SwissMaverick/PROJ-2008_SablierElectronique/2008_SablierElectronique/doc/Images/sizesmall/IMG_MJL_☣️-arnova-7-4-final_20200913_102514366.jpg

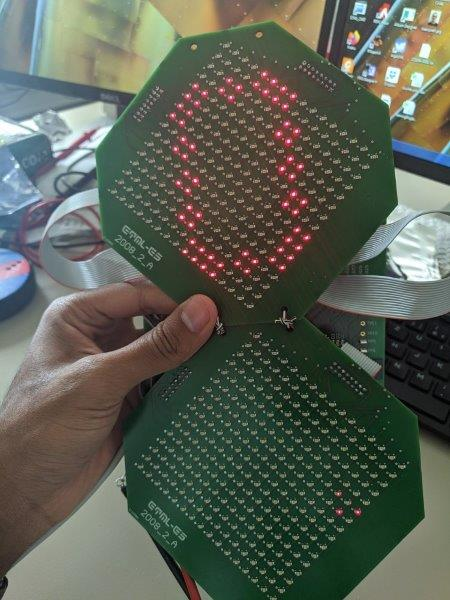
2008_SablierElectronique/doc/Images/sizesmall/IMG_MJL_☣️-arnova-7-4-final_20200913_102514366.jpg
