SwissMaverick/PROJ-2008_SablierElectronique/2008_SablierElectronique/soft/cdc_com_port_single_2008/READ ME.txt

Rodrigo Martins Silveira 

6.06.2022

Emplacement projet : C:\microchip\harmony\v2_06\apps\usb\device\cdc_com_port_single_2008
