SwissMaverick/PROJ-2008_SablierElectronique/2008_SablierElectronique/doc/PV_diplome/Procès verbal du 19.08.2020 - PBY et CRS.docx

Sujet de la séance

Procès-verbal - du 14.08.2020

Présents

Philippe Bovey

Carlos Antonio Reyes Peña

État des lieux

Le PCB est presque finis. Deux revues du schéma ont été faites.

Problèmes rencontrés

- Les capacités de découplage étaient placées sur le bottom. Il ceci c'est avéré un problème puisque ceci créais des inductances parasites.

Solutions proposées

- Le PCB ayant ce problème, je dois changer les connexions et mettre les capacités sur le top.

Décisions prises

- Le PCB sera commandé Lundi après une dernière revue

Suite du projet / objectifs

- Finir le PCB avant le 21 août 2020
- Commencer la programmation sur un kit32
- Monter le PCB
- Programmer sur la carte finale.

Prochaine réunion

28 août 2020

Destinataires de ce PV

Lausanne le 24.08.2020

Carlos Antonio Reyes Peña

Procès verbal du 19.08.2020 - PBY et CRS.docx 28.08.2020 | 2 / 1 |

Ecole supérieure, école des métiers Lausanne V.1-0 Rue de Sébeillon 12 CRS / 17.08.2020 du 28.08.2020 CH-1004 Lausanne www.etml-es.ch C:\PBO\COURS\DIPLOME\2008_SablierElectronique\Procès verbal du 19.08.2020 - PBY et CRS.docx | 1 / 1 |

ETML – Ecole supérieure
