SwissMaverick/PROJ-2008_SablierElectronique/2008_SablierElectronique/doc/Version_E/2008E_SablierElectronique-CDC-v1.docx

# Projet ETML-ES - Cahier des charges

Sablier Electronique

N° projet 2008

A remplir par l'initiateur / porteur de projet

Entreprise/Client : | ETML-ES | Département :
Demandé par (Prénom, Nom): | | Date:

A remplir par le gestionnaire de projet (étudiant)

Auteur (ETML-ES) : | Jérémie Jean-Elie | Filière : | SLO
| | Date : | 20.11.2025

# 1 But du projet

Le but de ce projet est de réaliser un sablier électronique permettant pendant les tests (travaux écrits) que les étudiants puissent visualiser le temps qu'ils leur restent à disposition.

- Le système sera alimenté par un bloc secteur universel 12VDC.
- Le sablier doit pouvoir être utilisé de manière autonome (interface utilisateur propre au boitier à l’aide de boutons et des LED du sablier) ou par une interface déportée (application C# communiquant via USB ou port série),
- En option l’étudiant pourra implémenter visualisation du sablier sur une page web via wifi.

Le programme implémenté dans le microcontrôleur devra permettre d'afficher des informations de réglage pour le sablier, gérer les différents leds (animation) et permettre une communication sérielle ou USB entre un PC et le sablier pour gérer les mêmes informations de réglage et de démarrage de séquence.

Fonctionnalités demandées

Choix de la durée du test : entre 5min et 4h

Fonction de Start/Stop

Gestion de leds quand le compte à rebours est lancé

Génération d'un son lorsque, le compte à rebours est à 0 pendant 15s et clignotement de la partie inférieure. Réglage du volume.

Une mise en boitier est demandée.

# 2 Reprise du projet

Etant donné que je reprends le projet et que celui-ci ne fonctionne que partiellement, je suis obligé de refaire en grande partie le projet.

# 3 Tâches à réaliser

## 3.1 Hardware

- Reprise du schéma existant en apportant des améliorations et corrections

- Rendre les connecteurs des matrices LED plus ergonomiques

- Corriger le câblage autour des MOSFET

- Corriger les branchements des multiplexeurs

- Corriger les câblages de la centrale inertielle

- Correction de la partie USB

- Implémenter un module ESP32 ou module similaire pour communication Wi-Fi

- Implémentation d'une alimentation avec un accu

- Recherche d’un nouveau système pour les LEDs (Utilisation d’une matrice LED déjà existante)

- Un nouveau design de carte électronique sera nécessaire

## 3.2 Software

- Implémentation communication sérielle

- Interface graphique permettant à paramétrer le sablier électronique (sur une carte déportée ou le sablier lui-même)

- Implémentation communication Wi-Fi (module ESP ou équivalent)

## 3.3 Mécanique

- Réalisation d'un boitier adapté à la nouvelle carte

# 4 Livrables

Enlever les livrables inapplicables au projet parmi la liste ci-dessous.

- Les fichiers sources de CAO électronique des PCB réalisés
- Fichiers de CAO pour le boîtier
- Tout le nécessaire à fabriquer un exemplaire hardware de chaque : fichiers de fabrication (GERBER) / liste de pièces avec références pour commande / implantation (prototype) / modifications / dessins mécaniques, etc
- Les fichiers sources de programmation microcontrôleur (.c / .h)
- Tout le nécessaire pour programmer les microcontrôleurs (logiciel ou fichier .hex)
- Le cas échéant, les fichiers sources de programmation PC/Windows/Linux.
- Le cas échéant, tout le nécessaire à l’installation de programmes sur PC/Windows/Linux.
- Un mode d’emploi du système
- Un calcul / estimation des coûts
- Un rapport contenant les calculs - dimensionnement de composants - structogramme, etc.

JJE – Nov 2025Projet-CDC-v1.docxPage 1

ECOLE SUPERIEURE PROJ – SLO
