SwissMaverick/PROJ-2008_SablierElectronique/2008_SablierElectronique/doc/Version_E/Présentation_Pre-Etude.pptx

## Projet Sablier Électronique

Rapport de Pré-Étude
Jérémie Jean-Elie | ETML-ES

## Objectifs du Projet

- • Visualiser le temps restant pour les travaux écrits (étudiants)
- • Utilisation autonome (Boutons/LEDs) ou connectée (USB/C#)
- • Option de visualisation sur page Web via Wi-Fi
- • Durée configurable de 5 min à 4 heures

## Cahier des Charges

- • Alimentation : Bloc secteur 5V ou batterie
- • Fonctionnalités : Start/Stop, Réglage volume buzzer
- • Fin de cycle : Clignotement LED + Signal sonore (15s)
- • Mécanique : Intégration dans un boîtier adapté

## État Actuel & Problématiques

- • Ce qui fonctionne : Écoulement du sable, réglage du temps
- • Défauts majeurs : Erreurs design PCB, résistance manquante
- • Manquants : Connecteurs alim/batterie, USB PC, Wi-Fi
- • Amélioration requise : Connexion matrice LEDs fragile

## Architecture Système

- • Cœur : Microcontrôleur PIC32
- • Affichage : Matrices à LEDs + Multiplexeurs
- • Capteurs : Centrale Inertielle (IAM-20680)
- • Comms : Module Wi-Fi (ESP32) & Interface USB
- • Énergie : Régulateurs Buck 3.3V

## Choix Technologiques (1/2)

- • Alimentation : Batterie LiPo/Li-Ion choisie
- - Nécessite convertisseurs DC-DC faible chute (LDO/Buck)
- • Capteur Mouvement : IAM-20680 (Centrale Inertielle)
- - Communication SPI
- - Remplace le gyroscope seul pour plus de stabilité

## Choix Technologiques (2/2)

- • Microcontrôleur : PIC32MX795F512L
- - Standard ETML (facilité de dév), Nombreuses I/O
- • Connectivité :
- - USB : Protection via chip USBLC6
- - Wi-Fi : Module ESP32 pour serveur web embarqué

## Optimisation : Commande des LEDs

- • Stratégie : Réutilisation des matrices existantes
- • Problème : Trop de MOSFETs sur la carte principale
- • Piste d'amélioration :
- - Remplacer les MOSFETs de colonnes par un Driver LED
- - Objectif : Gain de place significatif sur le PCB

## Budget et Planning

- • Budget Estimé : 123.32 CHF
- - PCB : ~80 CHF
- - Composants (PIC32, IMU, ESP32) : ~43 CHF
- • Planning : Phase de pré-étude terminée dans les délais (05.12.2025)

## Conclusion & Perspectives

- • Prochaines étapes :
- 1. Correction des erreurs de schéma (résistances, multiplexeurs)
- 2. Décision finale sur le Driver LED vs MOSFETs
- 3. Design du PCB optimisé et du boîtier
- • Objectif final : Un produit fini, autonome et connecté
