SwissMaverick/PROJ-2008_SablierElectronique/2008_SablierElectronique/README.txt

Ce dossier doit correspondre à la version B

La release corrrespondante sur Altium 365 se trouve ici (version A.2 à changer en C pour la prochaine version):

https://etml-es.365.altium.com/designs/B09EF2AC-12B8-46C2-9F97-39898C16922C/history
