SwissMaverick/PROJ-2008_SablierElectronique/2008_SablierElectronique/doc/Version_E/Rendus/2008E_SablierElectrique-Planning.pdf

No semaine projet | 1 | 2 | 3 | 4 | 5 | 6 | | | 7 | 8 | 9 | 10 | 11 | | 12 | 13 | 14 | 15 | 16 | 17 | 18 | | | 19 | 20 | 21 | 22 | 23 | 24 | 25 | 26 | 27 | 28
No semaine | 46 | 47 | 48 | 49 | 50 | 51 | 52 | 1 | 2 | 3 | 4 | 5 | 6 | 7 | 8 | 9 | 10 | 11 | 12 | 13 | 14 | 15 | 16 | 17 | 18 | 19 | 20 | 21 | 22 | 23 | 24 | 25 | 26

Date

Tâches | | | | | | | V | V | | | | | | V | | | | | | | | V | V
Pré-étude | Theorique | | | | R | P
| Réel
Design + Schéma | Theorique | | | | | | | | | | | R | P
| Réel
PCB | Theorique | | | | | | | | | | | | | | | | | | | R
| Réel
Commande PCB et composants | Théorique
| Réel
Design boitier | Théorique
| Réel
Montage | Theorique
| Réel
Software/Firmware | Theorique
| Réel
Tests et mise au point | Theorique
| Réel
Rédaction du rapport | Theorique
| Réel
Préparation présentation et démo | Theorique
| Réel
Présentation finale | Theorique | | | | | | | | | | | | | | | | | | | | | | | | | | | | | | | R | P
| Réel
Finalisation/corrections/documentation | Theorique
| Réel

13.02.2026

03.04.2023

10.04.2023

17.04.2023

24.04.2023

01.05.2023

08.05.2023

15.05.2023

22.05.2023

29.05.2023

05.06.2023

14.11.2025

21.11.2025

28.11.2025

05.12.2025

12.12.2025

19.12.2025

26.12.2025

02.01.2026

09.01.2026

16.01.2026

23.01.2026

30.01.2026

06.02.2026

20.02.2023

27.02.2023

06.03.2023

13.03.2023

20.03.2023

27.03.2023

12.06.2023

19.06.2023

26.06.2023
