SwissMaverick/PROJ-2008_SablierElectronique/2008_SablierElectronique/doc/Version_A/2008_SablierElectronique-MOD-POBJ-V1.2.docx

# Projet ETML-ES – Modification POBJ

A remplir par l'initiateur

PROJET: | Sablier Electronique
Entreprise/Client: | ETML-ES | Département: | SLO
Demandé par (Prénom, Nom): | Philippe Bovey | Date:
Objet (No ou réf, pièce, PCB...) | 2008
Version à modifier: | V1.0

A remplir par l'exécutant

Auteur (ETML-ES): | Antonio Do Carmo | Filière: | SLO
Nouvelle version: | V1.1 | Date: | 15.04.2024

# 1 Projet

## 1.1 Description sommaire du projet à modifier

Le sablier électronique est un dispositif permettant pendant les tests (travaux écrits) que les étudiants puissent visualiser le temps qu'il leur reste à disposition. Le système est alimenté par un bloc universel 12VDC et peut être utilisé de manière autonome (interface utilisateur propre au boitier) ou par une interface déportée (application C#).

## 1.2 Référence conception

Disponibles dans le dossier du projet :

K:/ES/PROJETS/SLO/2008_SablierElectronique

# 2 Objectifs principaux des modifications ou ajouts

Implémentation de la partie USB (contrôle de la famille du PIC) ou algorithme d’une communication sérielle => communication avec un PC => possibilité d’utiliser le StarterKit de l’ES pour implémenter la partie USB

Implémentation communication avec module Bluetooth et vérification du fonctionnement du module Bluetooth.

# 3 Résumé de l’état actuel

Selon la documentation du projet, la carte devrait être fonctionnelle malgré le fait que l’USB et le Bluetooth ne soient pas encore implémentés. Cependant, le circuit ne réagit pas lorsqu’il est alimenté. Aucune LED ne s’allume. Le code du projet ne compile également pas. Il est donc pour l’instant impossible de vérifier le bon fonctionnement du système.

# 4 Tâches à réaliser

## 4.1 Livrables

Je dois livrer si possible un code fonctionnel et compilable. Si cela n’est pas faisable dans les délais, je dois tout de même simplifier le code réalisé par mon prédécesseur afin que celui-ci soit compréhensible et lisible.

## 4.2 Table des tâches à réaliser

# | Priorité | Description | Fait | Approuvé

1 | 1 | Prendre connaissance du rapport de conception du projet | OK | -
2 | 1 | Prendre connaissance des datasheet des composants principaux du projet | OK | -
3 | 1 | Vérifier le fonctionnement de la carte | OK | -
4 | 1 | Trouver la panne et dépanner la carte | OK | -
5 | 2 | Rendre le code du projet compilable | OK | -
6 | 2 | Améliorer la lisibilité du code | NOK | -
7 | 3 | Créer le structogramme de la partie USB | NOK | -
8 | 3 | Implémenter la partie USB | NOK | -
9 | 3 | Vérifier le fonctionnement de la partie USB | NOK | -
10 | 3 | Créer le structogramme de la communication avec le module Bluetooth | NOK | -
11 | 3 | Implémenter la communication avec le module Bluetooth | NOK | -
12 | 3 | Vérifier le fonctionnement de la communication avec le module Bluetooth | NOK | -

# 5 Détail des modifications ou ajouts

Les tâches suivantes ont déjà été réalisées par mon prédécesseur

# | Description | Fait | Approuvé par ADO

1 | Conception du schéma électrique du projet | OK | OK
2 | Conception du PCB | OK | OK
3 | Assemblage du PCB | OK | OK
4 | Modifications sur le PCB | OK | OK
5 | Firmware du projet | OK | NOK
6 | Rapport de conception | OK | OK

# 6 Matériel nécessaire

Pour réaliser ce projet, j’aurai besoin des trois PCB assemblés du projet, du StarterKit de l’ES, du programmateur de la carte, du logiciel MPLABX et de toute la documentation disponible du projet. J’aurai également besoin d’un oscilloscope et d’un multimètre afin de dépanner la carte.

## 6.1 Stockage du fichier

Ce fichier sera stocké à la racine du dossier /doc d’un projet.

Ainsi, tous les fichiers de modifications des pièces ou PCBs faisant partie du projet sont centralisés dans le même répertoire. La numérotation devient implicite.

## 6.2 Stockage des logiciels

Les codes sources sont stockés ici :

K:/ES/PROJETS/SLO/2008_SablierElectronique/soft

Lausanne, le 15.04.2024 Antonio Do Carmo

ADO – Mar 20242008_SablierElectronique-MOD-V1.1.docxPage 1

ECOLE SUPERIEURE POBJ – SLO
