SwissMaverick/PROJ-2008_SablierElectronique/2008_SablierElectronique/archive/soft/Version_C/2008_SablierElectronique-MOD-v1.docx

# Projet ETML-ES – Modification

Note: Les textes explicatifs en italique peuvent être supprimés

A remplir par l'initiateur

PROJET:
Entreprise/Client: | | Département:
Demandé par (Prénom, Nom): | | Date:
Objet (No ou réf, pièce, PCB...)
Version à modifier:

A remplir par l'exécutant

Auteur (ETML-ES): | Rodrigo Martins Silveira | Filière: | SLO
Nouvelle version: | C | Date: | 27.06.2022

# 1 Description ou justification

Décrire ici en quelques lignes les raisons des modifications, améliorations, justifications.
Pour entreprises, si confidentiel, svp, mentionner CONFIDENTIEL.

# 2 Référence conception

Indiquer ici le(s) dossier(s) de conception de référence et emplacement. (N/A pour entreprises)

# 3 Détail des modifications

Chaque rangée du tableau ci-dessous contient le détail d'une seule modification.

Exemples:
- 1 / Changer tous les boîtiers de résistances 0805 en 0603 / OK / JMO
- 2 / Remplacement U4 - TL074 par LM124 / NOK / SCA

# | Description | Fait | Approuvé

1 | Ajouter le composant D5 (511-USBEC6-2P6) | NOK
2
3
4
5
6
7
8

# 4 Remarques

Au besoin, indiquer ici des détails nécessaires à la compréhension, ainsi que les raisons d'une modification non effectuée ou reportée.
Exemple: Le point 2 (marqué NOK), est reporté pour une prochaine version pour épuiser notre stock de composants. Cette modif n'est pas critique fonctionnellement.

# 5 Convention de nommage et liens

Le nom de ce fichier doit être unique et doit donc contenir le numéro du projet et un numéro consécutif de modification avec le format suivant :

aaii_MOD_nn.docx

ou

NomProjet_MOD_nn.docx

avec :

- MOD : pour modification
- aaii : numéro de projet, exemple 1708 pour projet de 2017 no 08
- NomProjet : Si le projet n’est pas numéroté ou mandat de client.
- nn : numéro de modification. La première est 01

Exemples :

- 1708_MOD_01.docx 1ere modification pour le projet 1708
- 1708_MOD_02.docx 2e modification pour le projet 1708
- CapteurVolets_MOD_01.docx Cas de projet externe

Le schéma et/ou les documents de production de la pièce ou du PCB se référeront à ce document dans les cartouches.

Si un nouveau projet reprend un design d’un autre projet, créer un document de modification numéro 00. Ainsi, on pourra décrire les modifications initiales dans le fichier.

Exemple :

- 1803_MOD_00.docx Modification initiale pour le nouveau projet 1803 à partir d’un autre projet (par ex. 1708)

## 5.1 Stockage du fichier

Ce fichier sera stocké à la racine du dossier /doc d’un projet.

Ainsi, tous les fichiers de modifications des pièces ou PCBs faisant partie du projet sont centralisés dans le même répertoire. La numérotation devient implicite.

JMO – Nov 2018Projet-MOD-v1.docxPage 1

ECOLE SUPERIEURE ELCO – SLO
