SwissMaverick/PROJ-2008_SablierElectronique/2008_SablierElectronique/doc/Images/Communication SPI.png

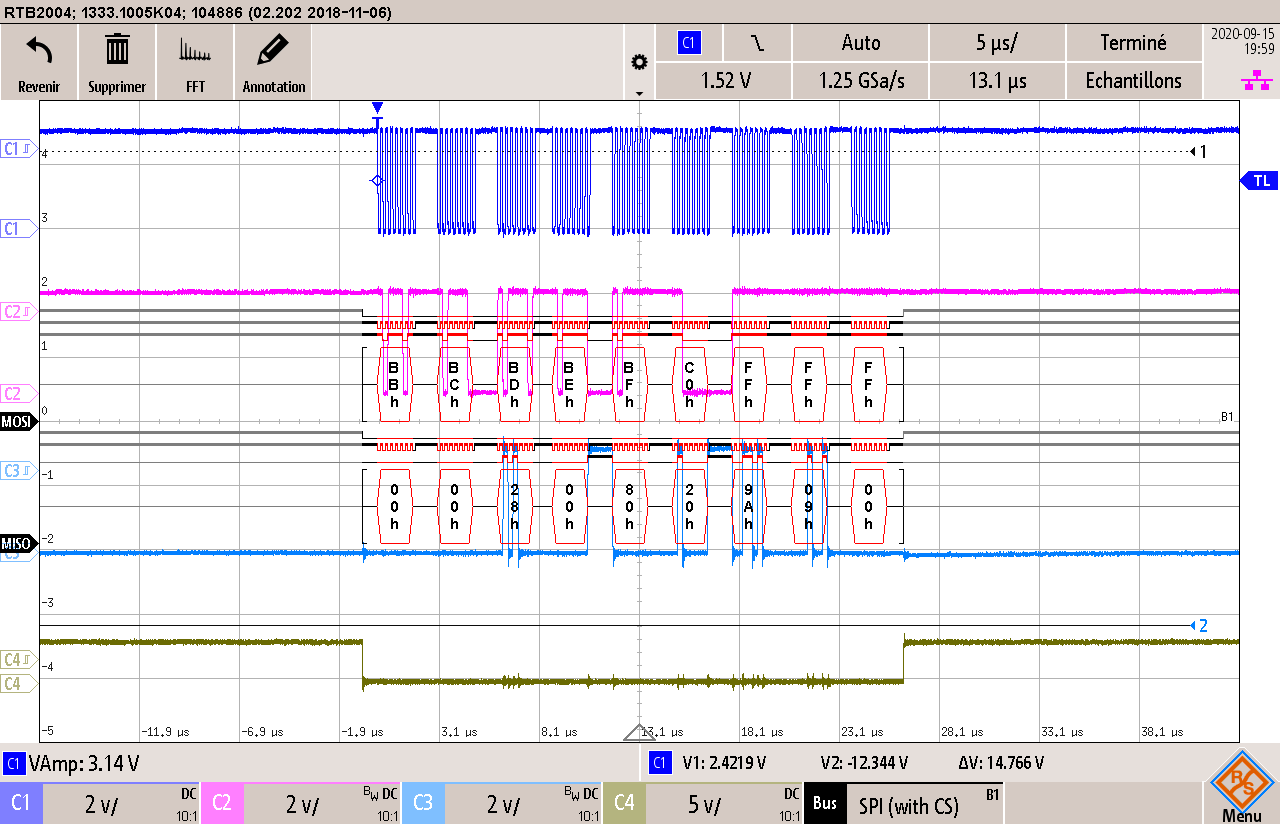
2008_SablierElectronique/doc/Images/Communication SPI.png
