SwissMaverick/PROJ-2008_SablierElectronique/2008_SablierElectronique/doc/Images/medium/IMG_MJL_☣️-arnova-7-4-final_20200913_102445338.jpg

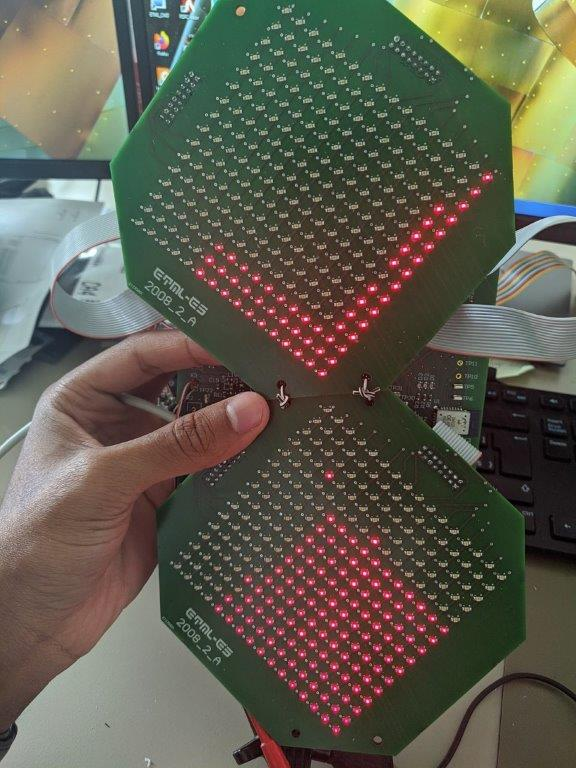
2008_SablierElectronique/doc/Images/medium/IMG_MJL_☣️-arnova-7-4-final_20200913_102445338.jpg
