SwissMaverick/PROJ-2008_SablierElectronique/2008_SablierElectronique/doc/Images/Oscillation.png

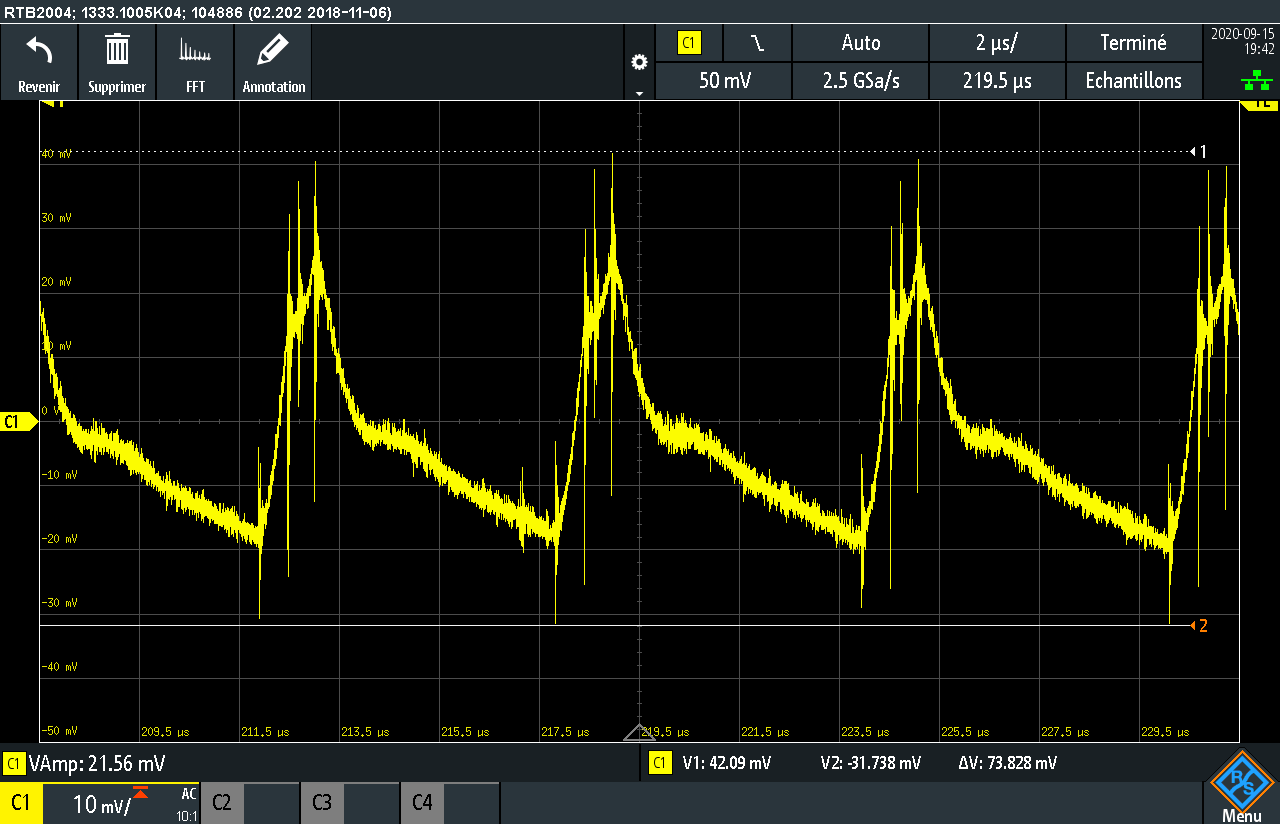
2008_SablierElectronique/doc/Images/Oscillation.png
