SwissMaverick/PROJ-2008_SablierElectronique/2008_SablierElectronique/doc/Images/sablier_dessin.png

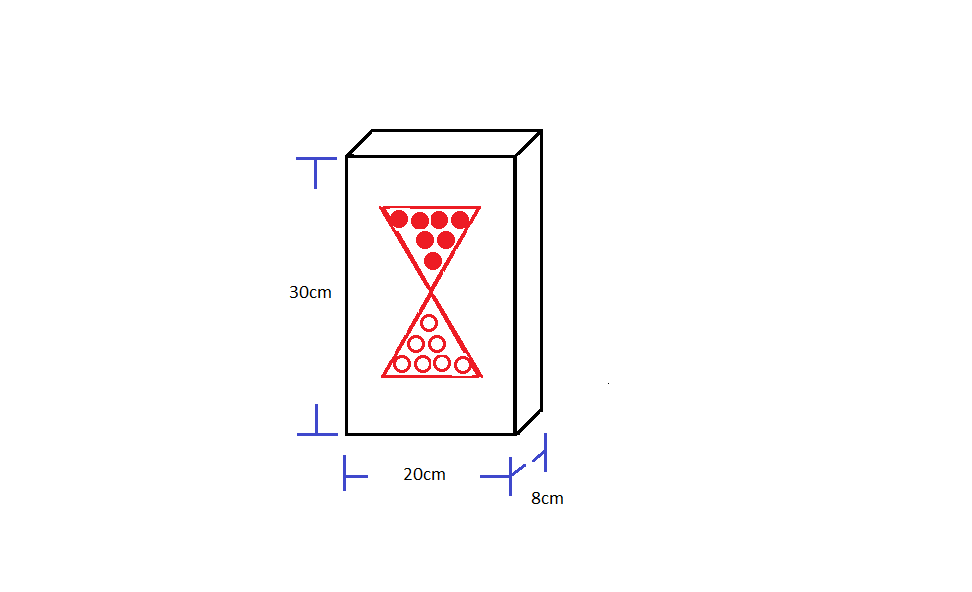
2008_SablierElectronique/doc/Images/sablier_dessin.png
