SwissMaverick/PROJ-2008_SablierElectronique/2008_SablierElectronique/doc/Version_E/Screenshots/ConfigClock2.png

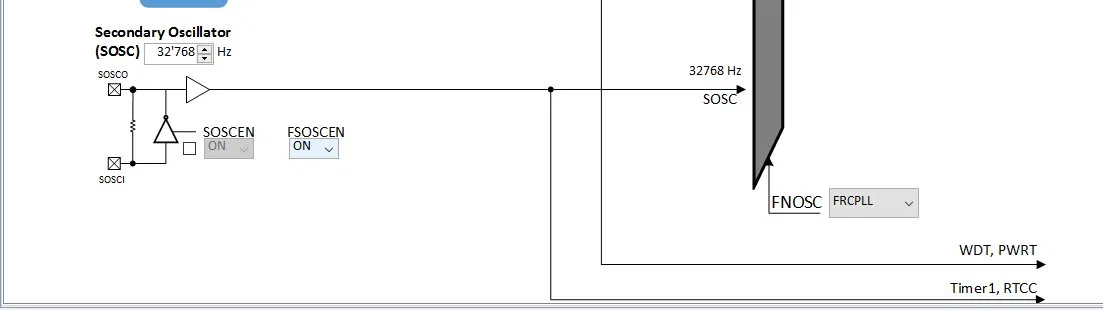
2008_SablierElectronique/doc/Version_E/Screenshots/ConfigClock2.png
