SwissMaverick/PROJ-2008_SablierElectronique/2008_SablierElectronique/soft/getXY.png

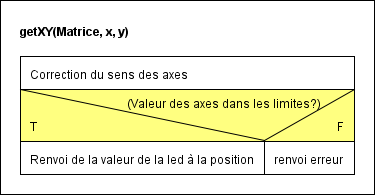
2008_SablierElectronique/soft/getXY.png
