SwissMaverick/PROJ-2008_SablierElectronique/2008_SablierElectronique/soft/setXY.png

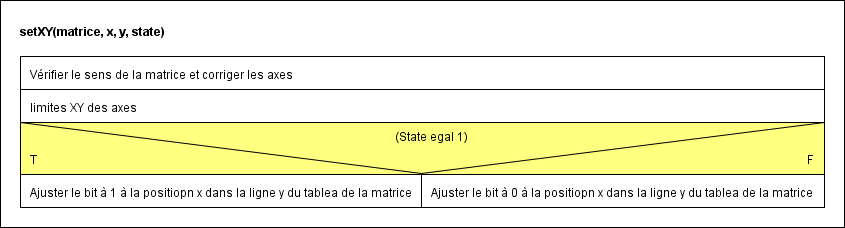
2008_SablierElectronique/soft/setXY.png
