SwissMaverick/PROJ-2008_SablierElectronique/2008_SablierElectronique/hard/2008_SablierElectronique_PCB/Project Outputs for 2008_SablierElectronique/DesignDocs/Bill of Materials.PDF

Comment | Description | Designator | Footprint | LibRef | Quantity
10uF | | C1, C12, C15 | RESC0805(2012)_LCAP1206 | | 3
4.7uF | | C2 | RESC0805(2012)_LCAP1206 | | 1
10nF | | C3 | RESC0805(2012)_LCAP1206 | | 1
100nF | | C4, C5, C6, C7, C8, CRES C0805(2012)_L CAP 1206 | | | 12
22uF | | C16 | RESC0805(2012)_LCAP1206 | | 1
KPT-2012SRC-PRV | | D1, D2, D3 | 0805_LED | KPT-2012SRC-PRV | 3
SD0805S040S0R1 | Diode Schottky 40VD 4 | | DIO SC130X 200X100- SD0805S040S0R1 | | 1
USBLC6-2P6 | | D5 | FP-SOT-666-MFG | USBLC6-2P6 | 1
Jumper | | J1 | Jumper | Jumper_2p | 1
LQM21PN1R0MCHDLQM21PN1R0MCHDL1 | | | RESC0805(2012)_L744311100 | | 1
CMI-1295IC-0385T12 mm, 3 Vdc, 85 | | dLS 1 | CUI_CMI -1295I C-0385T CMI -1295I C-0385T | | 1
Mosfet-N | | Q1, Q2, Q3, Q4, QF AIR- SOT 23-3_V | | NEMO S-G SD-3_D | 33
Mosfet P | | Q34, Q35, Q36, Q37, FAIR- SOT23- 3_V | | Mos fet P | 32
680 | | R1, R2, R3, R14, R15, RESC 0805(2012)_L RE S | | | 35
51k | | R4 | RESC0805(2012)_LRES | | 1
100k | | R5, R13 | RESC0805(2012)_LRES | | 2
10k | | R6, R7, R8, R9 | RESC0805(2012)_LRES | | 4
1k | | R10 | RESC0805(2012)_LRES | | 1
1M | | R11 | RESC0805(2012)_LRES | | 1
453k | | R12 | RESC0805(2012)_LRES | | 1
Bouton HAUT | Switch Surface MouS1 | | Header 2 pin | Switch SMD | 1
Bouton BAS | Switch Surface MouS2 | | Header 2 pin | Switch SMD | 1
Bouton H/M/S | Switch Surface MouS3 | | Header 2 pin | Switch SMD | 1
FSM4JH | Switch Push ButtonS4 | | SW_FSM4J H | FS M4JH | 1
5019 | Test point smd | TP1, TP2, TP3, TP4, T TEST POIN T_SMD | | TE STPO INT | 23
5019 | Test point smd | TP10, TP11, TP12, TTES TPOIN T_SMD _VTES TPOINT_via | | | 8
MCHP-RN4020-MODULE-24 | | U1 | MCHP-MODULE-24_VMCHP-RN4020-MO | | 1
MC-32B-MX795-SQ100 | | U2 | TQFP-PT100_N | MC-32B-MX795-SQ | 1
STM-L3GD20H-LGA-16_A | | U3 | STM-LGA-16 | STM-L3GD20H-LGA | 1
TLV62585PDRLR | 2.5V-5.5V input, 3-U4 | | SOT563 | T LV 62585P D RL R | 1
CD74HCT4067 | | U5, U6 | SOIC24 | CD74HCT4067 | 2
ICD | | X1 | CON6 | Header 6 pins | 1
USB | | X2 | CON4 | Header 4 pin | 1
Alimentation | Connector Header | X3 | Header 2 pin | Header 2 pin | 1
Lignes haut | | X4 | CON8x8(edited) | Mâle DIN 8 x 8 | 1
Lignes bas | | X5 | CON8x8(edited) | Mâle DIN 8 x 8 | 1
Colonnes haut | | X6 | CON8x8(edited) | Mâle DIN 8 x 8 | 1
Colonnes bas | | X7 | CON8x8(edited) | Mâle DIN 8 x 8 | 1
