SwissMaverick/PROJ-2008_SablierElectronique/ComposantsStandardsES.xlsx

Sheet: Comp Standard - PROJ-DIPL
MCUs
Fabricant | Composant | Boîtier | Description | Emplacement | Stock | Distributeur 1 | Distrbuteur 1 ref | Distributeur 2 | Distrbuteur 2 ref | Remarque
Microchip | PIC32MX130F064B | 28-pin SSOP | PIC32 40MHz 16kRAM, 256kFlash | D2 | 10+ | Digi-Key | PIC32MX130F064B-I/SS-ND | Mouser | 579-MX130F064BISS
 | PIC32MX130F256B | 28-pin SSOP | PIC32 40 MHz 16kRAM, 256kFlash | D2 | 0 | Digi-Key | PIC32MX130F256B-I/SS-ND | Mouser | 579-MX130F256BISS
 | PIC32MX130F064B | 28-pin SOIC | PIC32 40MHz 16kRAM, 256kFlash | D2 | 6 | Digi-Key | PIC32MX130F064B-I/SO-ND
 | PIC32MX230F256D-I/PT | 44-pin TQFP | PIC32 40MHz 16kRAM, 256kFlash | D2 | 40 | Digi-Key | PIC32MX230F256D-I/PT-ND | Mouser | 579-MX230F256DIPT
 | PIC32MX340F512H | 64-pin TQFP | PIC32 80 MHz 23kRAM, 512kFlash | D3 | 1 | Digi-Key
 | PIC32MX795F512H | 64-pin TQFP | PIC32 80 MHz 128kRAM, 512kFlash | D2 | 8 | Digi-Key
 | PIC32MX795F512L | 100-pin TQFP | PIC32 80MHz 128kRAM, 512kFlash | D2 | 3 | Digi-Key | PIC32MX795F512LT-80I/PTCT-ND |  |  | MCU kit MINF
 | PIC32MK0512MFC064 | 64-pin TQFP | PIC32 128kRAM, 512kFlash, Motor Control | D2 | 9 | Digi-Key | PIC32MK0512MCF064-I/PT-ND
 | PIC32MM0064GPL020-I/SS | 20-pin SSOP | PIC32 8KB RAM, 64kFlash, low power | D2 | 9 |  |  | Mouser | 579-MM0064GPL020ISS
STMicroelectronics | STM32F051R8T6 | 64-pin TQFP | MCU ARM STM32 Cortex-M0, 32 bits, 48 MHz, 64 KB | D2 | 20 | Farnell | 3129877 |  |  | MCU kit ELNU02
Composants électromécaniques - Connecteurs - Points test - Switches
Fabricant | Composant | Boîtier | Description | Emplacement | Stock | Distributeur 1 | Distrbuteur 1 ref | Distributeur 2 | Distrbuteur 2 ref | Remarque
Amphenol | 76384-406LF | 6pin mâle | Dubox pour Port de programmation PIC32 (voir onglet) | D1 | 10+ | Digi-Key | 76384-406LF
Keystone Electronics | 5017 |  | PC TEST POINT MINIATURE | D1 |  | Digi-Key | 36-5017CT-ND
Keystone Electronics | 5019 |  | PC TEST POINT MINIATURE | Bobine étagère |  | Digi-Key | 36-5019CT-ND
Schurter | 1241.1082 |  | SWITCH TACT SPST-NO 0.125A 48V (MTG Series) | D1 | 10+ | Digi-Key | chercher 1241.1082
Wurth Electronics Inc. | 430182043816 |  | SWITCH TACTILE SPST-NO 0.05A 12V | D1 | 50 | Digi-Key | 732-7004-1-ND
Wurth Electronics Inc. | 629105136821 |  | CONN RCPT USB2.0 MICRO B SMD R/A | D1 | 10 | Digi-Key | 732-3155-1-ND
Wurth Electronics Inc. | 629105150521 | signaux SMT, chassis trou traversant | CONN RCPT USB2.0 MICRO B SMD R/A | D1 | 0 | Digi-Key | 732-5960-1-ND
Composants de base - RESISTANCES - COND- SELFS - BJT - MOS - DIODES - LED
Fabricant | Composant | Boîtier | Description | Emplacement | Stock | Distributeur 1 | Distrbuteur 1 ref | Distributeur 2 | Distrbuteur 2 ref | Remarque
 | RES 0Ω | 0805 | Résistance pont | Bobine étagère
 | RES 10Ω - 10MΩ | 0805 | Gamme de Résistances série E24 | Bobines étagère
 | CAP 10/22/100 pF | 0805 | Gamme Capacités en pF /50V | Bobines étagère
 | CAP 1/2.2/10/100 nF | 0805 | Gamme Capacités en nF /50V | Bobines étagère
 | CAP 1/10 uF | 0805 | Gamme Capacités en uF /10V | Bobines étagère
Panasonic | CAP 10 uF / 16V | SMD D4 x L5.4 | CAP polarisé électrolytique EEEFC1C100R | Bobine étagère
Panasonic | CAP 100 uF / 16V | SMD D8 x L5.8 | CAP polarisé électrolytique EEEFC1C101P | Bobine étagère
Panasonic | CAP 100 uF / 35V | SMD D10 x L10.2 | CAP polarisé électrolytique EEEFC1V101P | Bobine étagère
Panasonic | CAP 220 uF / 35V | SMD D4 x L5.7 | CAP polarisé électrolytique EEEFC1V221P | Bobine étagère
Bourns | Self 150uH -SDR0604-151KL |  | FIXED IND 150UH 400MA 1.1OHM SMD | Bobine étagère |  |  | SDR0604-151KLCT-ND
OSRAM | LH R974 | CHIPLED 0805 | LED hyper red | Bobine étagère
OSRAM | LY R971 | CHIPLED 0805 | LED yellow | Bobine étagère
OSRAM | LG R971 | CHIPLED 0805 | LED green | Bobine étagère
LittleFuse | TVS SMAJ5.0A |  | TVS DIODE 5V 9.2V DO214AC | Bobine étagère |  |  | SMAJ5.0ALFCT-ND
STMicroelectronics | BC847B |  | TRANS NPN 45V 0.1A SOT-23 | Bobine étagère |  |  | 497-2524-1-ND
STMicroelectronics | BC857B |  | TRANS PNP 45V 0.1A SOT23 | Bobine étagère |  |  | 497-2526-1-ND
International Rectifier | IRLML2402PbF | SOT23-3 | MOSFET N-CH 20V 1,2A SOT-23 logic level | Bobine étagère
ON semiconductor | BSS138 | SOT23-3 | MOSFET N-CH 50V 220MA SOT-23 | D1 | 20+ | Digi-Key | BSS138CT-ND
ON semiconductor | BAS40 | SOT23-3 | DIODE SCHOTTKY 40V 120MA BAS40LT1G | Bobine étagère |  | Digi-Key | BAS40LT1GOSCT-ND
ON semiconductor | SS14 |  | DIODE SCHOTTKY 40V 1A | Bobine étagère |  | Digi-Key | SS14CT-ND
ON semiconductor | BAS16 |  | DIODE GEN PURP 85V 200MA SOT23-3 | Bobine étagère |  |  | BAS16FSCT-ND
 | 1N5819 |  | DIODE SCHOTTKY 40V 1A
Micro Commercial | 1N4448W-TP | SOD-123 | DIODE GEN PURP 75V 250MA | D1 |  | Digi-key | 1N4448WTPMSCT-ND
Diodes Incorporated | D5V0P4UR6SO-7 | SOT-23-6 | TVS DIODE 3.3VWM 6VC SOT26 (4 channels) | D1 |  | Digi-Key | D5V0P4UR6SO-7DICT-ND | Mouser | 621-D5V0P4UR6SO-7
Wurth Electronics Inc. | 8240136 | SOT-143-4 | TVS DIODE 3.3V 6V SOT143-4 (2 channels) | D1 |  | Digi-Key | 732-4472-1-ND | Mouser | 710-8240136
STMicroelectronics | USBLC6-2SC6 | SOT-23-6 | TVS DIODE 5.25V 17V SOT23-6 (2 data-line) | D1 |  | Digi-Key | 497-5235-1-ND
Nexperia+divers | BAT54S | SOT-23 | Schottky diode dual | A stocker |  | Mouser | 771-BAT54S-T/R
IC analogiques - OP AMP - COMP.
Fabricant | Composant | Boîtier | Description | Emplacement | Stock | Distributeur 1 | Distrbuteur 1 ref | Distributeur 2 | Distrbuteur 2 ref | Remarque
STMicroelectronics | LF347 | 14-SOIC | IC AOP LF347M - WIDE BW- 4x J-FET OP AMP | D1 | 25+ | Digi-Key | 497-2963-2-ND
Texas Instruments | LM339MX/NOPB | 14-SOIC | IC COMPARATOR QUAD LO PWR 14SOIC | D1 | 50+ | Digi-Key | LM339MX/NOPBCT-ND
Texas Instruments | LM385M/NOPB | 14-SOIC | IC VREF SHUNT 5.3V 2% 8SOIC | D1 | 50+ | Digi-Key | LM385M/NOPB-ND
ICs spécialisés
Fabricant | Composant | Boîtier | Description | Emplacement | Stock | Distributeur 1 | Distrbuteur 1 ref | Distributeur 2 | Distrbuteur 2 ref | Remarque
Microchip | MCP79411T-I/SN | 8-SOIC | IC RTC CLK/CALENDAR I2C |  |  | Digi-Key | MCP79411T-I/SNCT-ND
EPSON | FC-135 32.7680KA-K3 |  | CRYSTAL 32.7680 KHZ 10.0PF SMD |  |  | Digi-Key | SER4088CT-ND
EPSON | FC-135 32.7680KA-A5 |  | CRYSTAL 32.7680 KHZ 12.5PF SMD |  |  | Digi-Key | SER4103CT-ND
ON semiconductor | LV8760-TLM-E | 20TSSOP | IC MOTOR DRIVER 3V-5.5V/9-35V - w/ Current Limiter |  |  | Digi-Key | 869-1256-1-ND
Maxim | MAX7219CWG+-ND | 24-SOIC | IC DRVR 7 SEGMNT 8 DIGIT |  |  | Digi-key | MAX7219CWG+-ND
Microchip | MCP3422 | 8-SOIC | ADC 18-BIT SIGMA-DELTA |  | 10+ | Digi-Key | MCP3422A0-E/SN-ND
FTDI | FT230XS | 16-TSSOP | USB SERIAL BASIC UART 16SSOP |  | 5+ | Digi-Key | 768-1154-5-ND | Mouser | 895-FT230XS-U
Cypress | CY7C64225 | 28-TSSOP | UST to UART bridge |  | 5+ | Digi-Key | CY7C64225-28PVXC
Texas Instruments | TLC555CDR | 8-SOIC | IC OSC SGL TIMER 2.1MHZ 8-SOIC |  | 5 | Digi-Key | 296-1336-2-ND
Circuits et composants d'alimentation
Fabricant | Composant | Boîtier | Description | Emplacement | Stock | Distributeur 1 | Distrbuteur 1 ref | Distributeur 2 | Distrbuteur 2 ref | Remarque
Texas Instruments | LM2674MX-5.0/NOPB | 8-SOIC | IC REG BUCK 5.0V 500MA 8SOIC | D1 |  | Digi-key | LM2674MX-5.0/NOPBCT-ND
Texas Instruments | LM2674MX-3.3/NOPB | 8-SOIC | IC REG BUCK 3.3V 500MA 8SOIC | D1 | 15 | Digi-key | LM2674MX-3.3/NOPBCT-ND
Texas Instruments | LM2674MX-ADJ/NOPB | 8-SOIC | IC REG BUCK ADJ 500MA 8SOIC | D1 |  | Digi-key | LM2674MX-ADJ/NOPBCT-ND
Texas Instruments | LM2675M-5.0 | 8-SOIC | IC REG BUCK 5V 1A 8SOIC | C4 | 20+ | Digi-key | LM2675M-5.0-ND
Texas Instruments | LM3578-AM | 8-SOIC | IC REG MULTI CONFG 750MA - Buck/Boost positive/negative | C4 | 20+ | Digi-key | LM3578AM/NOPB-ND
Microchip | MIC5504-3.3YM5-TR | SO-T23-5 | IC REG LINEAR 3.3V 300MA | D1 |  | Digi-key | 576-4764-1-ND
Microchip | MCP73871-2CC | 20-QFN (4x4) | USB/AC BATTERY CHARGER | D1 |  | Digi-key | MCP73871T-2CCI/ML |  |  | Attention plusieurs variantes d'IC selon la tension del'accu Li
Maxim | MAX1793EUE33+ | 16TSSOP | IC REG LINEAR POS ADJ 1A | D1 |  | Digi-Key | MAX1793EUE33+-ND
Wurth Electronics Inc. | 173950336 | Module 3-SIP | DC DC CONVERTER 3.3V 0.5A | D1 |  | Digi-Key | 732-173950336-ND
Wurth Electronics Inc. | 173950536 | Module 3-SIP | DC DC CONVERTER 5.0V 0.5A | D1 |  | Digi-Key | 732-173950536-ND
Autres
Fabricant | Composant | Boîtier | Description | Emplacement | Stock | Distributeur 1 | Distrbuteur 1 ref | Distributeur 2 | Distrbuteur 2 ref | Remarque
Digi-Key | PCB-RULER-12INCH | NA |  | Bureau JMO |  | Digi-Key | PCB-RULER-ND

Sheet: Port de programmation PIC32
Pin 1 = MCLR

Sheet: Composants A3
Fabricant | Composant | Boîtier | Description | Emplacement | Stock | Distributeur 1 | Distrbuteur 1 ref | Distributeur 2 | Distrbuteur 2 ref | Remarque
Siemens | TCA 965 | 14-DIP | Window Discriminator | A3 | 10
Texas Instruments | TLC251 | 8-DIP | LinCMOS LOW-POWER A.O | A3 | 4
Texas Instruments | TLC271 | 8-DIP | LinCMOS LOW POWER A.O | A3 | 9
Texas Instruments | TLC274 | 14-DIP | LinCMOS PRECISION QUAD A.O | A3 | 2
Texas Instruments | TLC555 | 8-DIP | LinCMOS Timer | A3 | 5
Texas Instruments | TLC556 | 17-DIP | DUAL LinCMOS Timers | A3 | 12
Texas Instruments | TL071 | 8-DIP | Low-Noise FET-Input A.O | A3 | 13
Texas Instruments | TL074 | 14-DIP | Low-Noise FET-Input A.O | A3 | 20+
Texas Instruments | TLC374CN | 14-DIP | LinCMOS Quad. Differential Comp. | A3 | 2
MAXLINEAR | 2208CP | 14-DIP | Operational Multiplier | A3 | 2
maxim integrated | TSC428 | 8-DIP | MOSFET DRIVER | A3 | 20+
maxim integrated | TSC429 | 8-DIP | MOSFET DRIVER | A3 | 14
maxim integrated | TSC426 | 8-DIP | MOSFET DRIVER | A3 | 10
Linear technology | LM308H | Metal case H pack | Amplificateur opérationel, single Bip | A3 | 30+
Texas Instruments | LM311P | 8-DIP | IC DIFF COMP W/STROBE 8DIP | A3 | 10+ | Digi-Key | 296-1389-5-ND
Texas Instruments | LM319N | 14-Pins CDIP | High Speed Dual Comparator | A3 | 1
Texas Instruments | LM317H | Metal Can Package 3-Pin | Temperature Three-Pin Adjustable Regulator | A3 | 4
Texas Instruments | LM339AN | 14-Pin CLGA | Quad Comparators | A3 | 10+
Texas Instruments | LM324AN | 14-Pin SOIC | Operational Amplifiers | A3 | 10+
Motorola semiconductor | LM339NE4-ND | 14-DIP | Comparator-linear | A3 | 10+ | Digi-Key
Texas Instruments | LM347N | 14-DIP | Hysteretic PFET Buck Controlle | A3 | 6
Texas Instruments | LM358N | 8-SOIC | IC OPAMP GP 2 CIRCUIT 8DIP | A3 | 20+ | Digi-Key | LM358NNS/NOPB-ND
National Semiconducteur Comporation | LM377N | 14-DIP | 2 watt audio AMplifier | A3 | 6
National Semiconducteur Comporation | LM390N | Dual-In-Line Package | 1W Battery Operated Audio Power Amplifier | A3 | 10+
Texas Instruments | TLC556N | 14-DIP | DUAL LinCMOS TIMERS | A3 | 7
STMicroelectronics | LM317T | TO-220 | 1.2 V to 37 V adjustable voltage regulators | A3 | 20+
STMicroelectronics | L6506A | 18-DIP | CURRENT CONTROLLER FOR STEPPING MOTORS | A3 | 5
Texas Instruments | LF412CP | 8-DIP | Dual JFET-input Operational Amplifier | A3 | 6
Linear technology | LM108AH | Metal case H pack | AOP | A3 | 10+
STMicroelectronics | LM335Z | TO-92 | Precision temperature sensors | A3 | 10
Texas Instruments | LM6364N | 8-DIP | High Speed Operational Amplifier | A3 | 1
Texas Instruments | LM6134 | 14-Dip | Low Power 10 MHz Rail-To-Rail, AOP | A3 | 6
Texas Instruments | LM297 | 20-Dip | STEPPER MOTOR CONTROLLERS | A3 | 3
Texas Instruments | P9330-ADC0804LCN | 20-Dip | 8-Bit, µP-Compatible, Analog-to-Digital Converters | A3 | 1
Philips | TDA1010A | SIL-9 | Audio Power Amplifier | A3 | 3
plessey | TDA2090 | 14-DIP | Zero Voltage Switch | A3 | 9
Texas Instruments | LM336 | 8-SOIC | Shunt Regulator Diode | A3 | 4
STMicroelectronics | L292 |  | Switch-Mode Driver DC Motors | A3 | 1
Texas Instruments | LF398 |  | Monolithic Sample-and-Hold Circuits | A3 | 4
philips | SAA 1027 |  | Stepper Motor Drive Circuit | A3 | 2
Thomson | UAA4006B |  | Switch Mode Power Supply Control Circuit | A3 | 4
Intersill | ICL 7650 SCPD |  | Super Chopper-Stabilized A.O. | A3 | 2
Texas Instruments | ULN2003 AM |  | High-Current Darlington Transistor Arrays | A3 | 20+
 | ULN2803 |  | Darlington Transistor Arrays | A3 | 17
 | PLL NE 565 |  | Phase-Locked Loop | A3 | 16
Texas Instruments | UC3637 |  | Switch Mode Controller DC Motor Drive | A3 | 2
Texas Instruments | LM2907 |  | Frequency to Voltage Converter | A3 | 1
 | PMI MUX28 |  | JFET Analog Multiplexers | A3 | 1
ON semiconductor | MC14528B |  | Dual Monostable Multivibrator | A3 | 1

Sheet: Composants A4
Composants traversants ou SMD à consommer. Obsolètes ou non renouvelés
Fabricant | Composant | Boîtier | Description | Emplacement | Stock | Distributeur 1 | Distrbuteur 1 ref | Distributeur 2 | Distrbuteur 2 ref | Remarque
Mouser | BTS117 | TO-220-3 | Smart Low Side Power Switch |  |  | Mouser
FAIRCHILD | CD4066BCN | DIP-14 | Quad Bilateral Switch
National Semiconductor | DAC0808LCN | DIP-16 | 8-bit D/A Converter |  |  | mouser
Ciliconix | DG243CJ | DIP-16 | General Purpose Analog Switch
Vishay Siliconix | DG271 | DIP-16 | Low-Voltage Analog Switch
Texas Instruments | LM348N | PDIP-14 | Operational Amplifier |  |  | Mouser
STMicroelectronics | LM7805C | To-220-3 | Positive fixed voltage regulator |  |  | Mouser
ON Semiconductor | MC14013BCP | DIP-16 | Dual Type D Flip-Flop
Motorola | MC14025B | DIP-14 | B-Suffix Series CMOS Gates
ON Semiconductor | MC14043BCP | DIP-16 | Quad R-S Latches
Motorola | MC14044B | DIp-16 | CMOS MSI |  |  | Farnell
ON Semiconductor | MC14049U | DIP-16 | HEx Buffers
ON Semiconductor | MC14051B | DIP-16 | Multiplexers/demultiplexers |  |  | Farnell
Motorola | MC14072B | DIP-14 | Semiconductor Technical DATA
Texas Instruments | MC1408P8 | DIP-18 | Digital Analogic converter |  |  | Mouser
ON Semiconductor | MC14099BCP | DIP-16 | Verrous 3-18V 8bit |  |  | Mouser
Motorola | MC14411 | DIP-24 | Bit Rate Generator
Motorola | MC14495P | DIP-16 | Hecadecimal-to-segment Latch |  |  | Farnell
ON Semiconductor | MC14528BCP | PDIP-16 | Multivibrateur monostable 3-18V |  |  | Mouser
Texas Instruments | RC4151NB | PDIP-8 | Converter [V]-[Hz] and [Hz]-[V] |  |  | Mouser
Siemens | SAB0529 | DIP-18 | Programmable Digital Timer
Texas Instruments | SN74HC160N | DIP-16 | Decade counter
Texas Instruments | SN74LS00N | DIP-14 | Positive-NAND Gate
Texas Instruments | SN74LS86AN | DIP-16 | Quadruple 2-Input XOR
Philips Semiconductors | TDA1524A | DIP-18 | Volume control circuit
Texas Instruments | ULN2003A | DIP-16 | Transistor Array
Panasonic | TQ2-L2-5V |  | Relais signal faible |  |  | mouser

Sheet: Stock Ics D3
Stock Ics - Obsolètes ou non renouvelés
Fabricant | Composant | Boîtier | Description | Emplacement | Stock | Distributeur 1 | Distrbuteur 1 ref | Distributeur 2 | Distrbuteur 2 ref | Remarque
 | 7440 |  | 4 Input NAND
 | 202ECPZ |  | RS-232 Transmitter/Reciever
 | 20AS25HBI |  | CAN
 | 296-11301-5 |  | IC REG CTRLR MULT TOPOLOGY 16DIP |  |  | Digi-Key | 296-11301-5-ND
 | 74LS604N |  | Latch de Multiplexage
 | 74LS645 |  | Bus bidirectionnel
 | AM1702ADC |  | EPROM
 | D8202A |  | MicroProcesseur
 | D8259AC-2 |  | Soft Core - Interrupt Controller
 | HIN202CPZ |  | Émetteur-récepteur 2/2 Complète RS232 16-PDIP |  |  | Digi-Key | HIN202CPZ-ND
 | HN58C65P-25 |  | 8192-Word X 8 bit EEPROM
 | LM331N |  | Convertisseur Volt to Fréquency
 | M54528p |  | 7- unit 150mA Darlington Trans. Array
 | MAX232 |  | Pilotes Rx/Tx RS-232
 | MC14506 |  | Dual 2-wide 2-input expandable
 | MC1458P |  | Usage général Amplificateurs 2 Circuits 8-PDIP |  |  | Digi-Key | 296-1403-5-ND
 | MC356P |  | Timer circuit
 | MC74F182N |  | Carry Generator
 | P8284A |  | Generateur de clock
 | PALCE22V10 |  | PAL Device
 | PIC16F84A-20/P |  | IC MCU 8BIT 1.75KB FLASH 18DIP |  |  | Digi-Key | PIC16F84A-20/P-ND
 | PIC16F88 |  | MicroContrôleur
 | PIC18F4520-I/P |  | MicroContrôleur
 | PIC18F452-I/L |  | PIC PIC® 18F Microcontrôleurs IC 8 bits 40MHz |  |  | Digi-Key | PIC18F452-I/L-ND
 | SN74LS373N |  | Verrou transparent de type D 1 canal 8:8 IC Trois états 20-PDIP |  |  | Digi-Key | 296-1660-5-ND
 | SN74LS377N |  | Bascules 1 Élément Type D 8 Bit Front positif |  |  | Digi-Key | 296-1663-5-ND
 | tl 7770-5 |  | Superviseur Complémentaire 2 canal 16-PDIP |  |  | Digi-Key | 296-3266-5-ND
 | TNY267N |  | Switching Regulator
 | UC3709N |  | Driver de Puissance
 | UC3841N |  | PWM/Switch Controller
 | UPD-41256C-15 |  | Dynamic RAM
 | Upd416c-2 |  | 416 RAM NEC PD416C-2 DRAM
 | UPD-70116C-8 |  | MicroProcesseur
 | UPD-8251AFC |  | Universal USART/UART
 | UPD-8255AC-2 |  | I/O Programmable to MicroProcesseur
 | V61C16S35L |  | Standard SRAM 2KX8
Raytheon | RC4152N | DIP8 | VOLTAGE-TO-FREQUENCY CONVERTER |  | 12
 | 7702 | SO8 | Voltage Supervisor |  | >20
 | LF347M | SOIC14 | JFET 4x OPAMP |  | >50
 | SN65HVD06 | SO8 | High Output RS 485 Transceiver |  | >30

Sheet: Kits PIC
Liste des kits, modules, dev boards MICROCHIP à disposition au bureau des enseignants
Nombre | P/N Microchip | Description | Features | MCU | Prix
1 | AC164127-3 | graphics pictail plus daughter card kit
1 | AC164136-2 | ZeroG Wifi PICTAIL/PICTAIL PLUS DAUGHTER BOARD |  |  |  | Obsolete
1 | AC320006 | PIC32MZ STARTER KIT ADAPTER BOARD | 168-pin to 132-pin connector |  | $78.00
1 | BM-64-EVB-C2 | BM64 BLUETOOTH AUDIO EVALUATION BOARD | BT 4.2 Audio, 3W Audio Amp, NFC, I/Os |  | $197.00
1 | DM320002 | STARTER KIT I/O EXPANSION BOARD | provides Starter Kit and Starter Board users with full access to MCU signals, additional debug headers, and connection of PICtail Plus daughter cards |  | $94.00
1 | DM320003-2 | PIC32 USB STARTER KIT II | provides the easiest and lowest cost method to experience the USB and CAN functionality of the PIC32 microcontrollers |  |  | Obsolete
2 | DM320004 | PIC32 ETHERNET STARTER KIT | method to experience 10/100 Ethernet development with PIC32. Available CAN 2.0b peripheral and USB host/device/OTG |  | $120.00
2 | DM320005 | MULTIMEDIA EXPANSION BOARD | 3.2 inch (8.1 cm) QVGA touch screen display with backlight, Four-way joystick, headphone/line jacks PicTail compatible |  |  | Replaced by DMA320005-5
1 | DM320107 | PIC32MM USB CURIOSITY DEVELOPMENT BOARD | 2 X mikroBUS™ interfaces for click boards™ | PIC32MM0256GPM064 | $38.00
1 | EV31E34A | PIC32MK MCM CURIOSITY PRO DEVELOPMENT BOARD | 2 X mikroBUS™ interfaces for click boards™, 2x DB9 CAN-FD, I/Os, USB Host and USB Device | PIC32MK MCM | $115.00
1 | MA240015 | PIC24FJ256GA110 PLUG-IN-MODULE | PIM plugs into the Explorer 16 Development Board (DM240001) | PIC24FJ256GA110 | $34.00
1 | MA320001 | PIC32MX360F512L PLUG IN MODULE | PIM plugs into the Explorer 16 Development Board (DM24000x) | PIC32MX360F512L | $34.00
2 | TCHIP011 | CHIPKIT™ FUBARINO MINI DEVELOPMENT BOARD |  | PIC32MX250F128D | $22.00
? | DM240001 | EXPLORER 16 DEVELOPMENT BOARD WITH 100-PIN PIM | 16 x 2 LCD display, TC1047A temp sensor, PICTailTM Plus connector expansion
 | MA320024 | PIC32MK1024 Motor Control PIM
 | MA320211 | PIC32MK MCM Motor Control PIM
 |  | 1
