SwissMaverick/PROJ-2008_SablierElectronique/2008_SablierElectronique/hard/2008_SablierElectronique.xls

Designator | Comment | Description | Footprint | Quantity | Supplier 1 | Supplier Part Number 1 | Price
U3 | IAM-20680 |  | STM-LGA-16 | 1 | Mouser | 410-IAM-20680 | 13.89
U4 | TLV62585PDRLR | 2.5V-5.5V input, 3-A high efficiency step-down converter in 2x2 QFN or SOT563 package 6-SOT-5X3 -40 to 125 | SOT563 | 1 | Mouser | 595-TLV62585PDRLR | 0.55
U5, U6 | CD74HCT4067 |  | SOIC24 | 2 | Mouser | 595-CD74HC4067M | 0.851
D4 | SD0805S040S0R1 | Diode Schottky 40V 100mA (DC) Surface Mount 0805 (2012 Metric) | DIOSC130X200X100-2N | 1 | Mouser | 581-SD0805S040S0R5 | 0.4
U1 | MCHP-RN4020-MODULE-24 |  | MCHP-MODULE-24_V | 1 | Mouser | 579-RN4020-V/RM120 | 8.08
U2 | MC-32B-MX795-SQ100 |  | TQFP-PT100_N | 1 | Mouser | 579-PIC32MX795F512 | 8.61
TP1, TP2, TP3, TP4, TP5, TP6, TP7, TP8, TP9, TP18, TP19, TP20, TP21, TP22, TP23, TP24, TP25, TP26, TP27, TP28, TP29, TP30, TP31 | 5019 | Test point smd | TESTPOINT_SMD | 23 | Mouser | 534-5019 | 0.36
D5 | USBLC6-2P6 |  | FP-SOT-666-MFG | 1 | Mouser | 511-USBLC6-2P6 | 0.494
S4 | FSM4JH | Switch Push Button OFF _ON_ SPST Round Button 0.05A 24VDC Momentary Contact PC Pins Thru-Hole | SW_FSM4JH | 1 | Mouser | 506-FSM4JH | 0.092
 | CMI-1295IC-0385T | 12 mm, 3 Vdc, 85 dB, Through Hole, Driving Circuit, Magnetic Audio Indicator Buzzer | CUI_CMI-1295IC-0385T | 1 | Mouser | 490-CMI-1295IC-0385T | 1.16
L1 | LQM21PN1R0MCHD0 | LQM21PN1R0MCHD | RESC0805(2012)_L | 1 | Mouser | 81-LQM21PN1R0MCHD | 0.29
R10 | 1k |  | RESC0805(2012)_L | 1
R11 | 1M |  | RESC0805(2012)_L | 1
C2 | 4.7uF |  | RESC0805(2012)_L | 1
R6, R7, R8, R9 | 10k |  | RESC0805(2012)_L | 4
C3 | 10nF |  | RESC0805(2012)_L | 1
C1, C12, C15 | 10uF |  | RESC0805(2012)_L | 3
C16 | 22uF |  | RESC0805(2012)_L | 1
R4 | 51k |  | RESC0805(2012)_L | 1
R5, R13 | 100k |  | RESC0805(2012)_L | 2
C4, C5, C6, C7, C8, C9, C10, C11, C13, C14, C17, C18 | 100nF |  | RESC0805(2012)_L | 12
R12 | 430k |  | RESC0805(2012)_L | 1
R1, R2, R3, R14, R15, R16, R17, R18, R19, R20, R21, R22, R23, R24, R25, R26, R27, R28, R29, R30, R31, R32, R33, R34, R35, R36, R37, R38, R39, R40, R41, R42, R43, R44, R45 | 680 |  | RESC0805(2012)_L | 35
TP10, TP11, TP12, TP13, TP14, TP15, TP16, TP17 | 5019 | Test point smd | TESTPOINT_SMD_Via | 8
X3 | Alimentation | Connector Header Through Hole 2 position | Header 2 pin | 1
S2 | Bouton BAS | Switch Surface Mount | Header 2 pin | 1
S3 | Bouton H/M/S | Switch Surface Mount | Header 2 pin | 1
S1 | Bouton HAUT | Switch Surface Mount | Header 2 pin | 1
X7 | Colonnes bas |  | CON8x8(edited) | 1
X6 | Colonnes haut |  | CON8x8(edited) | 1
X1 | ICD |  | CON6 | 1
D1, D2, D3 | APTD2012LSURCK |  | 0805_LED | 515 | Mouser | 604-APTD2012LSURCK | 0.11
X5 | Lignes bas |  | CON8x8(edited) | 1
X4 | Lignes haut |  | CON8x8(edited) | 1
Q34, Q35, Q36, Q37, Q38, Q39, Q40, Q41, Q42, Q43, Q44, Q45, Q46, Q47, Q48, Q49, Q50, Q51, Q52, Q53, Q54, Q55, Q56, Q57, Q58, Q59, Q60, Q61, Q62, Q63, Q64, Q65 | Mosfet P |  | FAIR-SOT23-3_V | 32 | Mouser | 865-XP231P0201TR-G | 0.097
Q1, Q2, Q3, Q4, Q5, Q6, Q7, Q8, Q9, Q10, Q11, Q12, Q13, Q14, Q15, Q16, Q17, Q18, Q19, Q20, Q21, Q22, Q23, Q24, Q25, Q26, Q27, Q28, Q29, Q30, Q31, Q32, Q33 | Mosfet-N |  | FAIR-SOT23-3_V | 33 | Mouser | 512-FDV301N | 0.145
X2 | USB |  | CON4 | 1
 |  |  |  |  |  | Total : | 108CHF
