SwissMaverick/PROJ-2008_SablierElectronique/2008_SablierElectronique/hard/2008_SablierElectronique_PCB/Project Outputs for 2008_SablierElectronique/2008_SablierElectronique.xls

Comment | Description | Designator | Footprint | Quantity | Supplier 1 | Supplier Part Number 1 | Price
STM-L3GD20H-LGA-16_A |  | U3 | STM-LGA-16 | 1 | Farnell | 2762758
TLV62585PDRLR | 2.5V-5.5V input, 3-A high efficiency step-down converter in 2x2 QFN or SOT563 package 6-SOT-5X3 -40 to 125 | U4 | SOT563 | 1 | Mouser | 595-TLV62585PDRLR | 0.55
CD74HCT4067 |  | U5, U6 | SOIC24 | 2 | Mouser | 595-CD74HC4067M
SD0805S040S0R1 | Diode Schottky 40V 100mA (DC) Surface Mount 0805 (2012 Metric) | D4 | DIOSC130X200X100-2N | 1 | Mouser | 581-SD0805S040S0R5
MCHP-RN4020-MODULE-24 |  | U1 | MCHP-MODULE-24_V | 1 | Mouser | 579-RN4020-V/RM120
MC-32B-MX795-SQ100 |  | U2 | TQFP-PT100_N | 1 | Mouser | 579-PIC32MX795F512
5019 | Test point smd | TP1, TP2, TP3, TP4, TP5, TP6, TP7, TP8, TP9, TP18, TP19, TP20, TP21, TP22, TP23, TP24, TP25, TP26, TP27, TP28, TP29, TP30, TP31 | TESTPOINT_SMD | 23 | Mouser | 534-5019
USBLC6-2P6 |  | D5 | FP-SOT-666-MFG | 1 | Mouser | 511-USBLC6-2P6
FSM4JH | Switch Push Button OFF _ON_ SPST Round Button 0.05A 24VDC Momentary Contact PC Pins Thru-Hole | S4 | SW_FSM4JH | 1 | Mouser | 506-FSM4JH
CMI-1295IC-0385T | 12 mm, 3 Vdc, 85 dB, Through Hole, Driving Circuit, Magnetic Audio Indicator Buzzer |  | CUI_CMI-1295IC-0385T | 1 | Mouser | 490-CMI-1295IC-0385T
LQM21PN1R0MCHD0 | LQM21PN1R0MCHD | L1 | RESC0805(2012)_L | 1 | Mouser | 81-LQM21PN1R0MCHD
1k |  | R10 | RESC0805(2012)_L | 1
1M |  | R11 | RESC0805(2012)_L | 1
4.7uF |  | C2 | RESC0805(2012)_L | 1
10k |  | R6, R7, R8, R9 | RESC0805(2012)_L | 4
10nF |  | C3 | RESC0805(2012)_L | 1
10uF |  | C1, C12, C15 | RESC0805(2012)_L | 3
22uF |  | C16 | RESC0805(2012)_L | 1
51k |  | R4 | RESC0805(2012)_L | 1
100k |  | R5, R13 | RESC0805(2012)_L | 2
100nF |  | C4, C5, C6, C7, C8, C9, C10, C11, C13, C14, C17, C18 | RESC0805(2012)_L | 12
453k |  | R12 | RESC0805(2012)_L | 1
680 |  | R1, R2, R3, R14, R15, R16, R17, R18, R19, R20, R21, R22, R23, R24, R25, R26, R27, R28, R29, R30, R31, R32, R33, R34, R35, R36, R37, R38, R39, R40, R41, R42, R43, R44, R45 | RESC0805(2012)_L | 35
5019 | Test point smd | TP10, TP11, TP12, TP13, TP14, TP15, TP16, TP17 | TESTPOINT_SMD_Via | 8
Alimentation | Connector Header Through Hole 2 position | X3 | Header 2 pin | 1
Bouton BAS | Switch Surface Mount | S2 | Header 2 pin | 1
Bouton H/M/S | Switch Surface Mount | S3 | Header 2 pin | 1
Bouton HAUT | Switch Surface Mount | S1 | Header 2 pin | 1
Colonnes bas |  | X7 | CON8x8(edited) | 1
Colonnes haut |  | X6 | CON8x8(edited) | 1
ICD |  | X1 | CON6 | 1
APTD2012LSURCK |  | D1, D2, D3 | 0805_LED | 3 | Mouser | 604-APTD2012LSURCK
Lignes bas |  | X5 | CON8x8(edited) | 1
Lignes haut |  | X4 | CON8x8(edited) | 1
Mosfet P |  | Q34, Q35, Q36, Q37, Q38, Q39, Q40, Q41, Q42, Q43, Q44, Q45, Q46, Q47, Q48, Q49, Q50, Q51, Q52, Q53, Q54, Q55, Q56, Q57, Q58, Q59, Q60, Q61, Q62, Q63, Q64, Q65 | FAIR-SOT23-3_V | 32 | Mouser | 865-XP231P0201TR-G
Mosfet-N |  | Q1, Q2, Q3, Q4, Q5, Q6, Q7, Q8, Q9, Q10, Q11, Q12, Q13, Q14, Q15, Q16, Q17, Q18, Q19, Q20, Q21, Q22, Q23, Q24, Q25, Q26, Q27, Q28, Q29, Q30, Q31, Q32, Q33 | FAIR-SOT23-3_V | 33 | Mouser | 512-FDV301N
USB |  | X2 | CON4 | 1
