SwissMaverick/PROJ-2008_SablierElectronique/2008_SablierElectronique/mec/A/SablierElectronique-nosupport.SLDASM

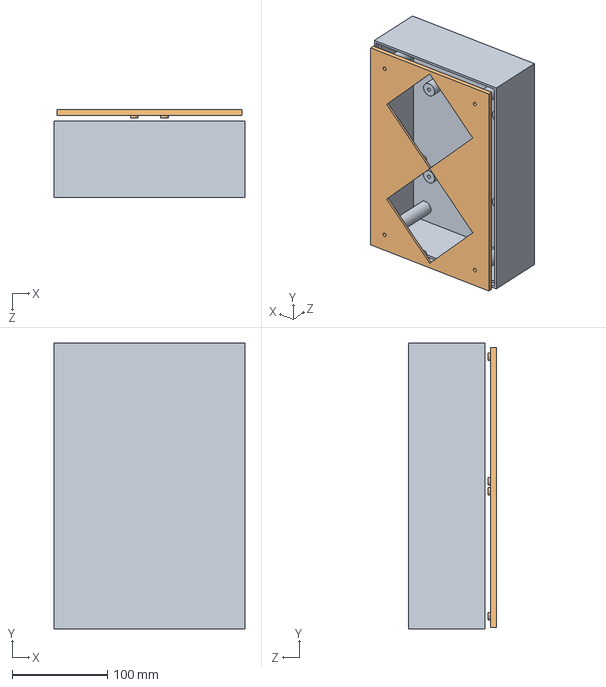
[picture p72: CAD file, 2026-06-12]
2008_SablierElectronique/mec/A/SablierElectronique-nosupport.SLDASM
200.0 x 300.0 x 92.0 mm
PièceSablier2008-Box-nosupport
PièceSablier2008-Top
