SwissMaverick/PROJ-2008_SablierElectronique/2008_SablierElectronique/hard/2008_SablierElectronique_E/Composants Perso/Altium/LIS3DH/LGA-16_3x3x1mm_STM.step

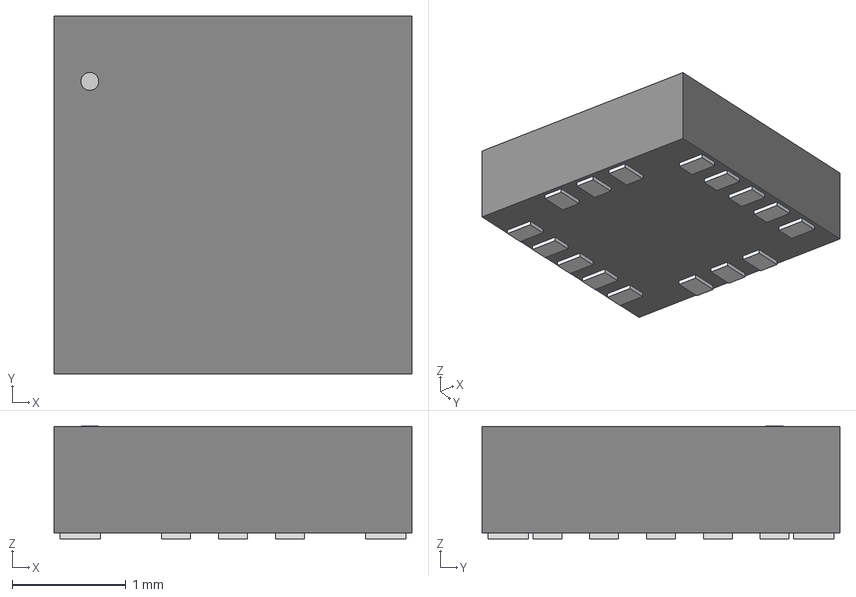
[picture p73: CAD file, 2026-06-12]
2008_SablierElectronique/hard/2008_SablierElectronique_E/Composants Perso/Altium/LIS3DH/LGA-16_3x3x1mm_STM.step
3.15 x 3.15 x 0.993 mm
