SwissMaverick/PROJ-2008_SablierElectronique/2008_SablierElectronique/hard/2008_SablierElectronique_E/Composants Perso/Altium/QFN64_9x9MC_MCH.step

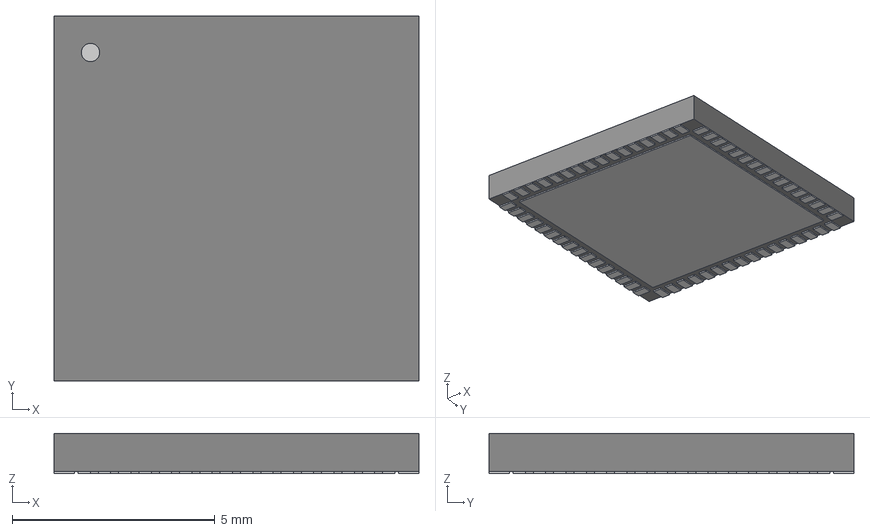
[picture p74: CAD file, 2026-06-12]
2008_SablierElectronique/hard/2008_SablierElectronique_E/Composants Perso/Altium/QFN64_9x9MC_MCH.step
8.99 x 8.99 x 0.993 mm
