SwissMaverick/PROJ-2008_SablierElectronique/2008_SablierElectronique/hard/2008_SablierElectronique_E/Composants Perso/Altium/TPS63001DRCR/DRC0010J.stp

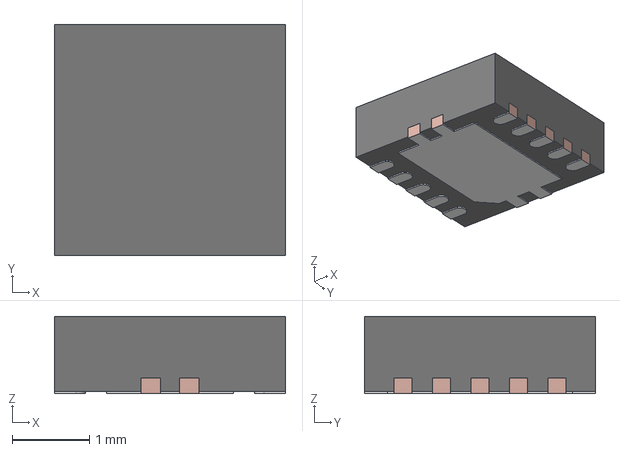
[picture p75: CAD file, 2026-06-12]
2008_SablierElectronique/hard/2008_SablierElectronique_E/Composants Perso/Altium/TPS63001DRCR/DRC0010J.stp
3.00 x 3.00 x 1.00 mm
BODY-SON
FRAME-DRC0010J
