SwissMaverick/PROJ-2008_SablierElectronique/2008_SablierElectronique/hard/2008_SablierElectronique_E/Composants Perso/ESP32-C3-WROOM-02-N4/3D/ESP32-C3-WROOM-02-N4.stp

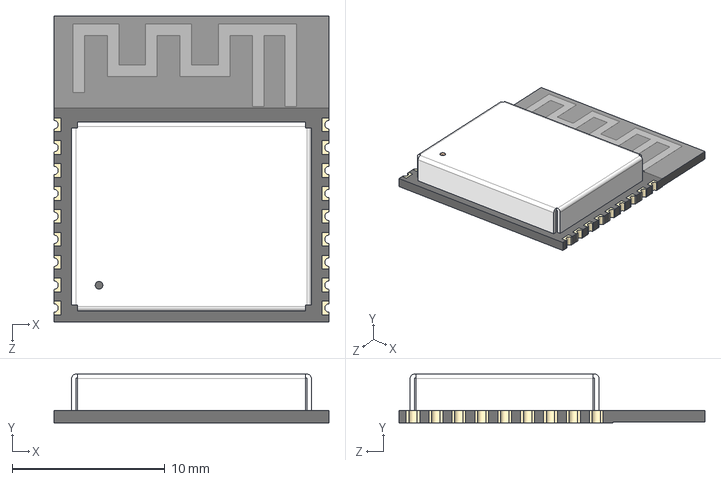
[picture p76: CAD file, 2026-06-12]
2008_SablierElectronique/hard/2008_SablierElectronique_E/Composants Perso/ESP32-C3-WROOM-02-N4/3D/ESP32-C3-WROOM-02-N4.stp
18.0 x 3.20 x 20.0 mm
