SwissMaverick/PROJ-2008_SablierElectronique/2008_SablierElectronique/hard/2008_SablierElectronique_E/Composants Perso/TQFP64_10x10MC_MCH.step

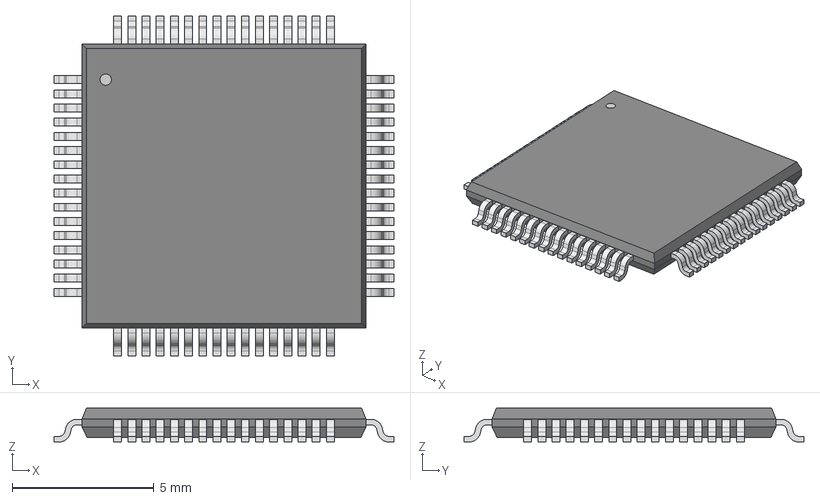
[picture p77: CAD file, 2026-06-12]
2008_SablierElectronique/hard/2008_SablierElectronique_E/Composants Perso/TQFP64_10x10MC_MCH.step
12.0 x 12.0 x 1.20 mm
