SwissMaverick/PROJ-2008_SablierElectronique/2008_SablierElectronique/mec/A/LED_Matrix16x16.step

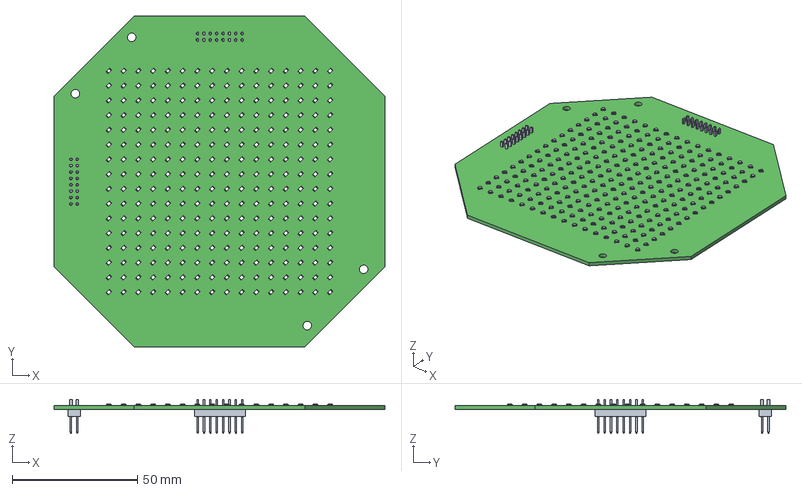
[picture p78: CAD file, 2026-06-12]
2008_SablierElectronique/mec/A/LED_Matrix16x16.step
132.0 x 132.0 x 13.6 mm
base x 256
cover x 256
housing x 256
marking x 512
base_2 x 256
215447-8--3DModel-STEP-1 x 2
