SwissMaverick/PROJ-2008_SablierElectronique/2008_SablierElectronique/mec/E/PièceSablier2008-Top.SLDPRT

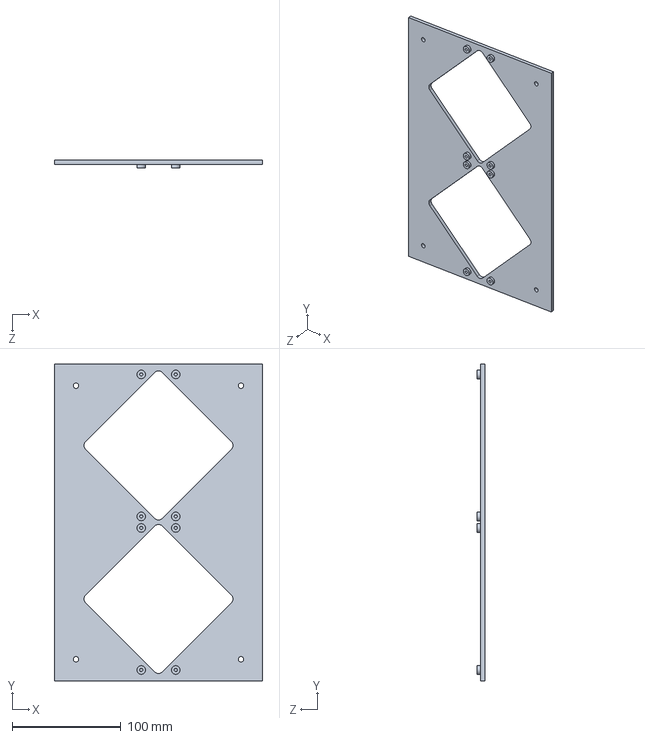
[picture p79: CAD file, 2026-06-12]
2008_SablierElectronique/mec/E/PièceSablier2008-Top.SLDPRT
192.0 x 292.0 x 7.00 mm
