SwissMaverick/PROJ-2008_SablierElectronique/2008_SablierElectronique/mec/A/SablierElectronique.STEP

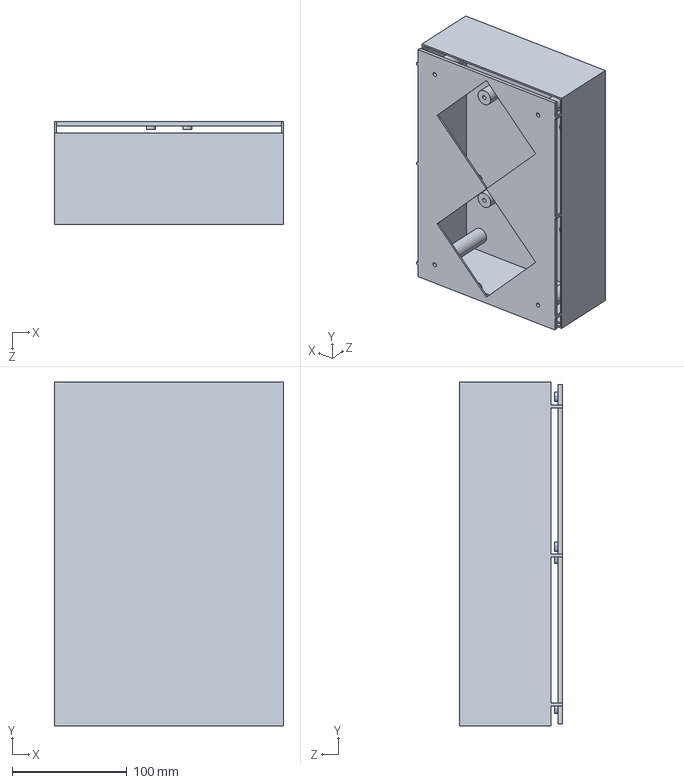
[picture p80: CAD file, 2026-06-12]
2008_SablierElectronique/mec/A/SablierElectronique.STEP
200.0 x 300.0 x 90.0 mm
