SwissMaverick/PROJ-2008_SablierElectronique/2008_SablierElectronique/mec/E/PièceSablier2008-Box.SLDPRT

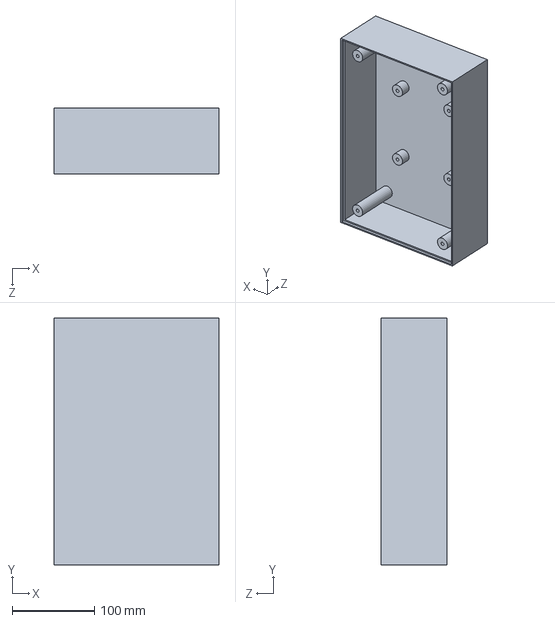
[picture p81: CAD file, 2026-06-12]
2008_SablierElectronique/mec/E/PièceSablier2008-Box.SLDPRT
200.0 x 300.0 x 80.0 mm
