SwissMaverick/PROJ-2008_SablierElectronique/2008_SablierElectronique/mec/A/PièceSablier2008-Top.STEP

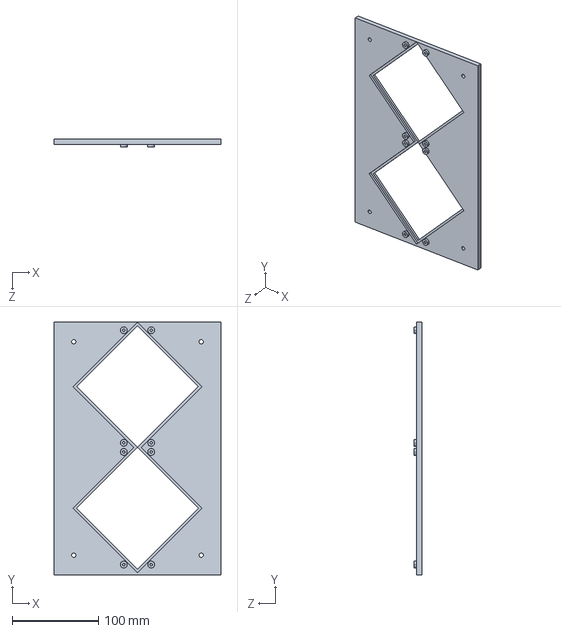
[picture p82: CAD file, 2026-06-12]
2008_SablierElectronique/mec/A/PièceSablier2008-Top.STEP
194.0 x 294.0 x 9.00 mm
