SwissMaverick/PROJ-2008_SablierElectronique/2008_SablierElectronique/hard/2008_SablierElectronique_PCB/215447-8--3DModel-STEP-1.STEP

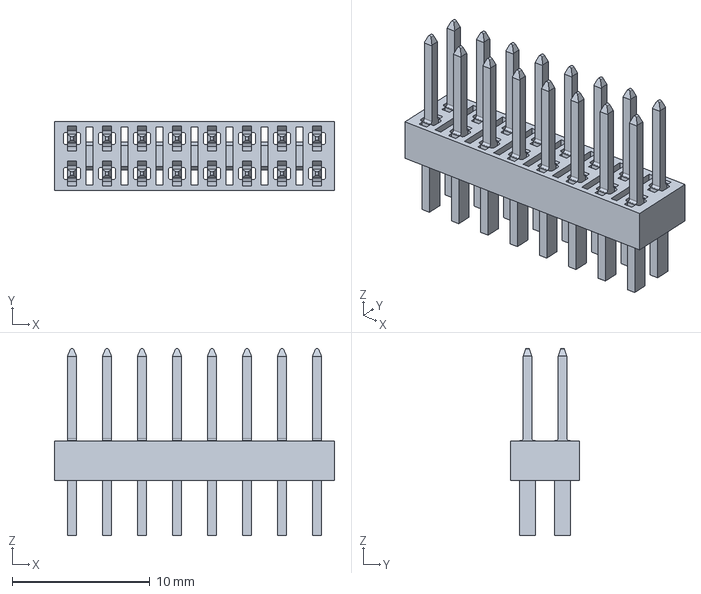
[picture p83: CAD file, 2026-06-12]
2008_SablierElectronique/hard/2008_SablierElectronique_PCB/215447-8--3DModel-STEP-1.STEP
20.3 x 5.03 x 13.6 mm
