SwissMaverick/PROJ-2008_SablierElectronique/(list of files, cad)

Other CAD files:
2008_SablierElectronique/hard/2008_SablierElectronique_E/Composants Perso/Altium/TQFP64_10x10MC_MCH.step
2008_SablierElectronique/mec/A/PièceSablier2008-Box.STEP
2008_SablierElectronique/mec/A/SablierElectronique-nosupport1.SLDPRT
2008_SablierElectronique/mec/A/PièceSablier2008-Box-nosupport.SLDPRT
2008_SablierElectronique/archive/mec/PièceSablier2008-Box-nosupport.SLDPRT
2008_SablierElectronique/archive/mec/PièceSablier2008-Box.SLDPRT
2008_SablierElectronique/archive/mec/PièceSablier2008-Box.STEP
2008_SablierElectronique/archive/mec/PièceSablier2008-Top.SLDPRT
2008_SablierElectronique/archive/mec/SablierElectronique-nosupport.SLDPRT
2008_SablierElectronique/archive/mec/SablierElectronique-nosupport1.SLDPRT
2008_SablierElectronique/archive/mec/SablierElectronique.SLDASM
2008_SablierElectronique/archive/mec/SablierElectronique.SLDPRT
2008_SablierElectronique/hard/2008_SablierElectronique_E/Composants Perso/ESP32-C3-WROOM-02-N4/Allegro/esp32c3wroom02n4.psm
2008_SablierElectronique/hard/2008_SablierElectronique_E/Composants Perso/ESP32-C3-WROOM-02-N4/DEHDL/esp32_c3_wroom_02_n4/chips/chips.prt
2008_SablierElectronique/mec/A/PièceSablier2008-Box.SLDPRT
2008_SablierElectronique/mec/A/PièceSablier2008-Top.SLDPRT
2008_SablierElectronique/mec/A/SablierElectronique-nosupport.SLDPRT
2008_SablierElectronique/mec/A/SablierElectronique.SLDASM
2008_SablierElectronique/mec/A/SablierElectronique.SLDPRT
