SwissMaverick/PROJ-2008_SablierElectronique/2008_SablierElectronique/archive/doc/Version_A/Journal de travail - Diplôme.ods

Sheet: Semaine 1
Journal semaine N.33 |  | 10.08.20 |  | 14.08.20 | FAQ / Solution | Semaine tot
Projets | Tâches | Début | Fin | Tot. Heures |  | 40:19
Lundi 10 |  |  | Total : | 05:37
Pré-étude |  | 10:00 | 12:00 | 02:00 |  |  | Date et semaine du départ du module
Pré-étude | Schéma bloc + composant | 13:10 | 16:47 | 03:37 |  |  | Année : | 2020
 |  |  |  | 00:00 |  |  | Mois : | 8
 |  |  |  | 00:00 |  |  | Jour : | 10
 |  |  |  | 00:00
 |  |  |  | 00:00 |  |  | N.Semaine : | 33
 |  |  |  | 00:00
Mardis 11 |  |  | Total : | 08:08 |  |  | Après la semaine 2 : |  | Semaines
Pré-étude | Recherche de composant | 08:30 | 16:38 | 08:08 |  |  | Après la semaine 3 : |  | Semaines
 |  |  |  | 00:00 |  |  | Après la semaine 4 : |  | Semaines
 |  |  |  | 00:00 |  |  | Après la semaine 5 : |  | Semaines
 |  |  |  | 00:00
 |  |  |  | 00:00
 |  |  |  | 00:00
 |  |  |  | 00:00
Mercredi 12 |  |  | Total : | 10:29
Schéma |  | 08:30 | 10:00 | 01:30
Création journal |  | 10:00 | 11:00 | 01:00
PCB | Matrice à leds | 11:00 | 12:30 | 01:30
PCB | Matrice à leds | 13:10 | 19:39 | 06:29
 |  |  |  | 00:00
 |  |  |  | 00:00
 |  |  |  | 00:00
Jeudi 13 |  |  | Total : | 08:00
PCB | Matrice à leds | 08:30 | 14:30 | 06:00
Schéma | Commande matrice | 14:30 | 16:30 | 02:00
 |  |  |  | 00:00
 |  |  |  | 00:00
 |  |  |  | 00:00
 |  |  |  | 00:00
 |  |  |  | 00:00
Vendredi 14 |  |  | Total : | 08:05
Schéma | Commande matrice | 08:30 | 09:00 | 00:30 | Probléme PC
Problème PC |  | 09:00 | 10:00 | 01:00
Schéma |  | 10:00 | 12:00 | 02:00
Schéma |  | 12:00 | 16:35 | 04:35
 |  |  |  | 00:00
 |  |  |  | 00:00
 |  |  |  | 00:00

Sheet: Semaine 2
Journal semaine N.34 |  | 17.08.20 |  | 21.08.20 | FAQ / Solution | Semaine tot
Projets | Tâches | Début | Fin | Tot. Heures |  | 46:35
Lundi 17 |  |  | Total : | 12:40
Schéma |  | 08:00 | 20:40 | 12:40
 |  |  |  | 00:00
 |  |  |  | 00:00
 |  |  |  | 00:00
 |  |  |  | 00:00
 |  |  |  | 00:00
 |  |  |  | 00:00
Mardis 18 |  |  | Total : | 09:00
PCB |  | 08:30 | 17:30 | 09:00
 |  |  |  | 00:00
 |  |  |  | 00:00
 |  |  |  | 00:00
 |  |  |  | 00:00
 |  |  |  | 00:00
 |  |  |  | 00:00
Mercredi 19 |  |  | Total : | 08:30
PCB | Routage carte principale | 08:30 | 17:00 | 08:30
 |  |  |  | 00:00
 |  |  |  | 00:00
 |  |  |  | 00:00
 |  |  |  | 00:00
 |  |  |  | 00:00
 |  |  |  | 00:00
Jeudi 20 |  |  | Total : | 09:00
PCB | Documentation + validation | 08:30 | 17:30 | 09:00
 |  |  |  | 00:00
 |  |  |  | 00:00
 |  |  |  | 00:00
 |  |  |  | 00:00
 |  |  |  | 00:00
 |  |  |  | 00:00
Vendredi 21 |  |  | Total : | 07:25
PCB | Correction de la carte | 08:30 | 12:30 | 04:00
Boîtier3D | SolidWorks | 13:10 | 16:35 | 03:25
 |  |  |  | 00:00
 |  |  |  | 00:00
 |  |  |  | 00:00
 |  |  |  | 00:00
 |  |  |  | 00:00

Sheet: Semaine 3
Journal semaine N.35 |  | 24.08.20 |  | 28.08.20 | FAQ / Solution | Semaine tot
Projets | Tâches | Début | Fin | Tot. Heures |  | 41:15
Lundi 24 |  |  | Total : | 08:00
Boîtier3D |  | 08:30 | 16:30 | 08:00
 |  |  |  | 00:00
 |  |  |  | 00:00
 |  |  |  | 00:00
 |  |  |  | 00:00
 |  |  |  | 00:00
 |  |  |  | 00:00
Mardis 25 |  |  | Total : | 08:30 | Choix d’un gyroscope erroné. J’ai inversé le fonctionnement d’un gyroscope et d’un accélerometre.
Boîtier3D |  | 08:30 | 10:00 | 01:30
Expert |  | 10:00 | 10:35 | 00:35
Boîtier3D |  | 10:35 | 17:00 | 06:25
 |  |  |  | 00:00
 |  |  |  | 00:00
 |  |  |  | 00:00
 |  |  |  | 00:00
Mercredi 26 |  |  | Total : | 08:05
Documentation |  | 08:30 | 09:30 | 01:00
Boîtier3D | Correction pour impression | 09:30 | 14:30 | 05:00
Documentation | Fichiers placeuse + doc | 14:30 | 16:35 | 02:05
 |  |  |  | 00:00
 |  |  |  | 00:00
 |  |  |  | 00:00
 |  |  |  | 00:00
Jeudi 27 |  |  | Total : | 08:00
Montage PCB |  | 08:30 | 16:30 | 08:00
 |  |  |  | 00:00
 |  |  |  | 00:00
 |  |  |  | 00:00
 |  |  |  | 00:00
 |  |  |  | 00:00
 |  |  |  | 00:00
Vendredi 28 |  |  | Total : | 08:40
Montage PCB | Montage, correction + test | 08:30 | 17:10 | 08:40
 |  |  |  | 00:00
 |  |  |  | 00:00
 |  |  |  | 00:00
 |  |  |  | 00:00
 |  |  |  | 00:00
 |  |  |  | 00:00

Sheet: Semaine 4
Journal semaine N.36 |  | 31.08.20 |  | 04.09.20 | FAQ / Solution | Semaine tot
Projets | Tâches | Début | Fin | Tot. Heures |  | #RÉF !
Lundi 31 |  |  | Total : | 10:45 | Le microcontroleur ne pouvait pas être programmé
Montage PCB | Dépannage + test | 08:25 | 19:10 | 10:45
 |  |  |  | 00:00
 |  |  |  | 00:00
 |  |  |  | 00:00
 |  |  |  | 00:00
 |  |  |  | 00:00
 |  |  |  | 00:00
Mardis 1 |  |  | Total : | 10:52
Programmation | Affichage matrice | 08:30 | 11:00 | 02:30
Modification | Pont entre L1-L4 et LB1… | 11:00 | 12:00 | 01:00
Programmation | Affichage matrice | 12:00 | 19:22 | 07:22
 |  |  |  | 00:00
 |  |  |  | 00:00
 |  |  |  | 00:00
 |  |  |  | 00:00
Mercredi 2 |  |  | Total : | 08:30
Arrêt maladie |  |  |  | 03:30
 |  |  |  | 01:45
 |  |  |  | 03:15
 |  |  |  | 00:00
 |  |  |  | 00:00
 |  |  |  | 00:00
 |  |  |  | 00:00
Jeudi 3 |  |  | Total : | 08:50
Arrêt maladie |  |  |  | 03:00
 |  |  |  | 05:50
 |  |  |  | 00:00
 |  |  |  | 00:00
 |  |  |  | 00:00
 |  |  |  | 00:00
 |  |  |  | 00:00
Vendredi 4 |  |  | Total : | #RÉF !
Programmation | Affichage matrice | 08:30 | 12:00 | #RÉF !
Modification | Résistances mosfet GND | 13:00 | 14:45 | 01:45
Programmation | Affichage matrice | 14:45 | 18:00 | 03:15
 |  |  |  | 00:00
 |  |  |  | 00:00
 |  |  |  | 00:00
 |  |  |  | 00:00

Sheet: Semaine 5
Journal semaine N.37 |  | 07.09.20 |  | 11.09.20 | FAQ / Solution | Semaine tot
Projets | Tâches | Début | Fin | Tot. Heures |  | 45:50
Lundi 7 |  |  | Total : | 08:50 | Impossible à interpreter les données
Montage IAM |  | 08:30 | 11:30 | 03:00
Programmation | Centrale inertielle | 13:10 | 19:00 | 05:50
 |  |  |  | 00:00
 |  |  |  | 00:00
 |  |  |  | 00:00
 |  |  |  | 00:00
 |  |  |  | 00:00
Mardis 8 |  |  | Total : | 10:30
Programmation | Centrale inertielle | 08:30 | 10:00 | 01:30
Programmation | Particules | 10:00 | 19:00 | 09:00
 |  |  |  | 00:00
 |  |  |  | 00:00
 |  |  |  | 00:00
 |  |  |  | 00:00
 |  |  |  | 00:00
Mercredi 9 |  |  | Total : | 10:30
Programmation | Particules | 08:30 | 19:00 | 10:30
 |  |  |  | 00:00
 |  |  |  | 00:00
 |  |  |  | 00:00
 |  |  |  | 00:00
 |  |  |  | 00:00
 |  |  |  | 00:00
Jeudi 10 |  |  | Total : | 08:00 | Programme des particules fonctionnel
Programmation | Particules | 08:30 | 14:00 | 05:30
Documentation |  | 14:00 | 16:30 | 02:30
 |  |  |  | 00:00
 |  |  |  | 00:00
 |  |  |  | 00:00
 |  |  |  | 00:00
 |  |  |  | 00:00
Vendredi 11 |  |  | Total : | 08:00
Documentation |  | 08:30 | 16:30 | 08:00
 |  |  |  | 00:00
 |  |  |  | 00:00
 |  |  |  | 00:00
 |  |  |  | 00:00
 |  |  |  | 00:00
 |  |  |  | 00:00
