SwissMaverick/PROJ-2008_SablierElectronique/2008_SablierElectronique/archive/soft/Version_B/2008_SablierElectronique-JournalDeTravail-v2.xlsm

Sheet: Home
Prénom | Mario
Nom | Dos Santos
Classe | Slo2
Semaine | Du | Au | Détail [h] | Total [h]
24 | 2021-06-07 | 2021-06-13 |  | #NAME?
Total |  |  |  | #NAME?
Numéro | Nom du Projet | Type / Activité | Détail [h] | Total [h]
2008 | SablierElectronique |  |  | 20:30:00
2008 | SablierElectronique | Cahier des charges | 7:50:00
2008 | SablierElectronique | Communication USB | 5:50:00
2008 | SablierElectronique | Application C# | 3:25:00
2008 | SablierElectronique | Documentations | 3:25:00
Total |  |  | 20:30:00 | 20:30:00

Sheet: 24
 | Sem. |  |  | Jour | Total [h]
 | Du |  |  | Lundi | 0:00:00
 | Au |  |  | Mardi | 0:00:00
 |  |  |  | Mercredi | 0:00:00
 |  |  |  | Jeudi | 0:00:00
 |  |  |  | Vendredi | 20:30:00
 |  |  |  | Samedi | 0:00:00
 |  |  |  | Dimanche | 0:00:00
 |  |  |  | Total | 20:30:00
Date | De | À | [h] | Projets | Tâches | Remarques
2021-04-30 | 8:00:00 | 11:25:00 | 3:25:00 | SablierElectronique | Cahier des charges | début du projet/ s'informer sur le projet
2021-05-07 | 8:00:00 | 11:25:00 | 3:25:00 | SablierElectronique | Cahier des charges | s'informer du travail restant/ commencer le cahier des charges
2021-05-21 | 8:00:00 | 9:00:00 | 1:00:00 | SablierElectronique | Cahier des charges | Finaliser le cahier des charges
2021-05-21 | 9:00:00 | 11:25:00 | 2:25:00 | SablierElectronique | Communication USB | Faire un nouveau projet car arborescences introuvable - s'informer de la partie hardware du projet/ et software(partie software introuvable)
2021-05-28 | 8:00:00 | 11:25:00 | 3:25:00 | SablierElectronique | Application C# | Commencer l'application C# car M.bovey occuper et ne peut pas venir m'aider
2021-06-04 | 8:00:00 | 11:25:00 | 3:25:00 | SablierElectronique | Communication USB | aide de M.bovey et decouverte du probleme de la communication USB - refaire un projet pour implémenter l'USB
2021-06-11 | 8:00:00 | 11:25:00 | 3:25:00 | SablierElectronique | Documentations | Commencer et finaliser le rapport du projet version B

Sheet: FAQ
Projet | Question | Réponse
Exemple | Énoncé succinct de la question. | Réponse apportée, éventuellement Sur plusieurs lignes.

Sheet: Projets
Il doit toujours y avoir au moins un projet et une activité.
Nom du projet | Numéro | Description
Non productif | 0 | Séance de classe
SablierElectronique | 2008 | Théorie
 |  | Cahier des charges
 |  | Communication USB
 |  | Application C#
 |  | Communication Bluetooth
 |  | Présentation
 |  | Documentations

Sheet: W
 | Sem. |  |  | Jour | Total [h]
 | Du |  |  | Lundi | 0:00:00
 | Au |  |  | Mardi | 0:00:00
 |  |  |  | Mercredi | 0:00:00
 |  |  |  | Jeudi | 0:00:00
 |  |  |  | Vendredi | 0:00:00
 |  |  |  | Samedi | 0:00:00
 |  |  |  | Dimanche | 0:00:00
 |  |  |  | Total | 0:00:00
Date | De | À | [h] | Projets | Tâches | Remarques
