SwissMaverick/PROJ-2008_SablierElectronique/2008_SablierElectronique/doc/Version_E/Rendus/2008_Sablier_Electronique_Schematics_JJE.PDF

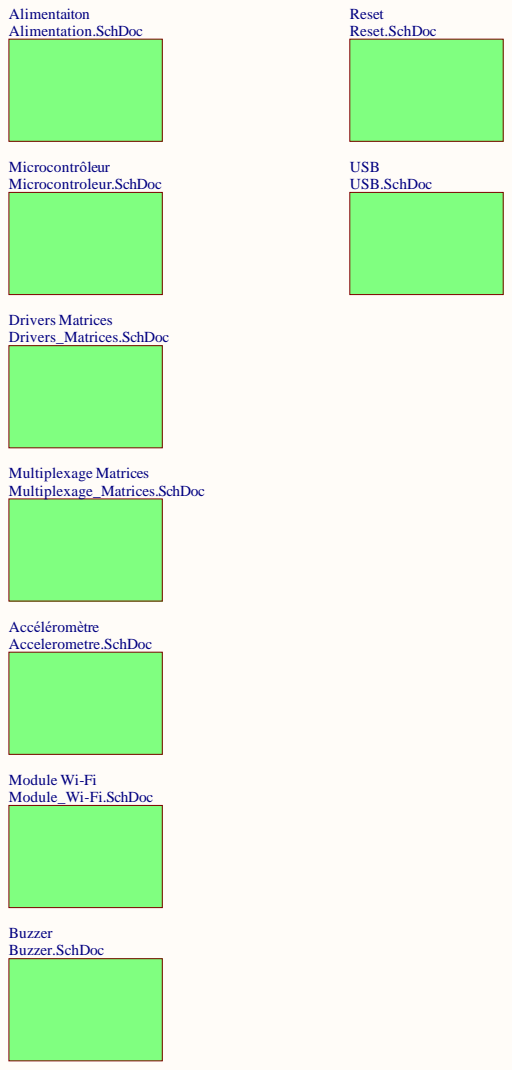
[picture p84: page 1]

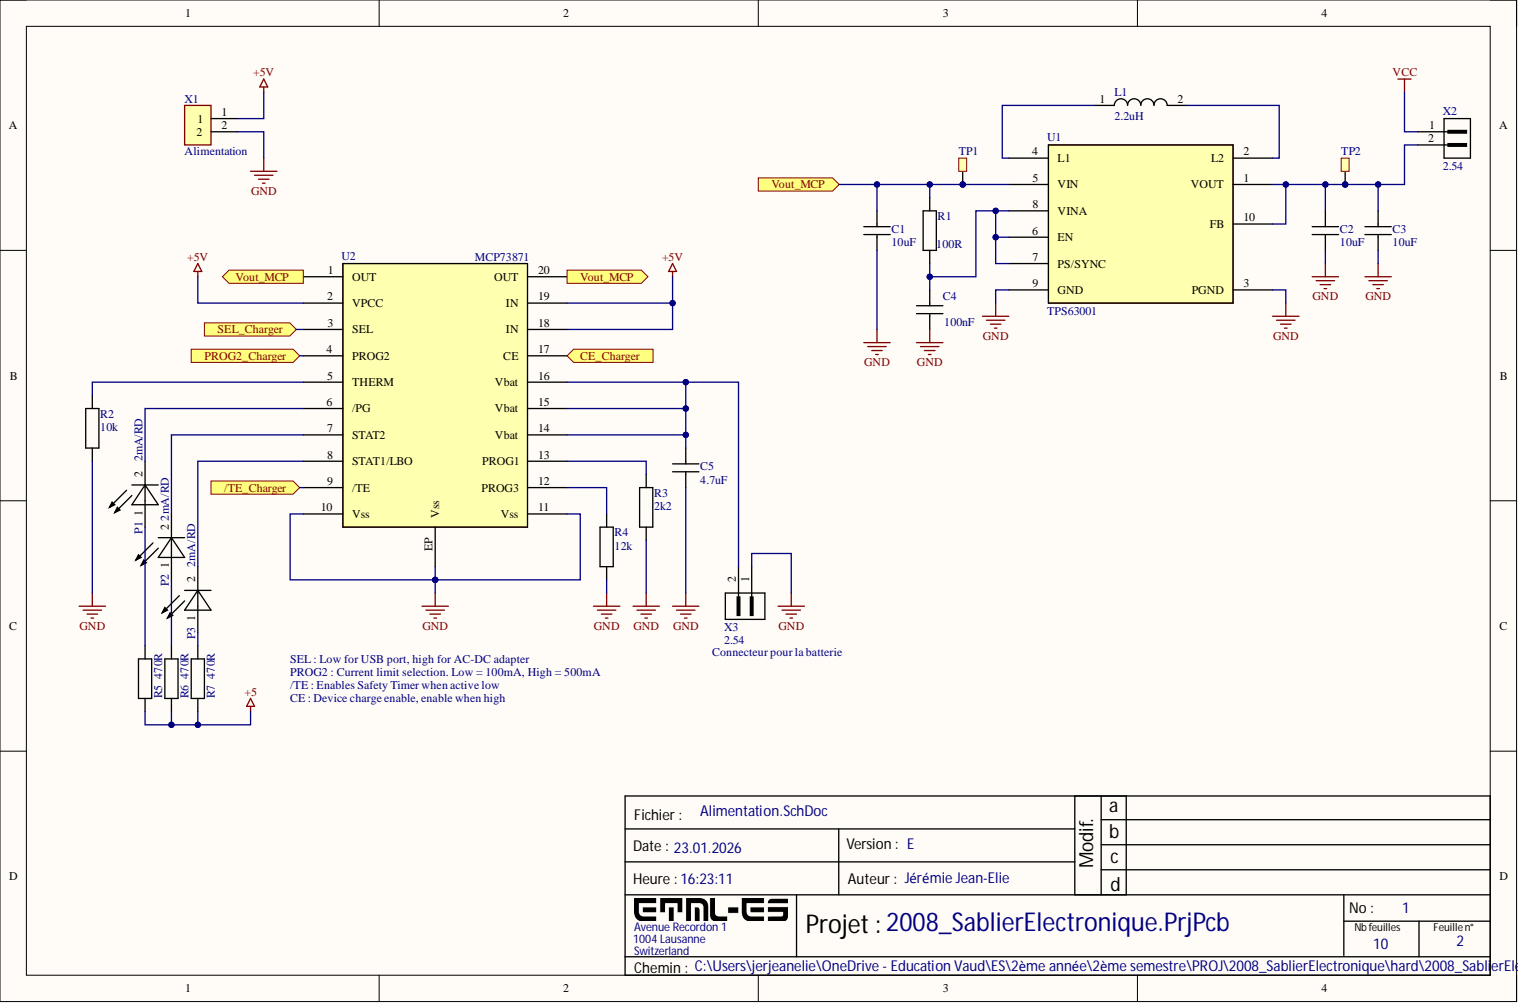
[picture p85: page 2]

V IN V O U T VIN A FB E N PS/SY N G N D N D
8 | | 1 0

/ T E _Char g er | 9 | 1 2

Alimentation. SchDoc Fichier :

Date : 23.01.2026 | Version : E

Heure : 16:23:11 | J é rémie Jean-Elie Auteur :
Avenue Re cordon 1 004 Lausanne Switzerland | Projet : 2008_SablierElectronique.Prj Pcb | No : 1

Nb feui l es | F eui e n°

Chemin : C:\Users\jerjeanelie\OneDrive - Education Vaud\E

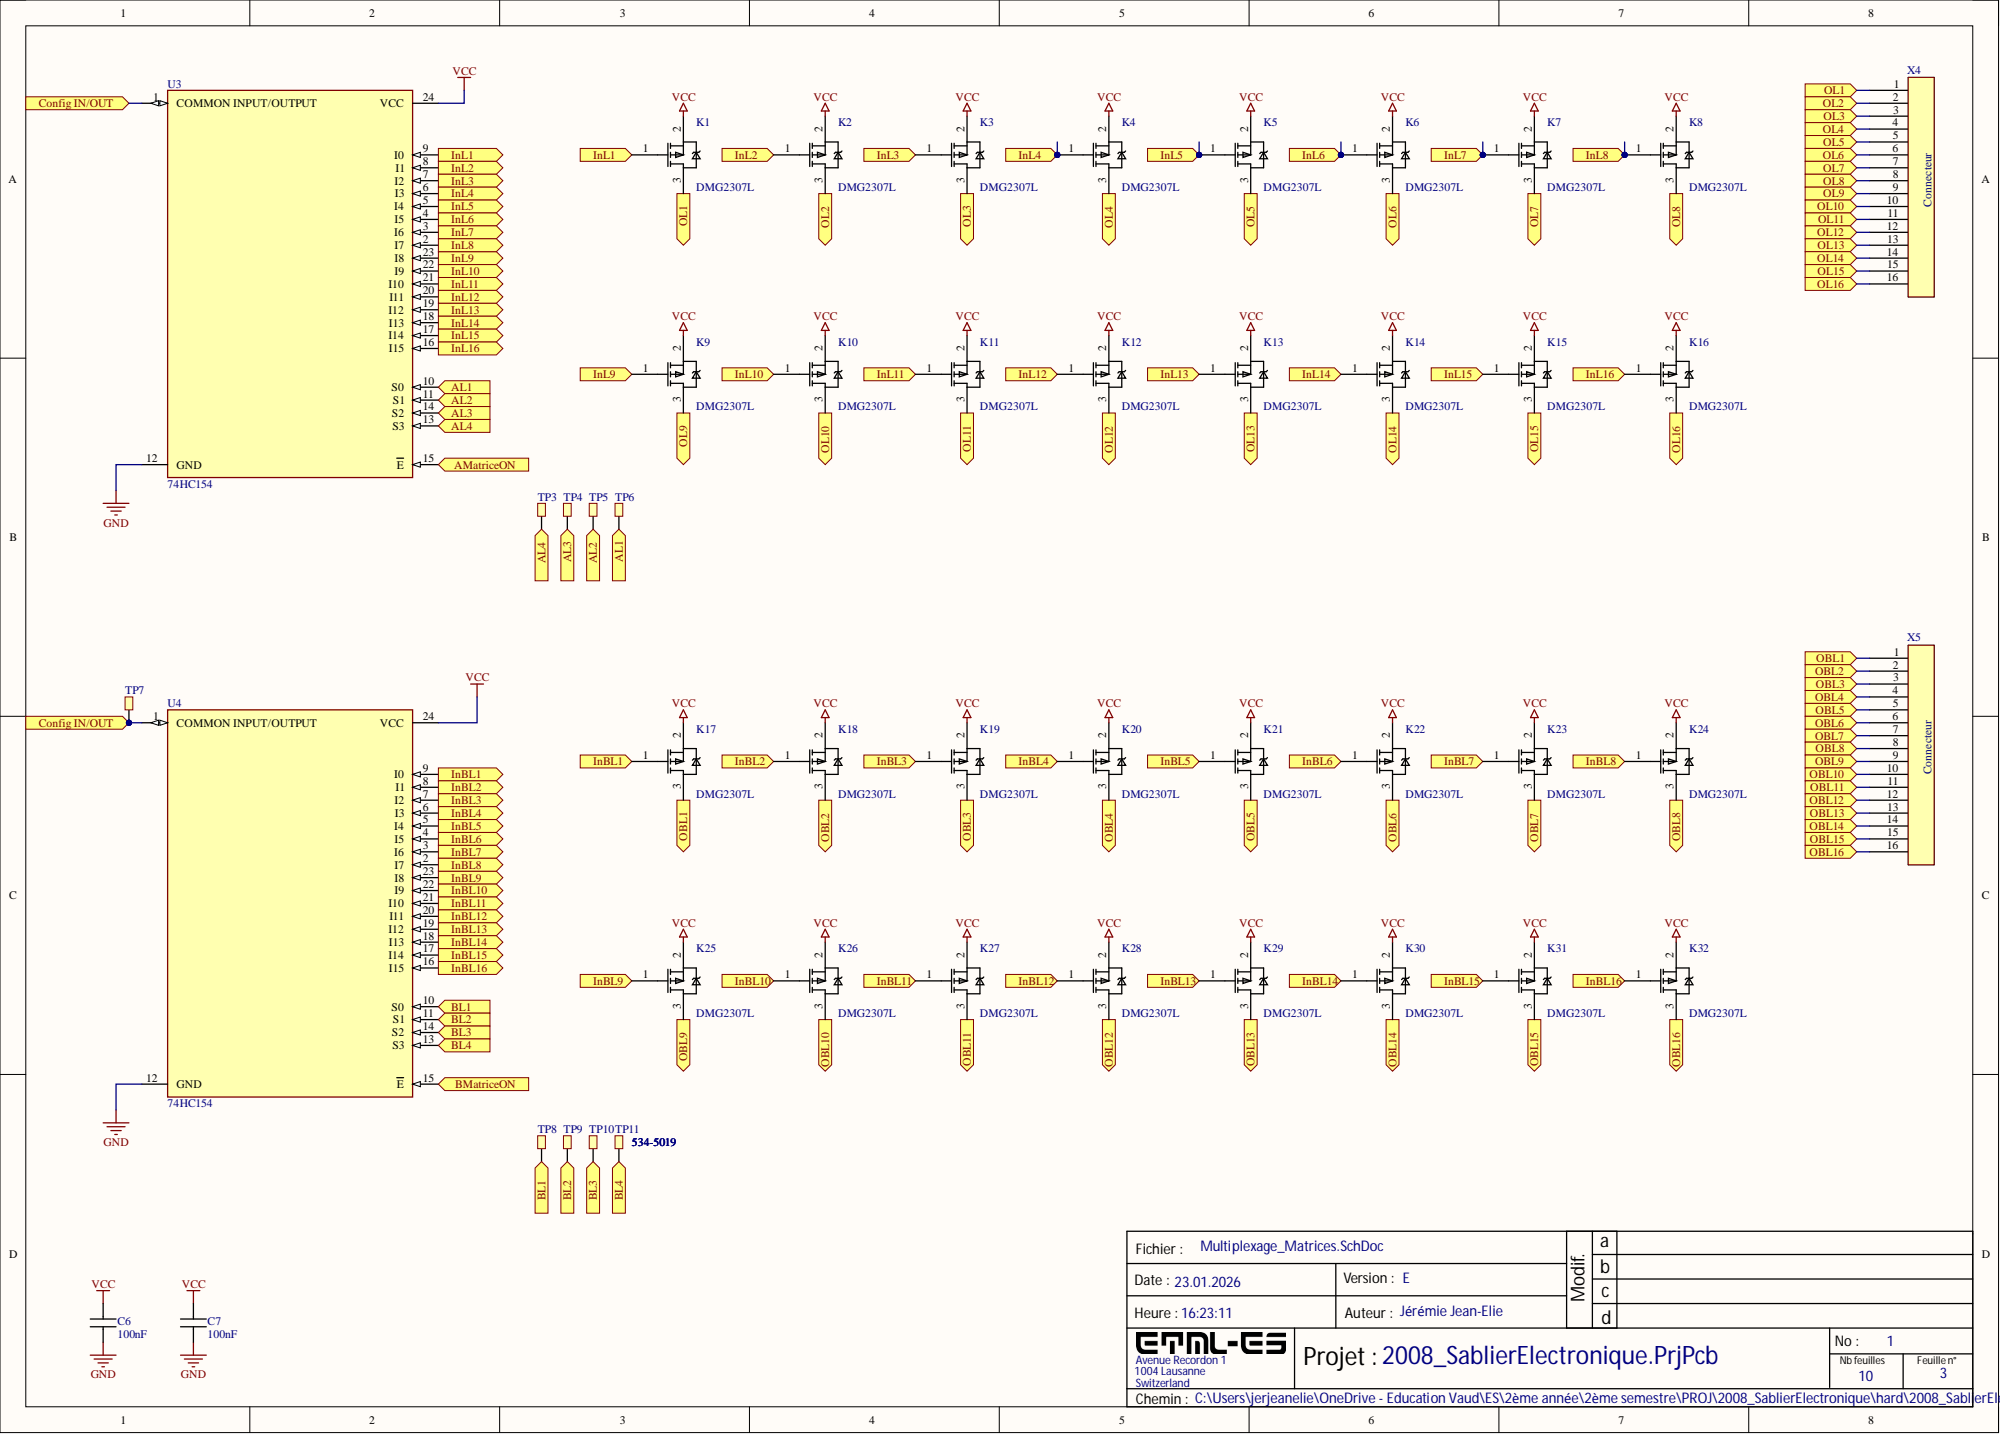
[picture p86: page 3]

Mult iple xage_Matrices. SchDoc Fichier :

Date : 23.01.2026 | Version : E

Heure : 16:23:11 | J é rémie Jean-Elie Auteur :
Avenue Re cordon 1 | Projet : 2008_SablierElectronique.Prj Pcb | No :

Nb feuille s | F euille n°

Chemin : C:\Users\jerjeanelie\OneDrive - Education Vaud\E

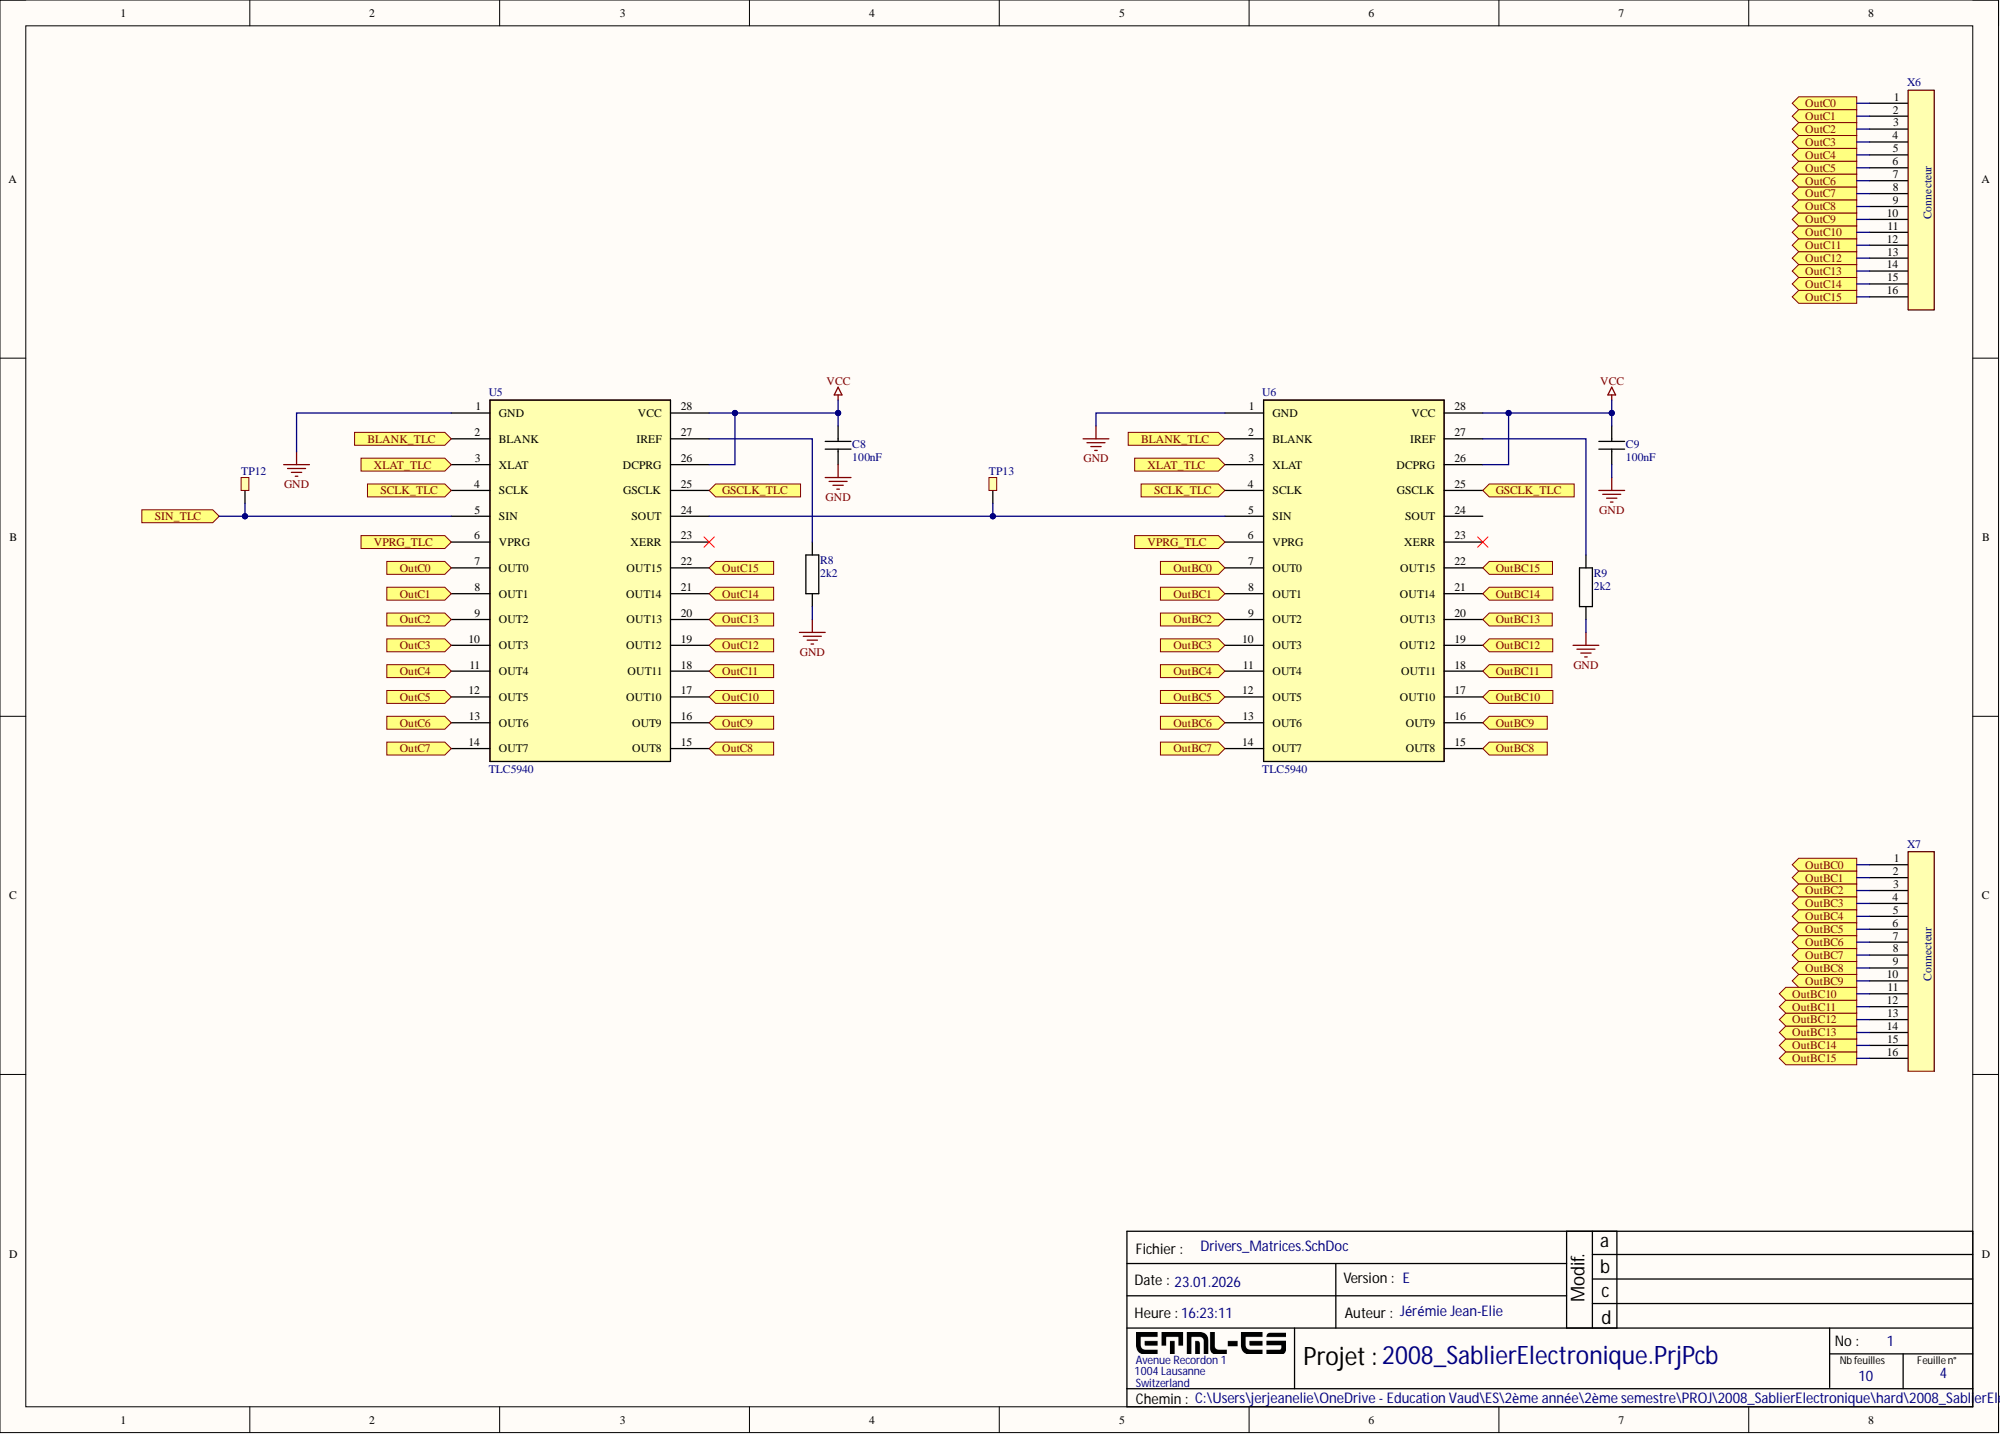
[picture p87: page 4]

Drivers_Matrices.SchDoc Fichier : | | a

Date : 23.01.2026 | Version : E

Heure : 16:23:11 | Jérémie Jean-Elie Auteur :
Avenue Recordon 1 | Projet : 2008_SablierElectronique.PrjPcb | No : 1

Nb feuilles 10 | Feuille n° 4

Chemin : C:\Users\jerjeanelie\OneDrive - Education Vaud\ES\2ème année\2ème semestre\PROJ\2008_SablierElectronique\hard\2008_SablierElectronique_E\2008_SablierElectronique\Drivers_Matrices.SchDoc

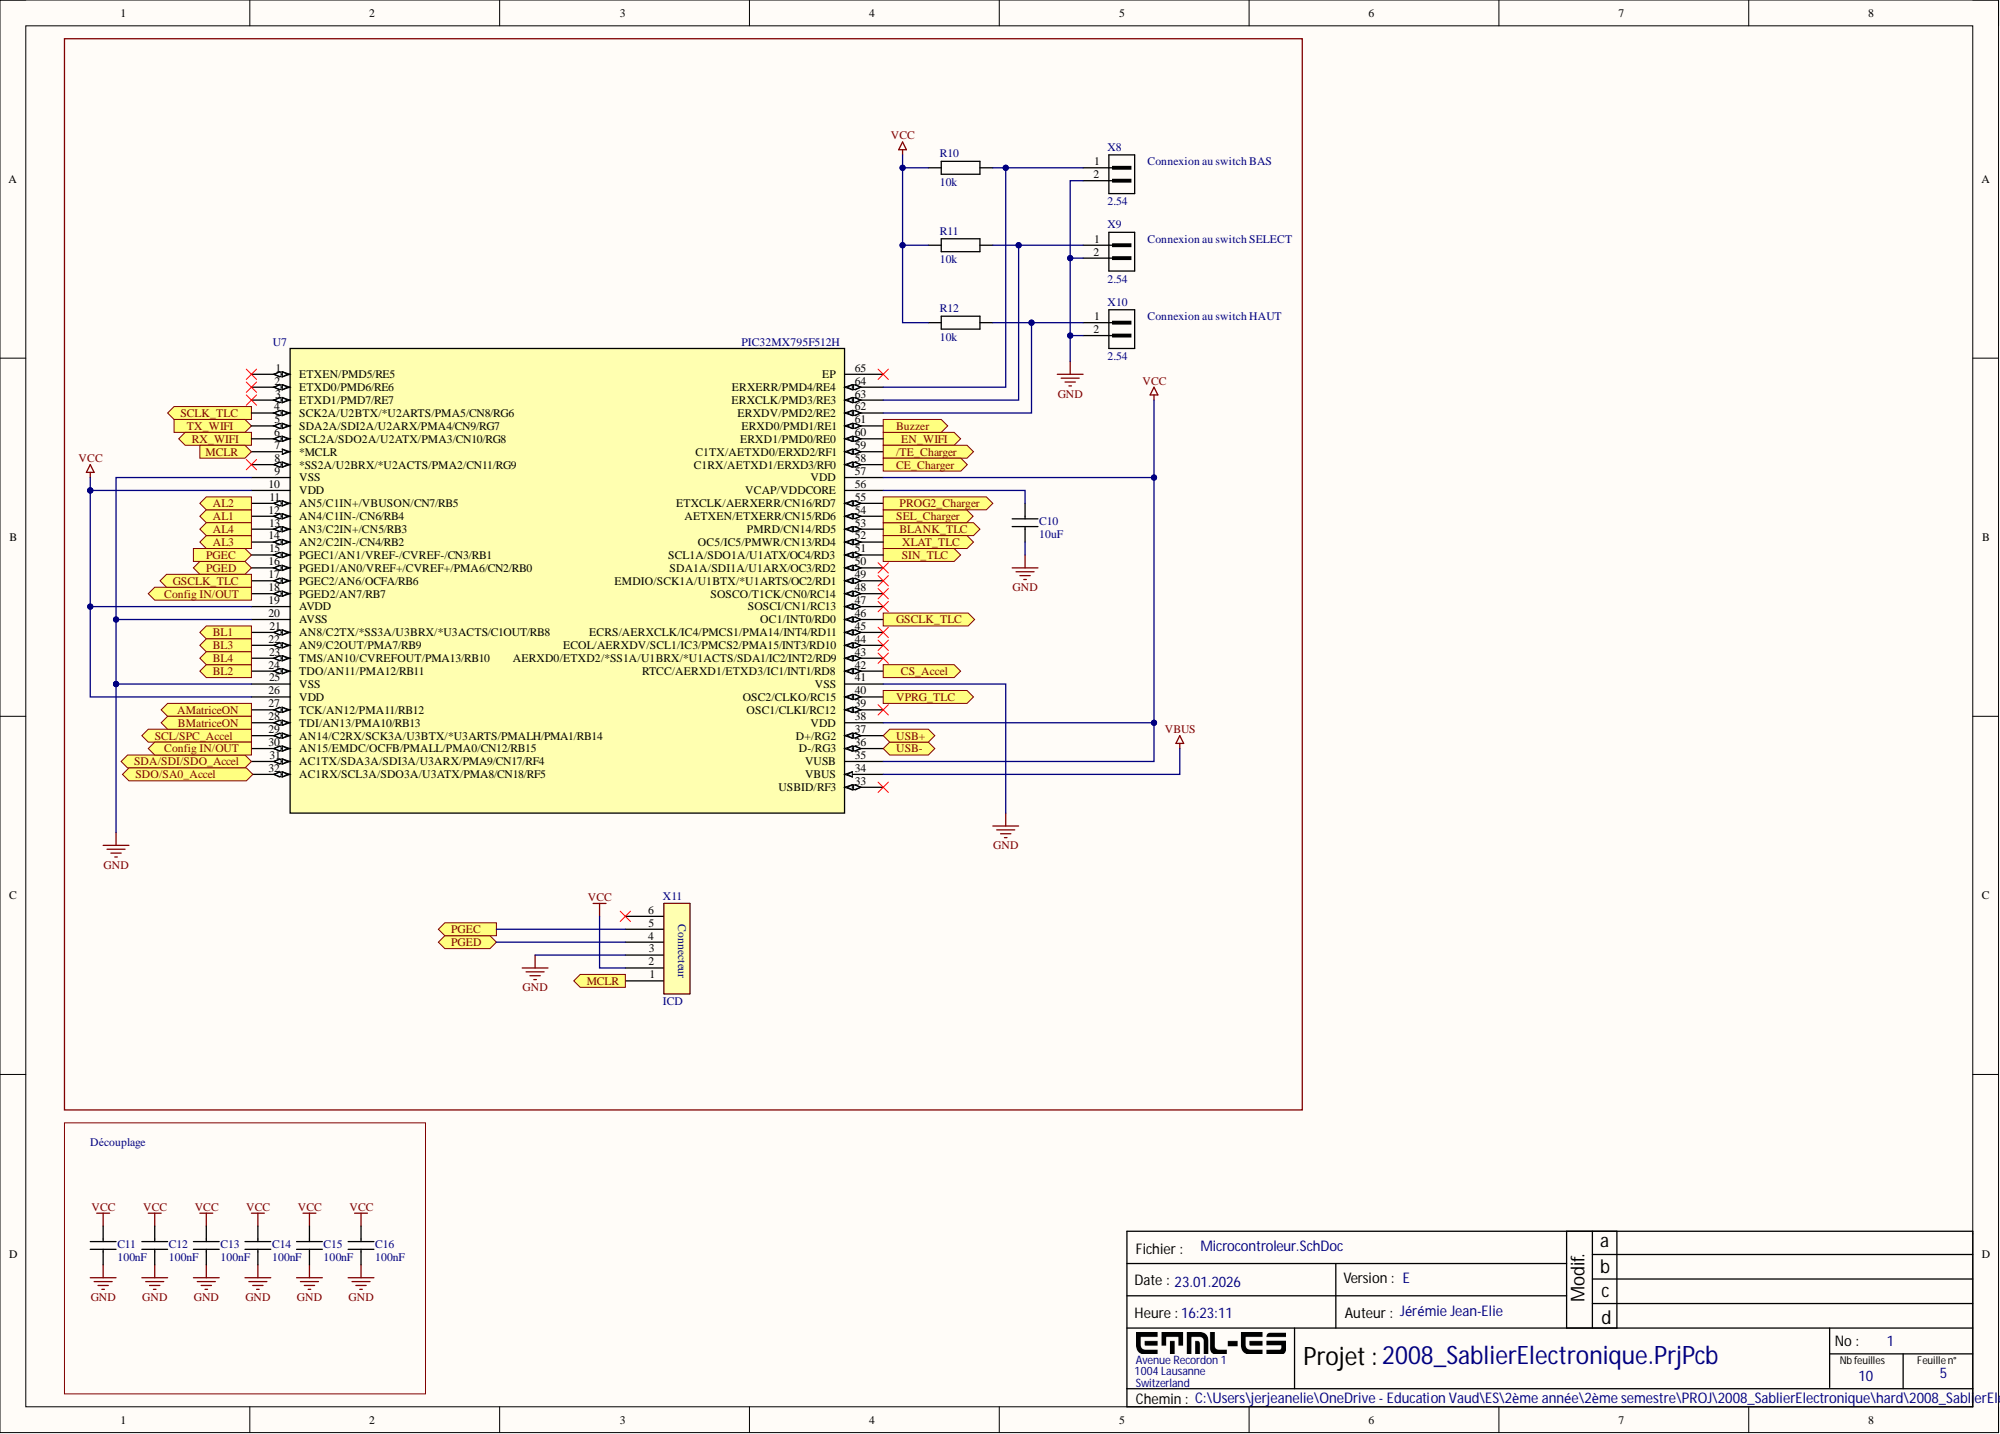
[picture p88: page 5]

Connexion au switch BAS

Connexion au switch SELECT

Connexion au switch HAUT

VDD 10 | | C10

AN4/C1IN-/CN6/RB4 12 | | GND GSCLK_TLC CS_Accel

Microcontroleur.SchDoc Fichier : | a

Date : 23.01.2026 | Version : E

Heure : 16:23:11 | Jérémie Jean-Elie Auteur :
Avenue Recordon 1 | Projet : 2008_SablierElectronique.PrjPcb | No : 1

Nb feuilles 10 | Feuille n° 5

Chemin : C:\Users\jerjeanelie\OneDrive - Education Vaud\ES\2ème année\2ème semestre\PROJ\2008_SablierElectronique\hard\2008_SablierElectronique_E\2008_SablierElectronique\Microcontroleur.SchDoc

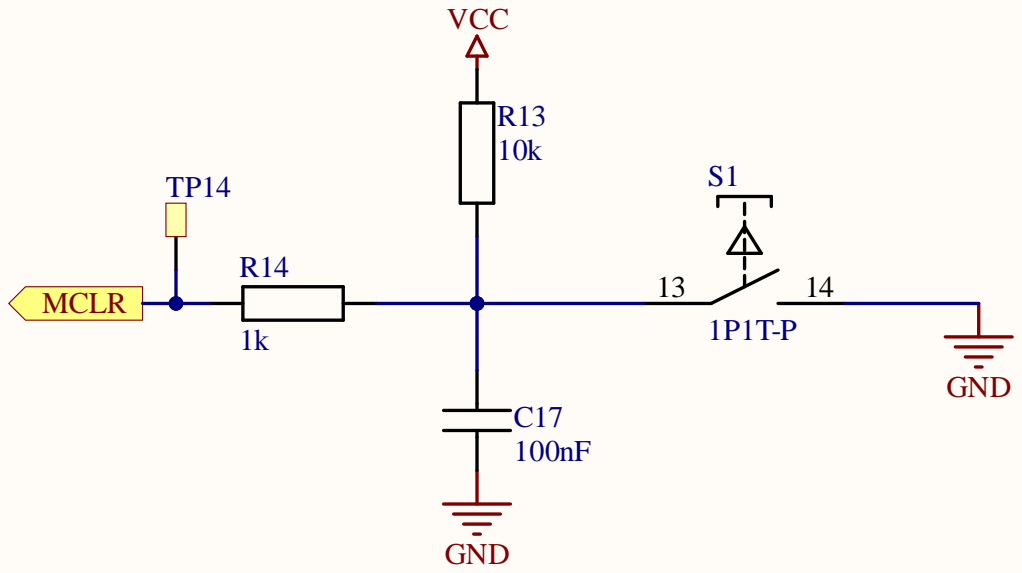
[picture p89: page 6]

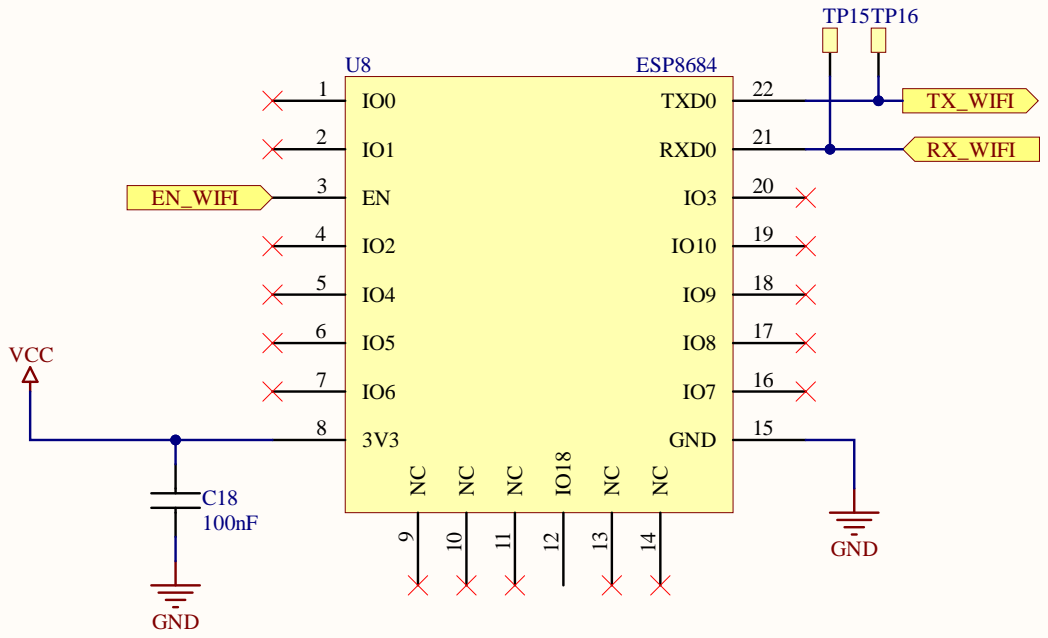
[picture p90: page 7]

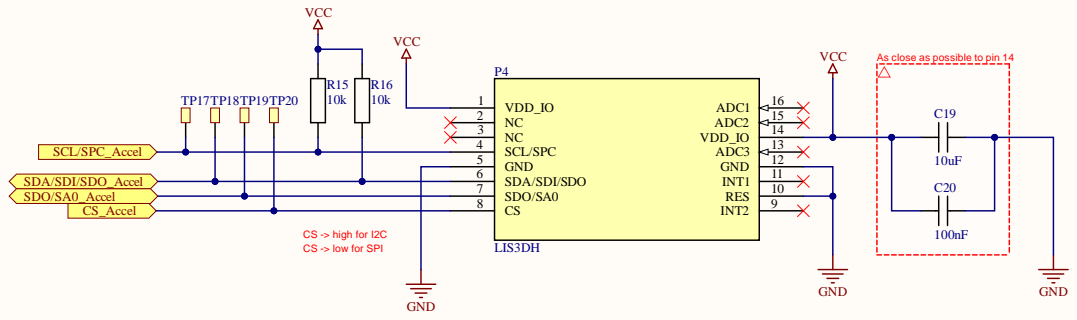
[picture p91: page 8]

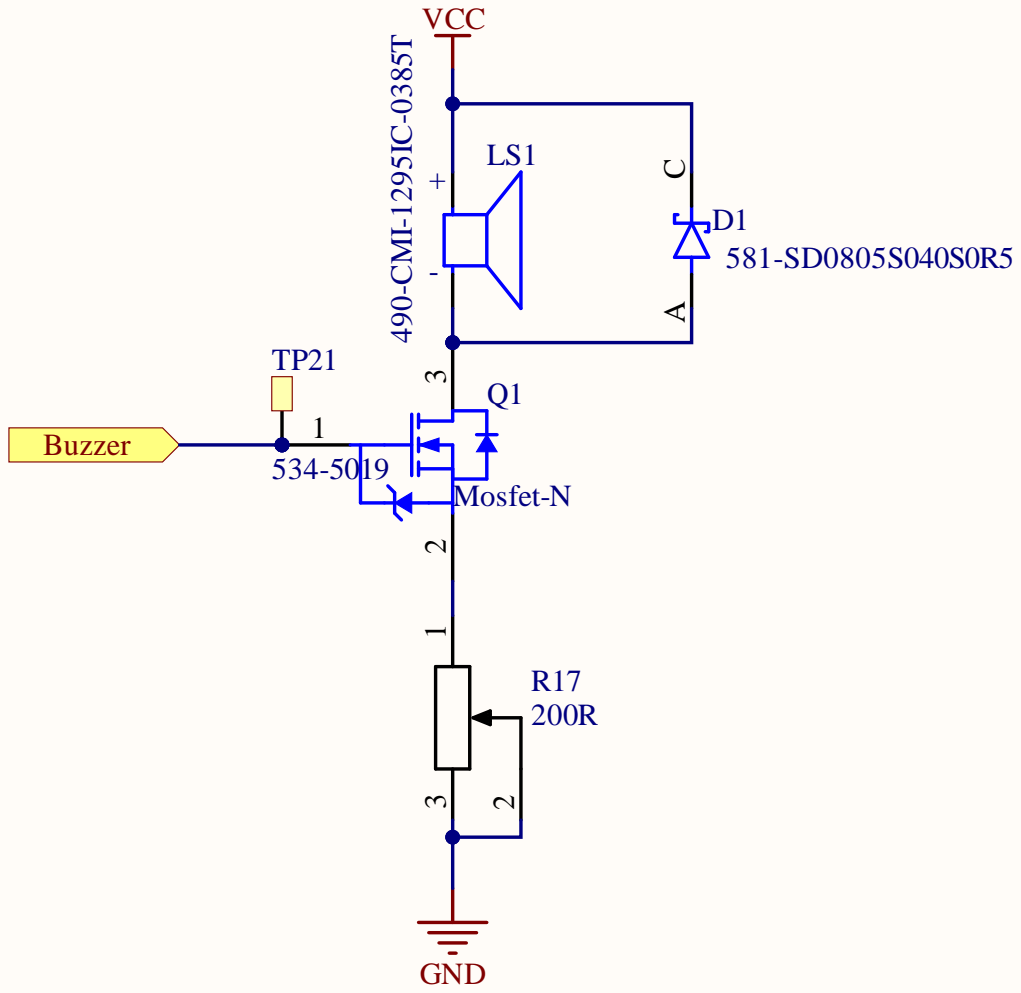
[picture p92: page 9]

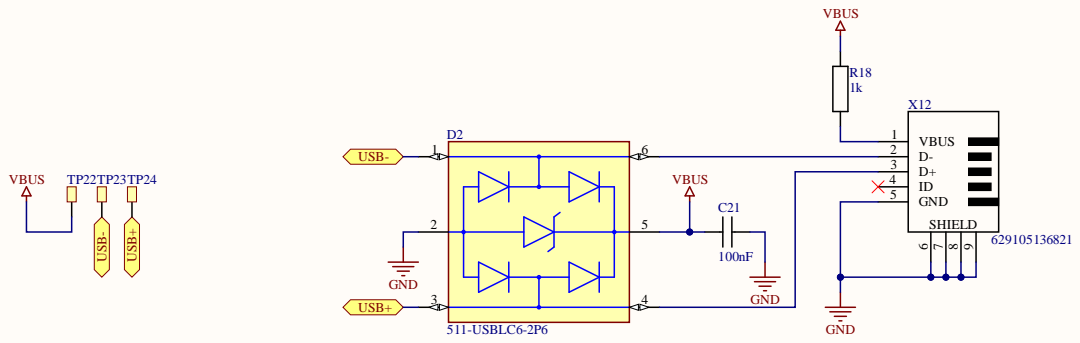
[picture p93: page 10]

VBU S | 4
