SwissMaverick/PROJ-2008_SablierElectronique/2008_SablierElectronique/hard/2008_SablierElectronique_E/2008_SablierElectronique/Project Outputs for 2008_SablierElectronique/Sablier_schematics.PDF

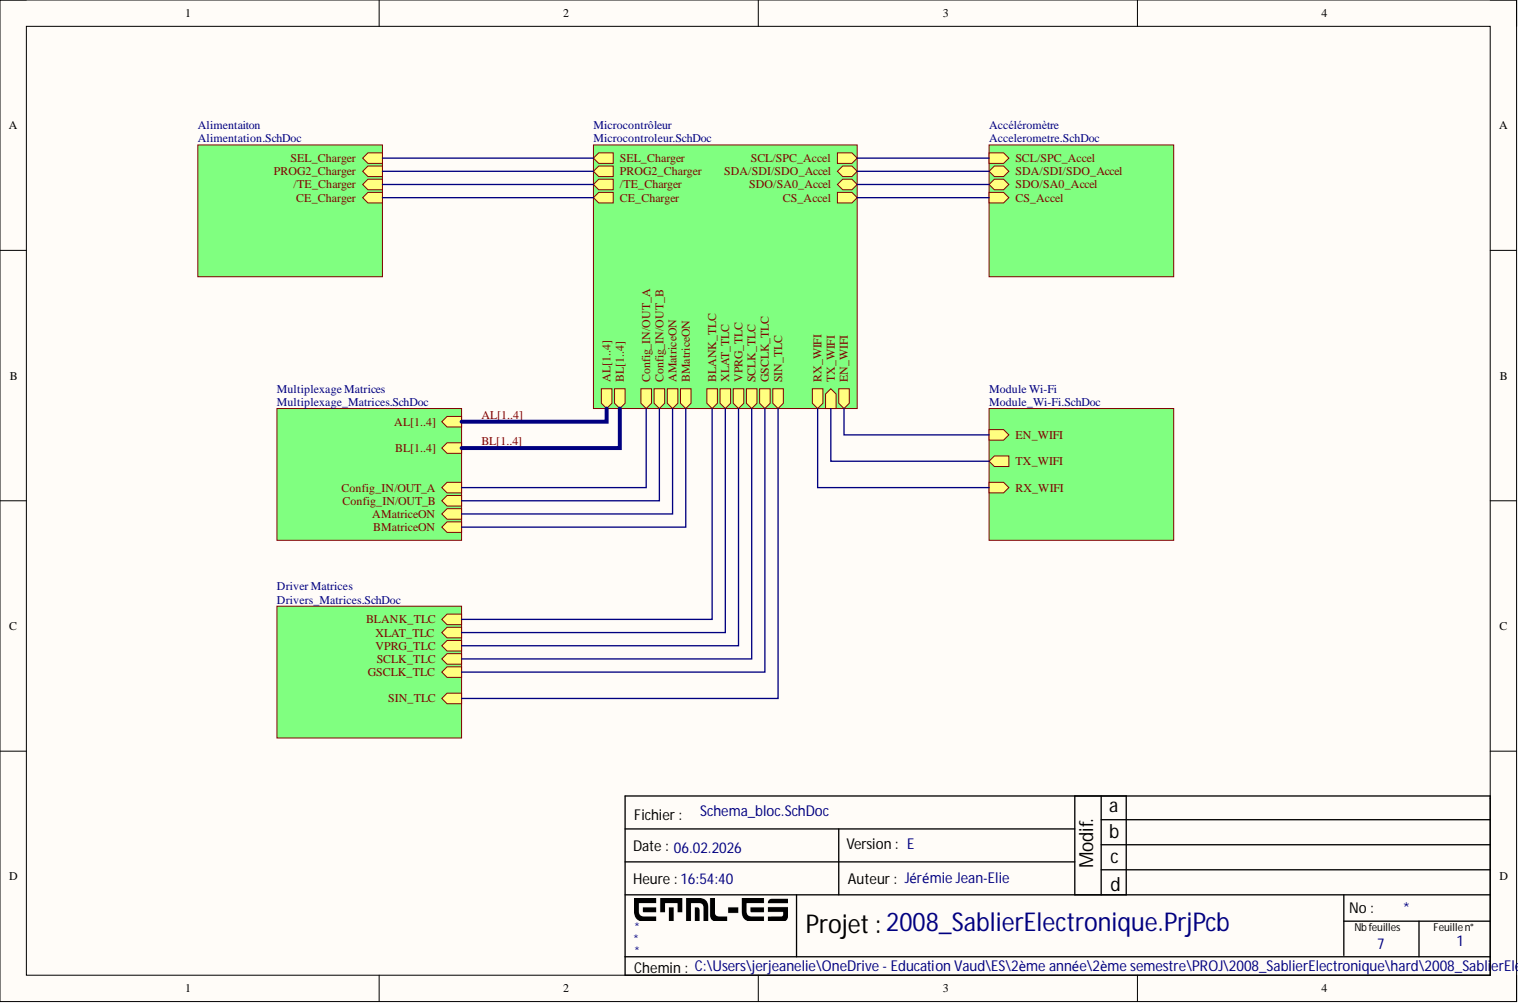
[picture p94: page 1]

Schema_bloc.SchDoc Fichier : | | a

Date : 06.02.2026 | Version : E

Heure : 16:54:40 | Jérémie Jean-Elie Auteur :
* * * | Projet : 2008_SablierElectronique.PrjPcb | No : *

Nb feuilles | Feuille n°

Chemin : C:\Users\jerjeanelie\OneDrive - Education Vaud\ES\2ème année\2ème semestre\PROJ\2008_SablierElectronique\hard\2008_SablierElectronique_E\2008_SablierElectronique\Schema_bloc.SchDoc

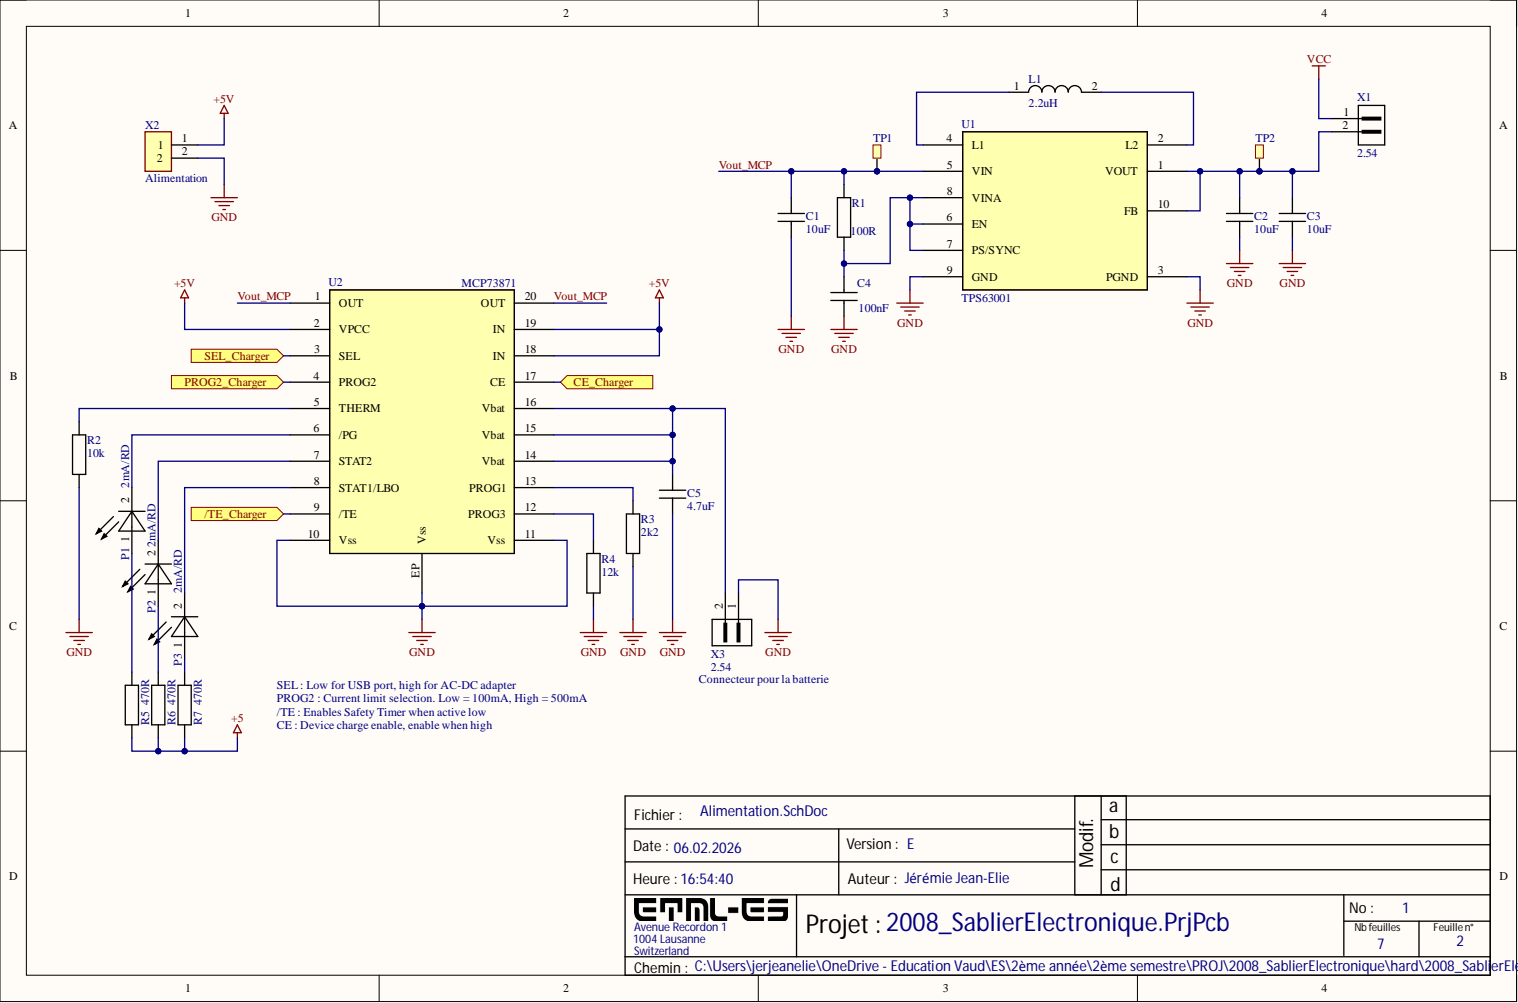
[picture p95: page 2]

/ T E _Char g er | 9 | 1 2

Alimentation. SchDoc Fichier :

Date : 06.02.2026 | Version : E

Heure : 16:54:40 | J é rémie Jean-Elie Auteur :
Avenue Re cordon 1 004 Lausanne Switzerland | Projet : 2008_SablierElectronique.Prj Pcb | No : 1

Nb feui l es | F eui e n°

Chemin : C:\Users\jerjeanelie\OneDrive - Education Vaud\E

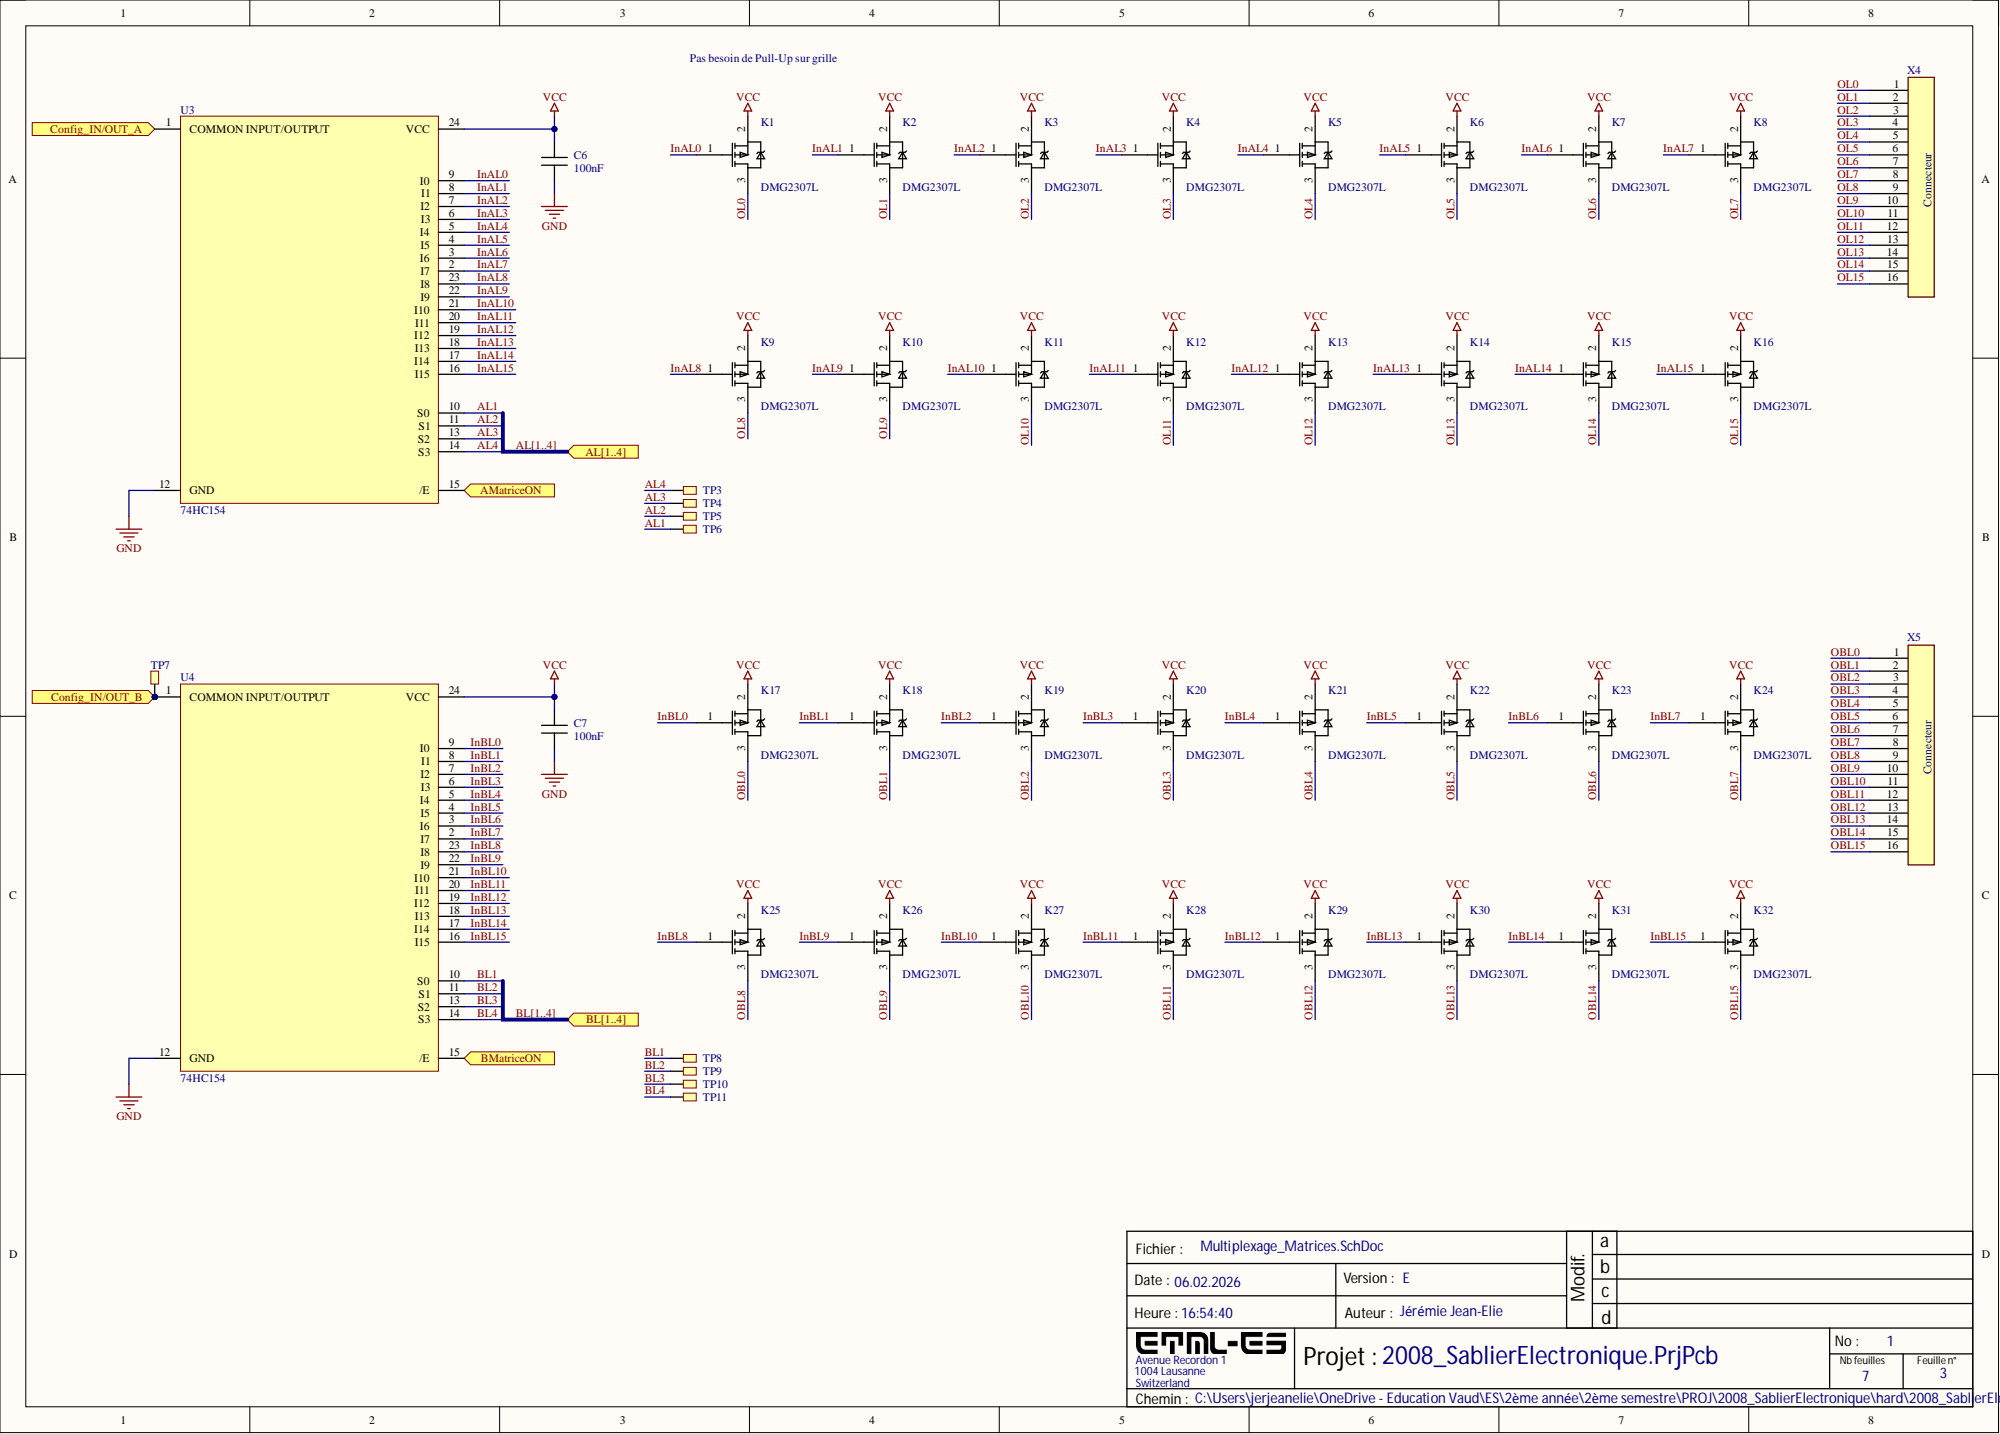
[picture p96: page 3]

VCC VCC GND GND

Mult iple xage_Matrices. SchDoc Fichier :

Date : 06.02.2026 | Version : E

Heure : 16:54:40 | J é rémie Jean-Elie Auteur :

: 2008_SablierElectronique.Prj Pcb | No :

feuille s | euille

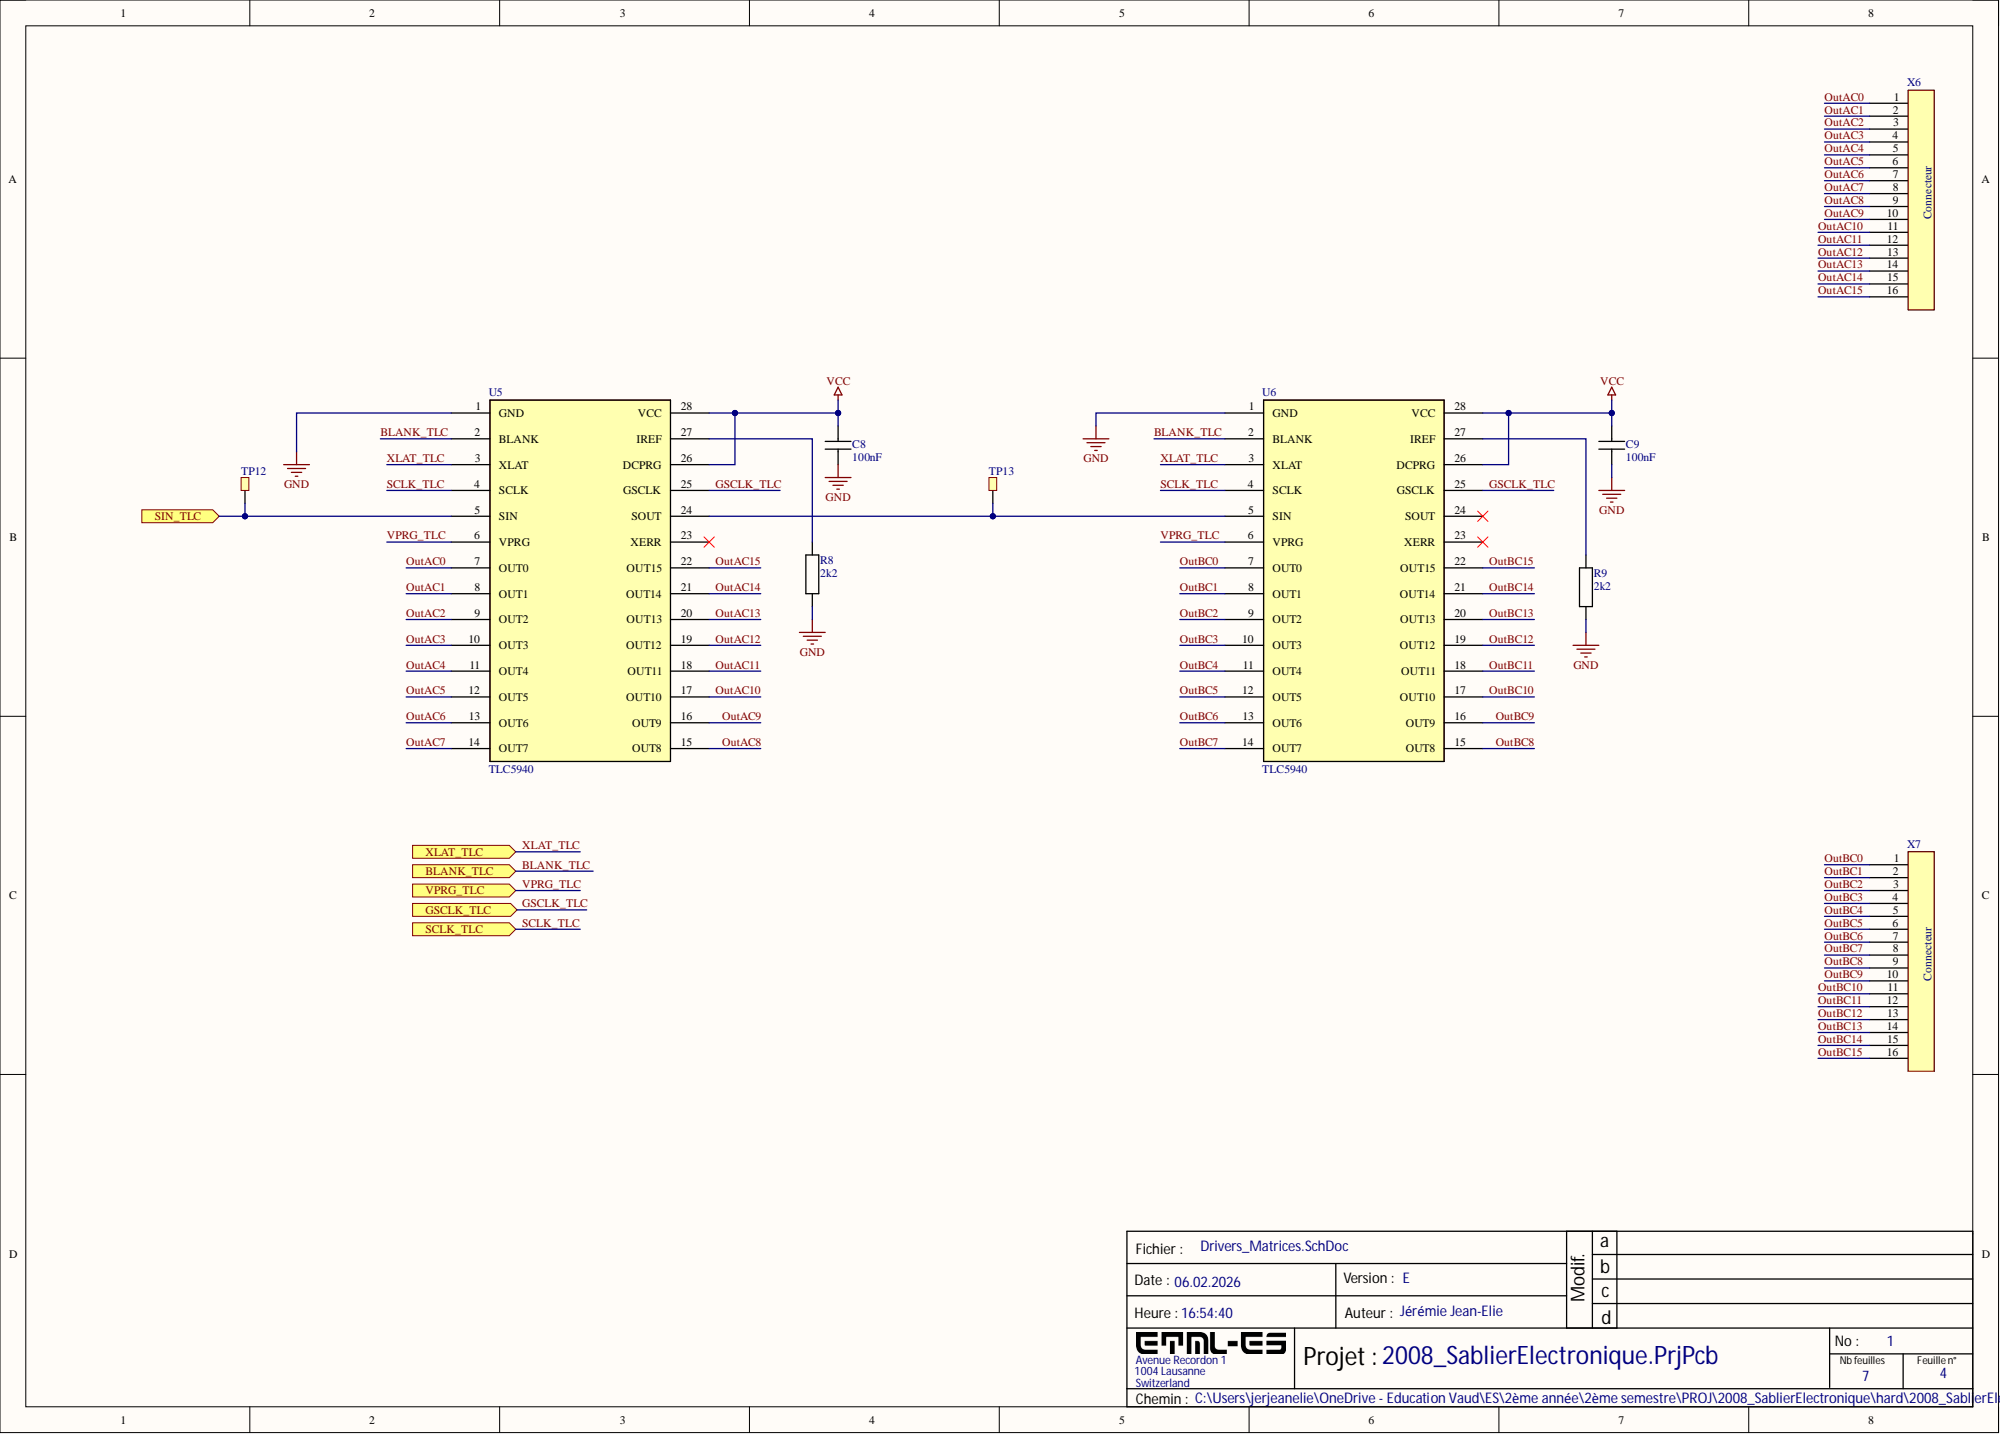
[picture p97: page 4]

Drivers_Matrices. SchDoc Fichier :

Date : 06.02.2026 | Version : E

J é rémie Jean-Elie
: 2008_SablierElectronique.Prj Pcb | No :

feuille s | euille

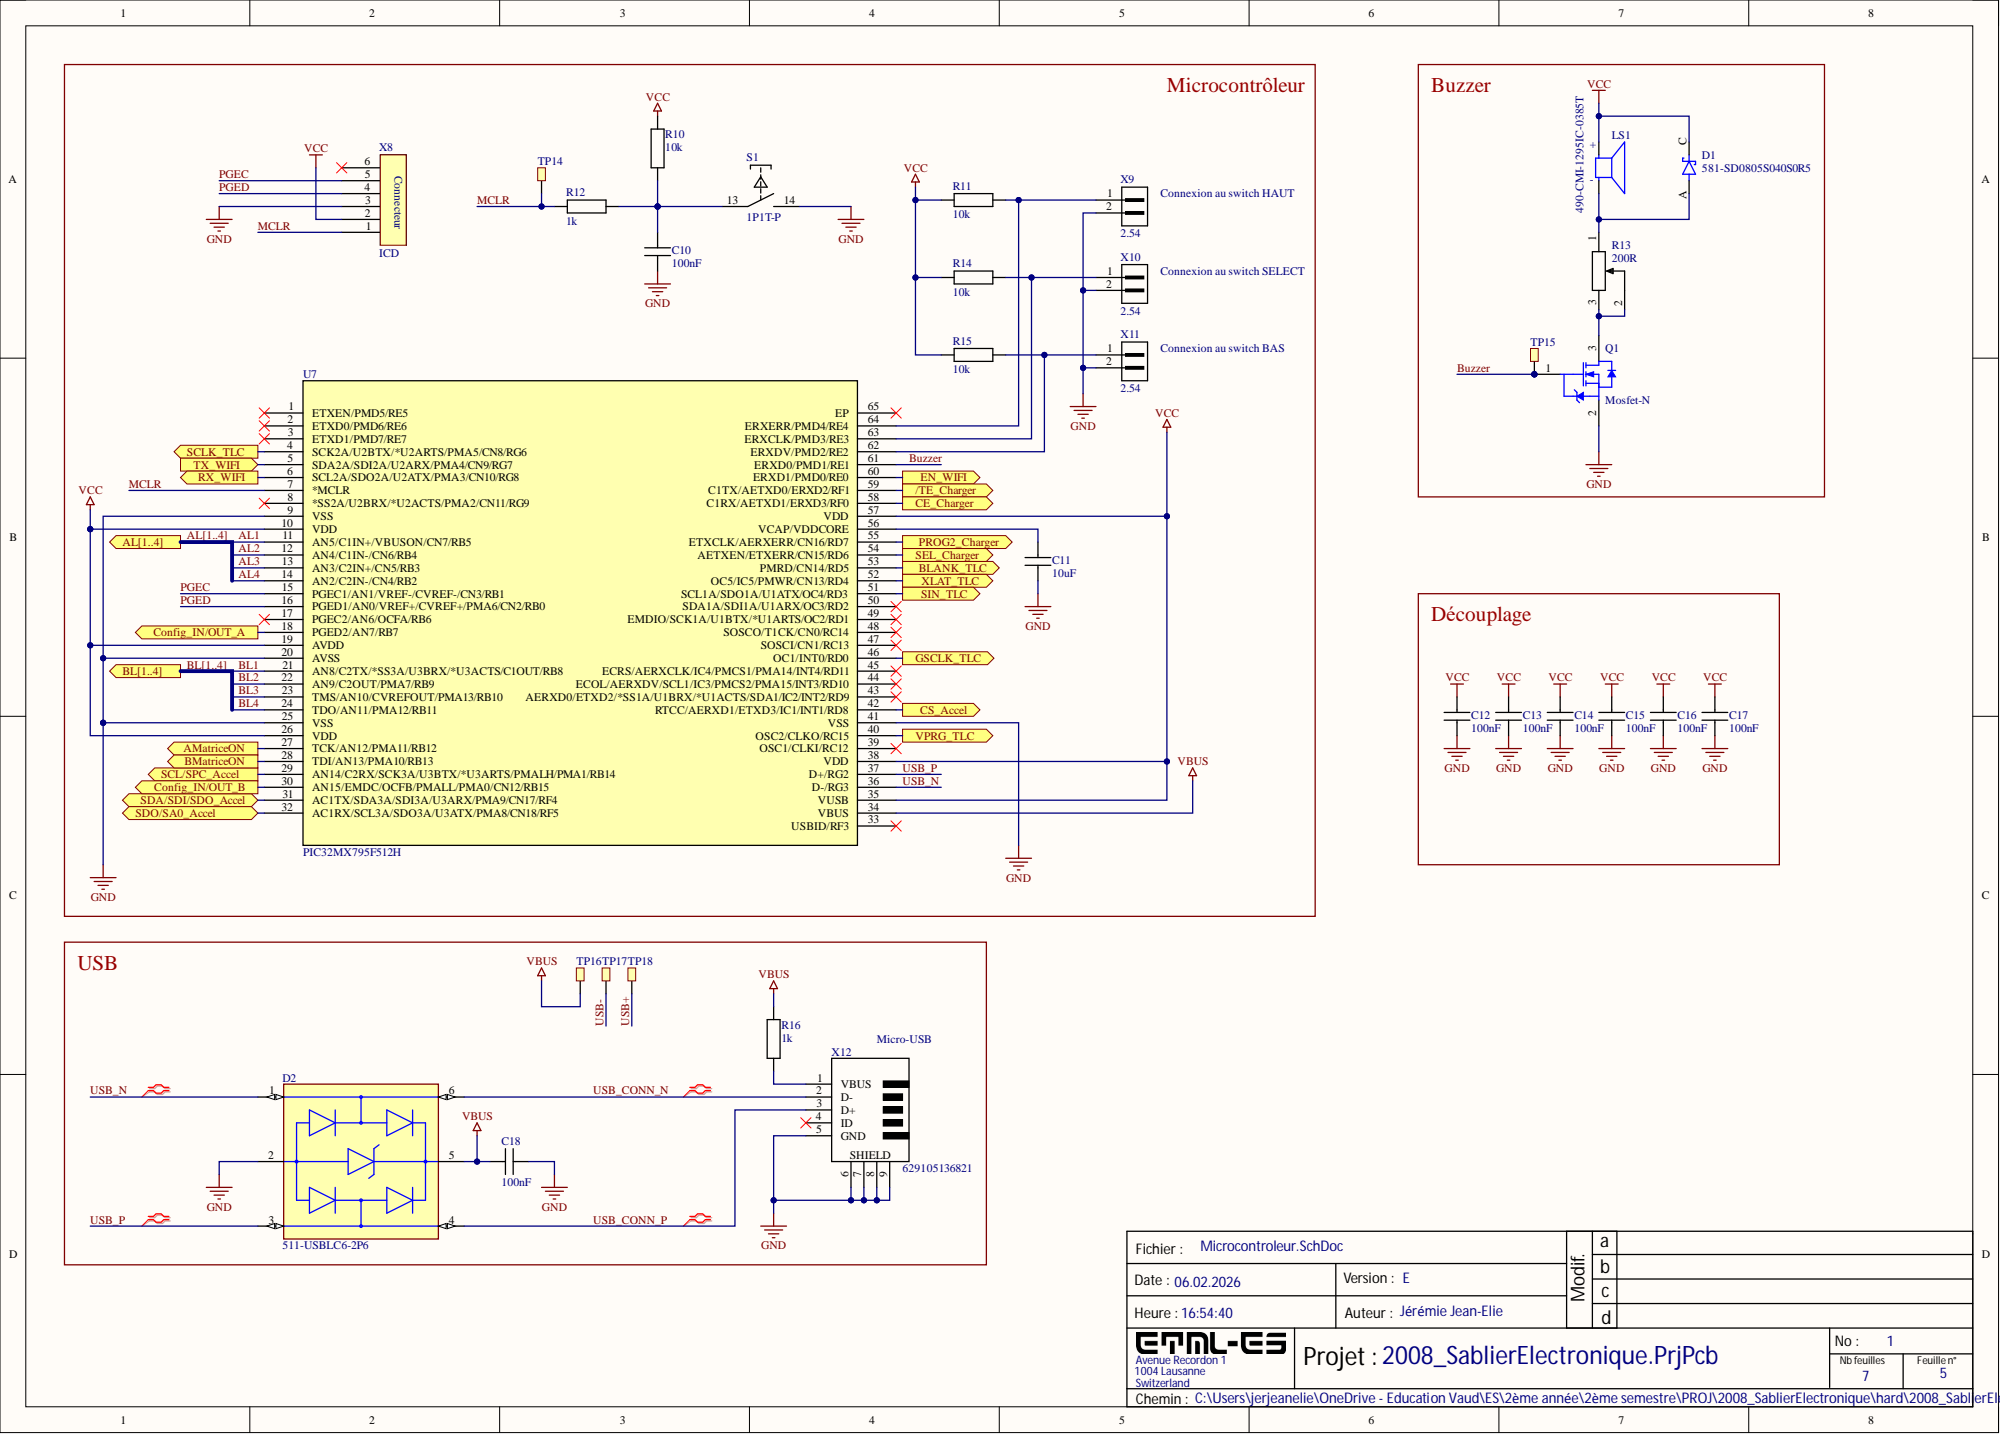
[picture p98: page 5]

Connexion au switch HAUT

Connexion au switch SELECT

Connexion au switch BAS

VDD 10 | C11

AL[1..4] AL1 | AN5/C1IN+/VBUSON/CN7/RB5 11

AL2 | AN4/C1IN-/CN6/RB4 12 | GND GSCLK_TLC CS_Accel
AL3 | AN3/C2IN+/CN5/RB3 13
AL4 | AN2/C2IN-/CN4/RB2 14

AVSS 20

BL[1..4] BL1 | | AN8/C2TX/*SS3A/U3BRX/*U3ACTS/C1OUT/RB8 21

BL2 | | AN9/C2OUT/PMA7/RB9 22
BL3 | | TMS/AN10/CVREFOUT/PMA13/RB10 23
BL4 | | TDO/AN11/PMA12/RB11 24

AN14/C2RX/SCK3A/U3BTX/*U3ARTS/PMALH/PMA1/RB14 29 | USB_P
AN15/EMDC/OCFB/PMALL/PMA0/CN12/RB15 30 | USB_N

Date : 06.02.2026 | Version : E

Jérémie Jean-Elie

Avenue Recordon 1 | Projet : 2008_SablierElectronique.PrjPcb | No : 1

Chemin : C:\Users\jerjeanelie\OneDrive - Education Vaud\ES\2ème année\2ème semestre\PROJ\2008_SablierElectronique\hard\2008_SablierElectronique_E\2008_SablierElectronique\Microcontroleur.SchDoc

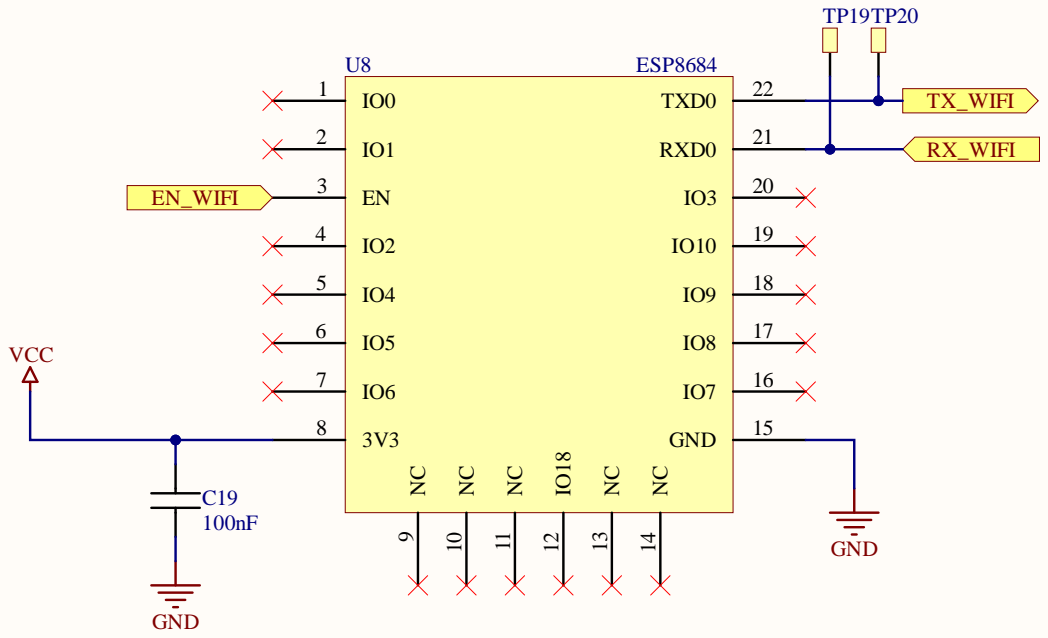
[picture p99: page 6]

Module_Wi-Fi.SchDoc Fichier : | | a

Date : 06.02.2026 | Version : E

Heure : 16:54:40 | Jérémie Jean-Elie Auteur :
* * * | Projet : 2008_SablierElectronique.PrjPcb | No : *

Chemin : C:\Users\jerjeanelie\OneDrive - Education Vaud\ES\2ème année\2ème semestre\PROJ\2008_SablierElectronique\hard\2008_SablierElectronique_E\2008_SablierElectronique\Module_Wi-Fi.SchDoc

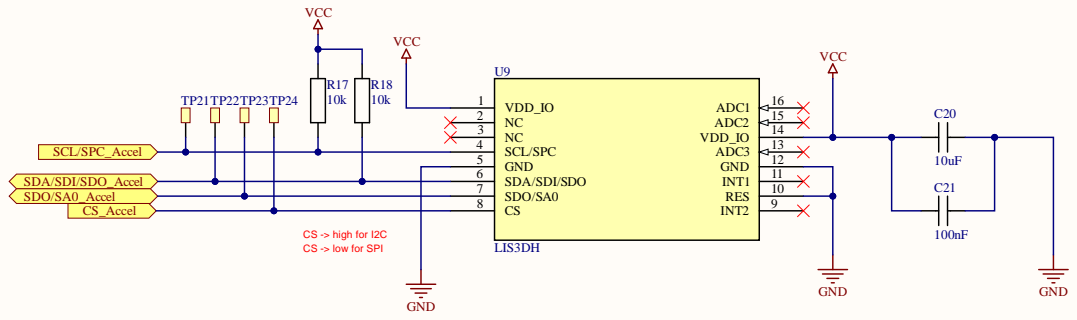
[picture p100: page 7]

Accelerometre. SchDoc Fichier :

Date : 06.02.2026 | Version : E

Heure : 16:54:40 | J é rémie Jean-Elie Auteur :
*** | : 2008_SablierElectronique.Prj Pcb | No : *

feui es | eui
