SwissMaverick/PROJ-2008_SablierElectronique/2008_SablierElectronique/hard/2008_SablierElectronique_PCB/Project Outputs for 2008_SablierElectronique/DesignDocs/Dimensional Drawings.PDF

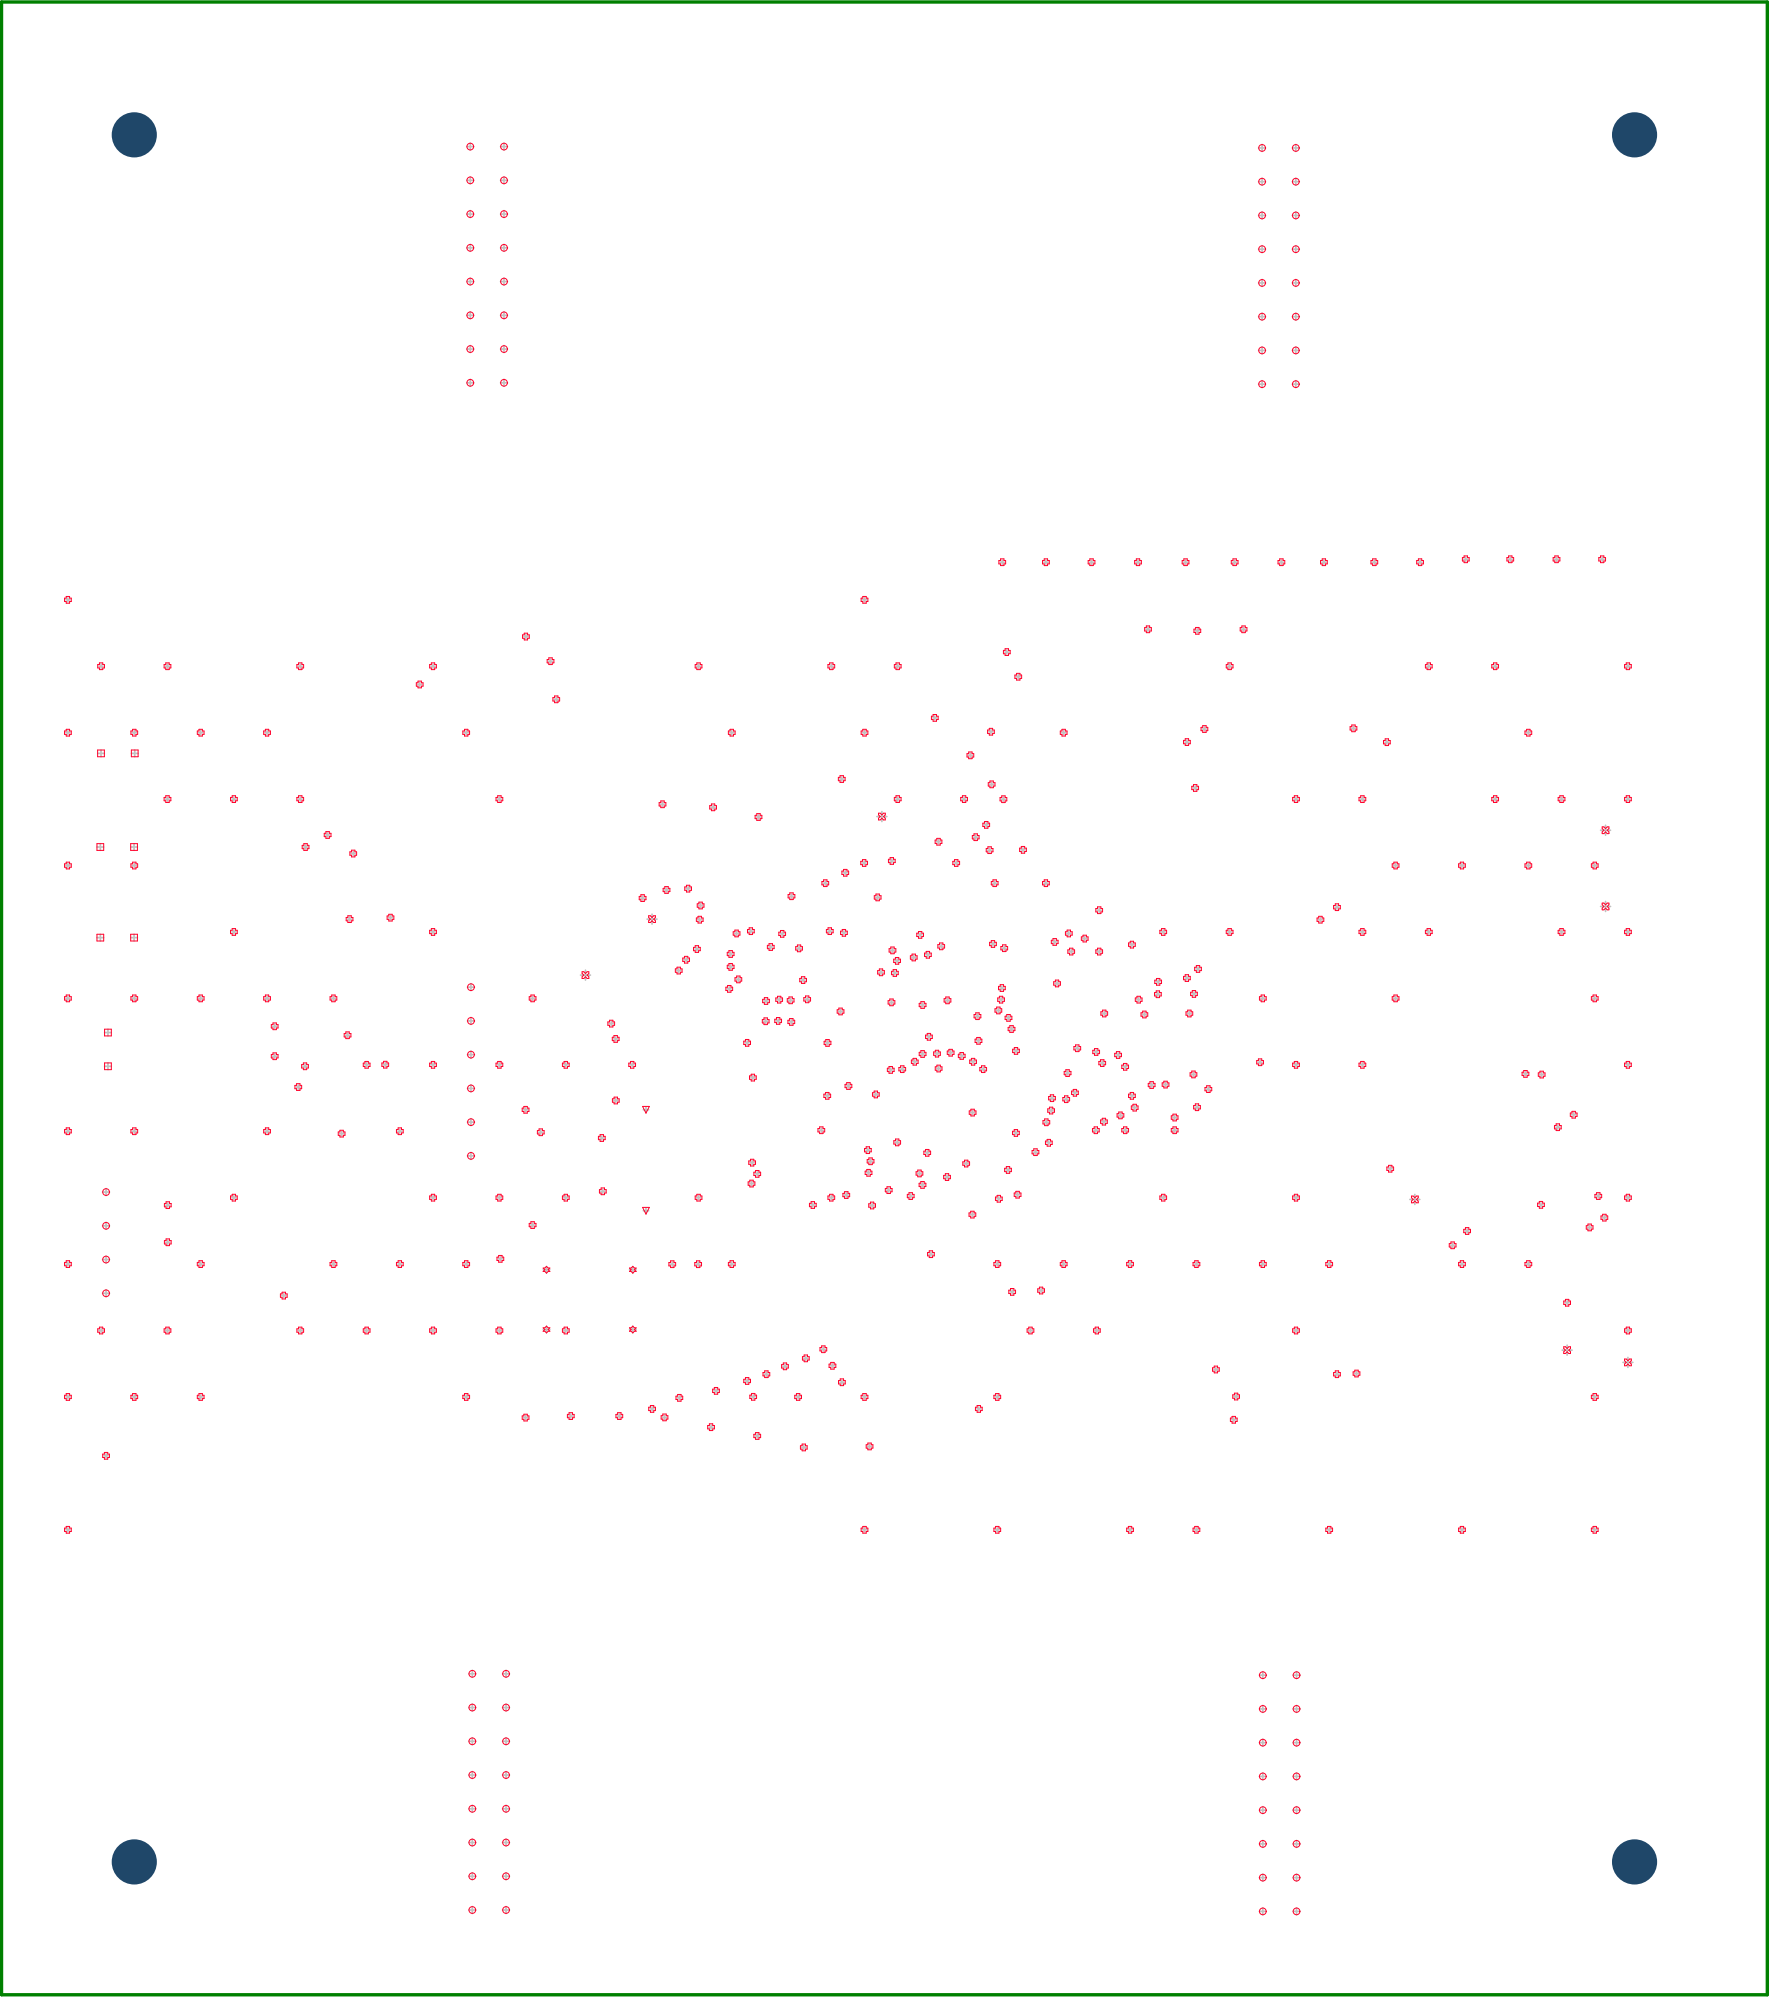
[picture p101: page 1]
