SwissMaverick/PROJ-2008_SablierElectronique/2008_SablierElectronique/hard/2008_SablierElectronique_PCB/Project Outputs for 2008_SablierElectronique/DesignDocs/PCB Top-Bottom Assy Dwgs.PDF

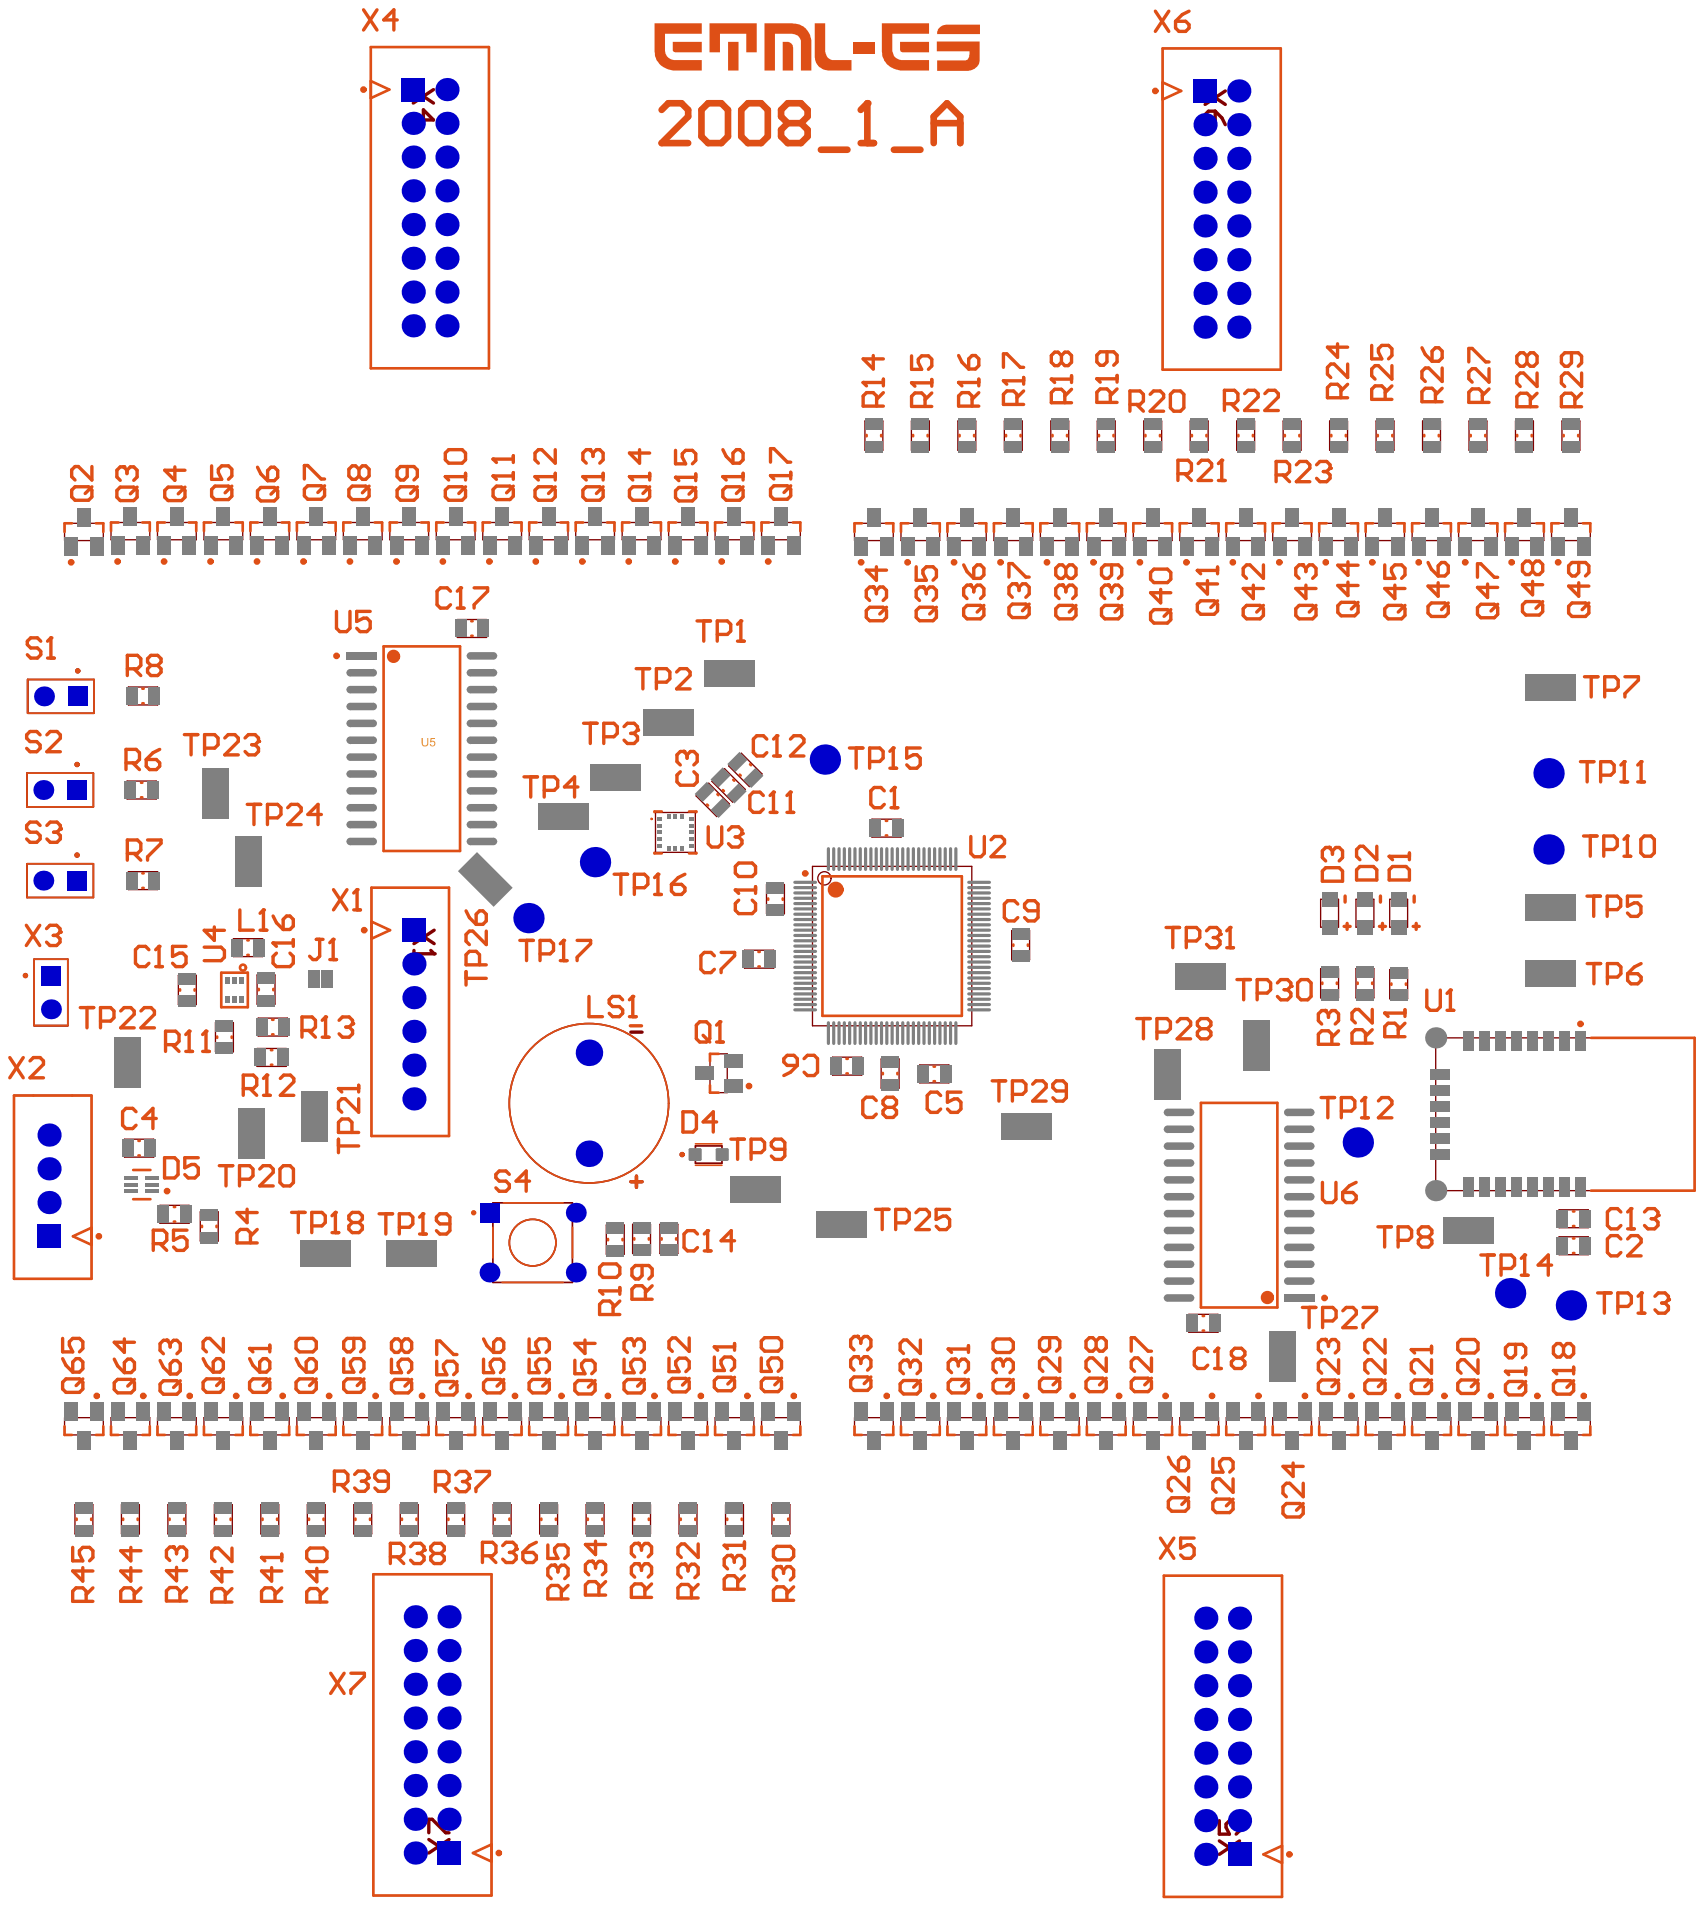
[picture p102: page 1]

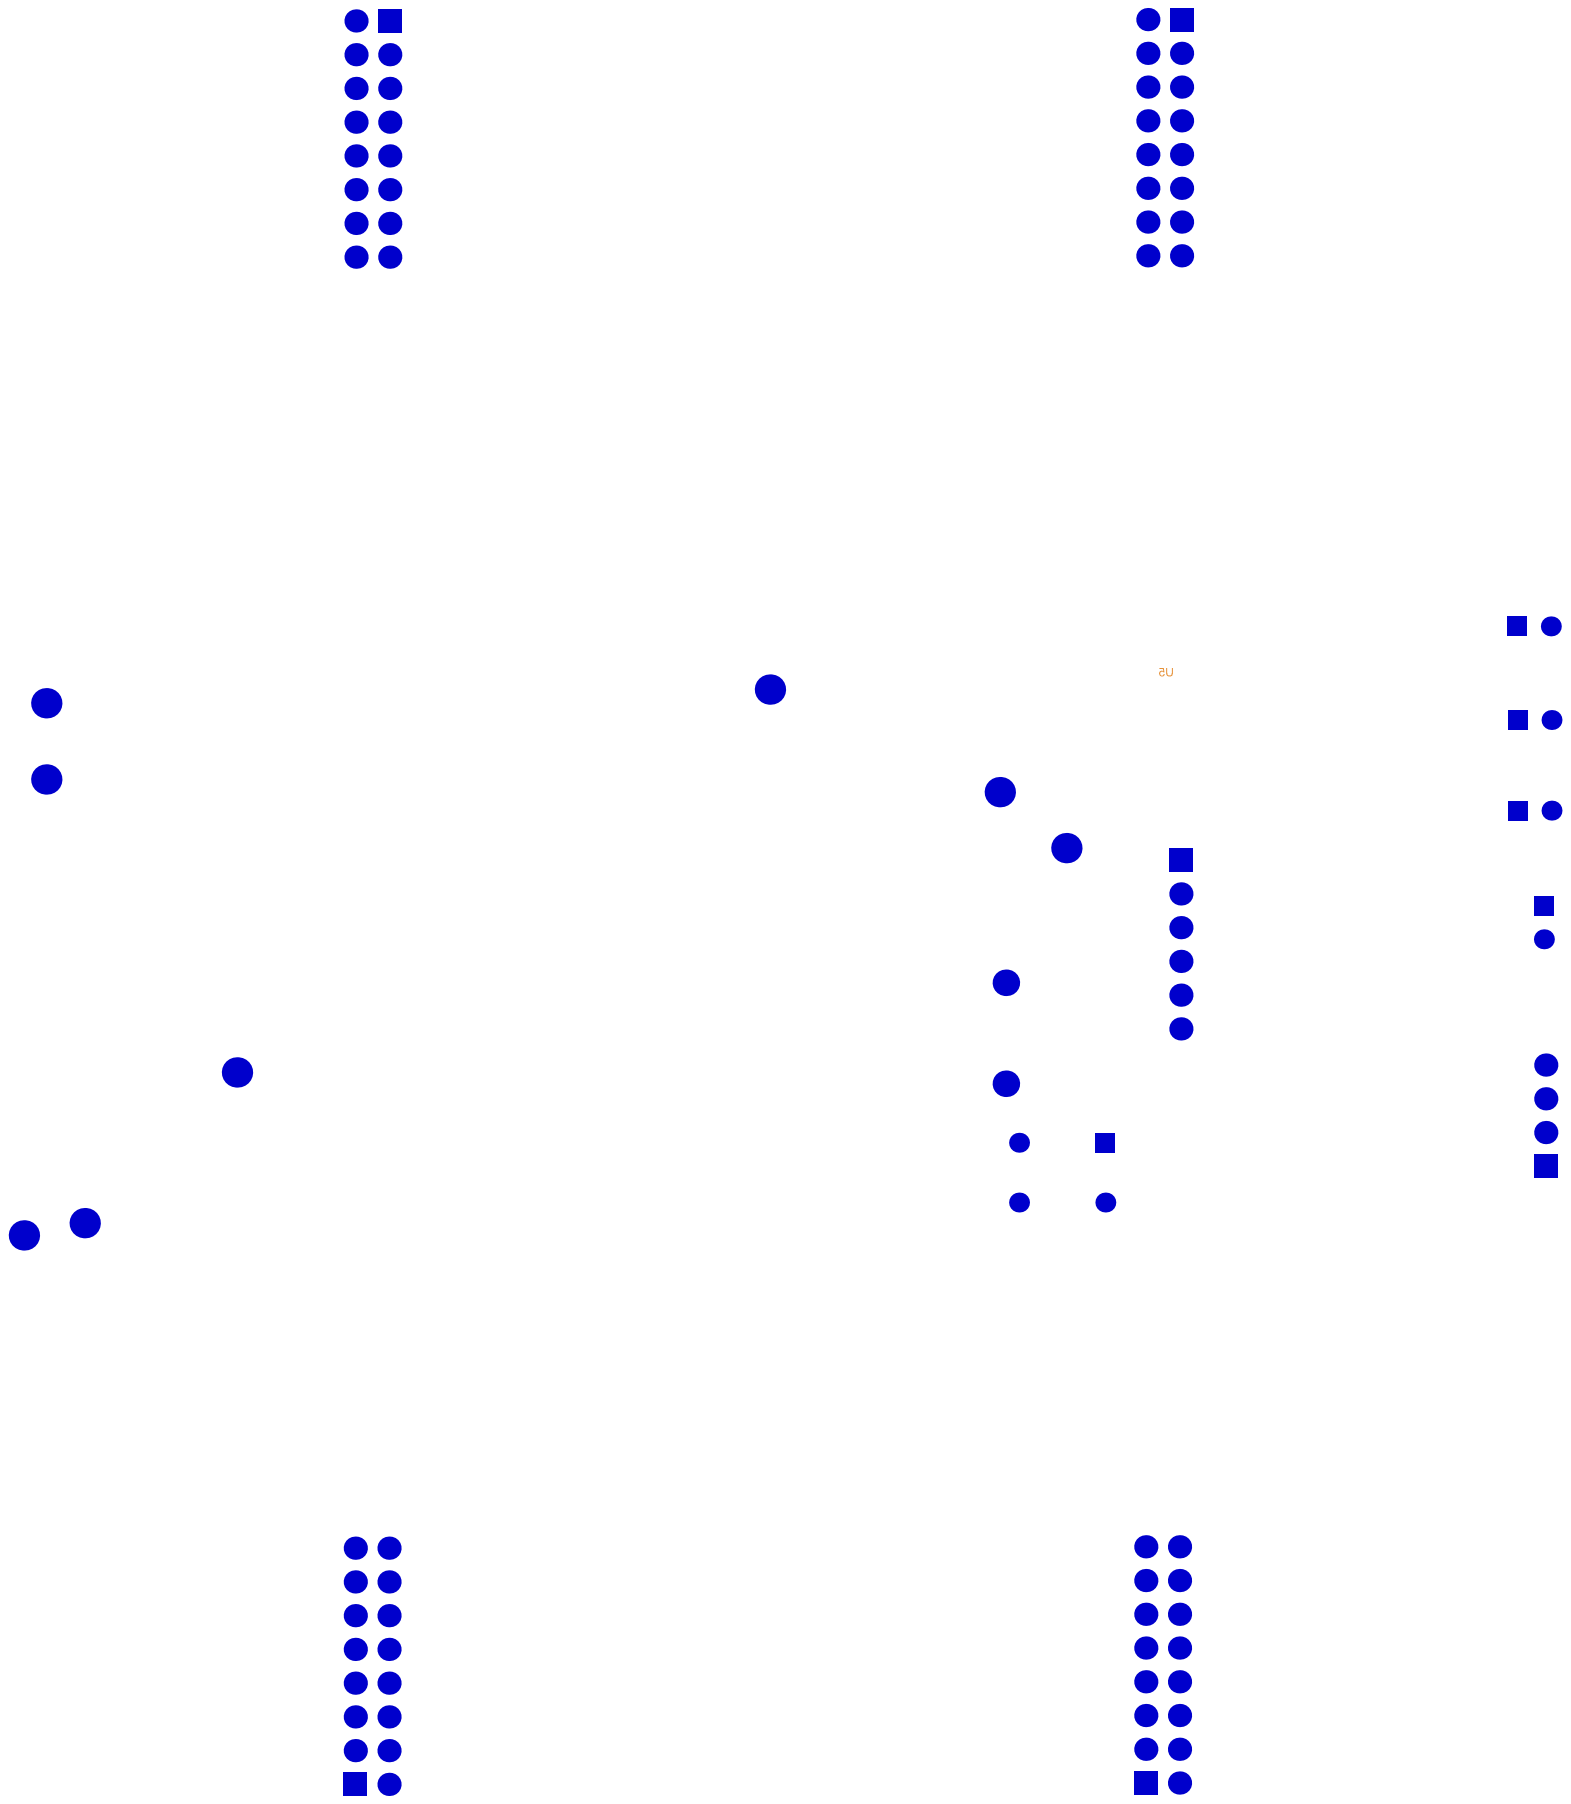
[picture p103: page 2]
