SwissMaverick/PROJ-2008_SablierElectronique/2008_SablierElectronique/hard/2008_SablierElectronique_PCB/Project Outputs for 2008_SablierElectronique/DesignDocs/Schematic Prints.PDF

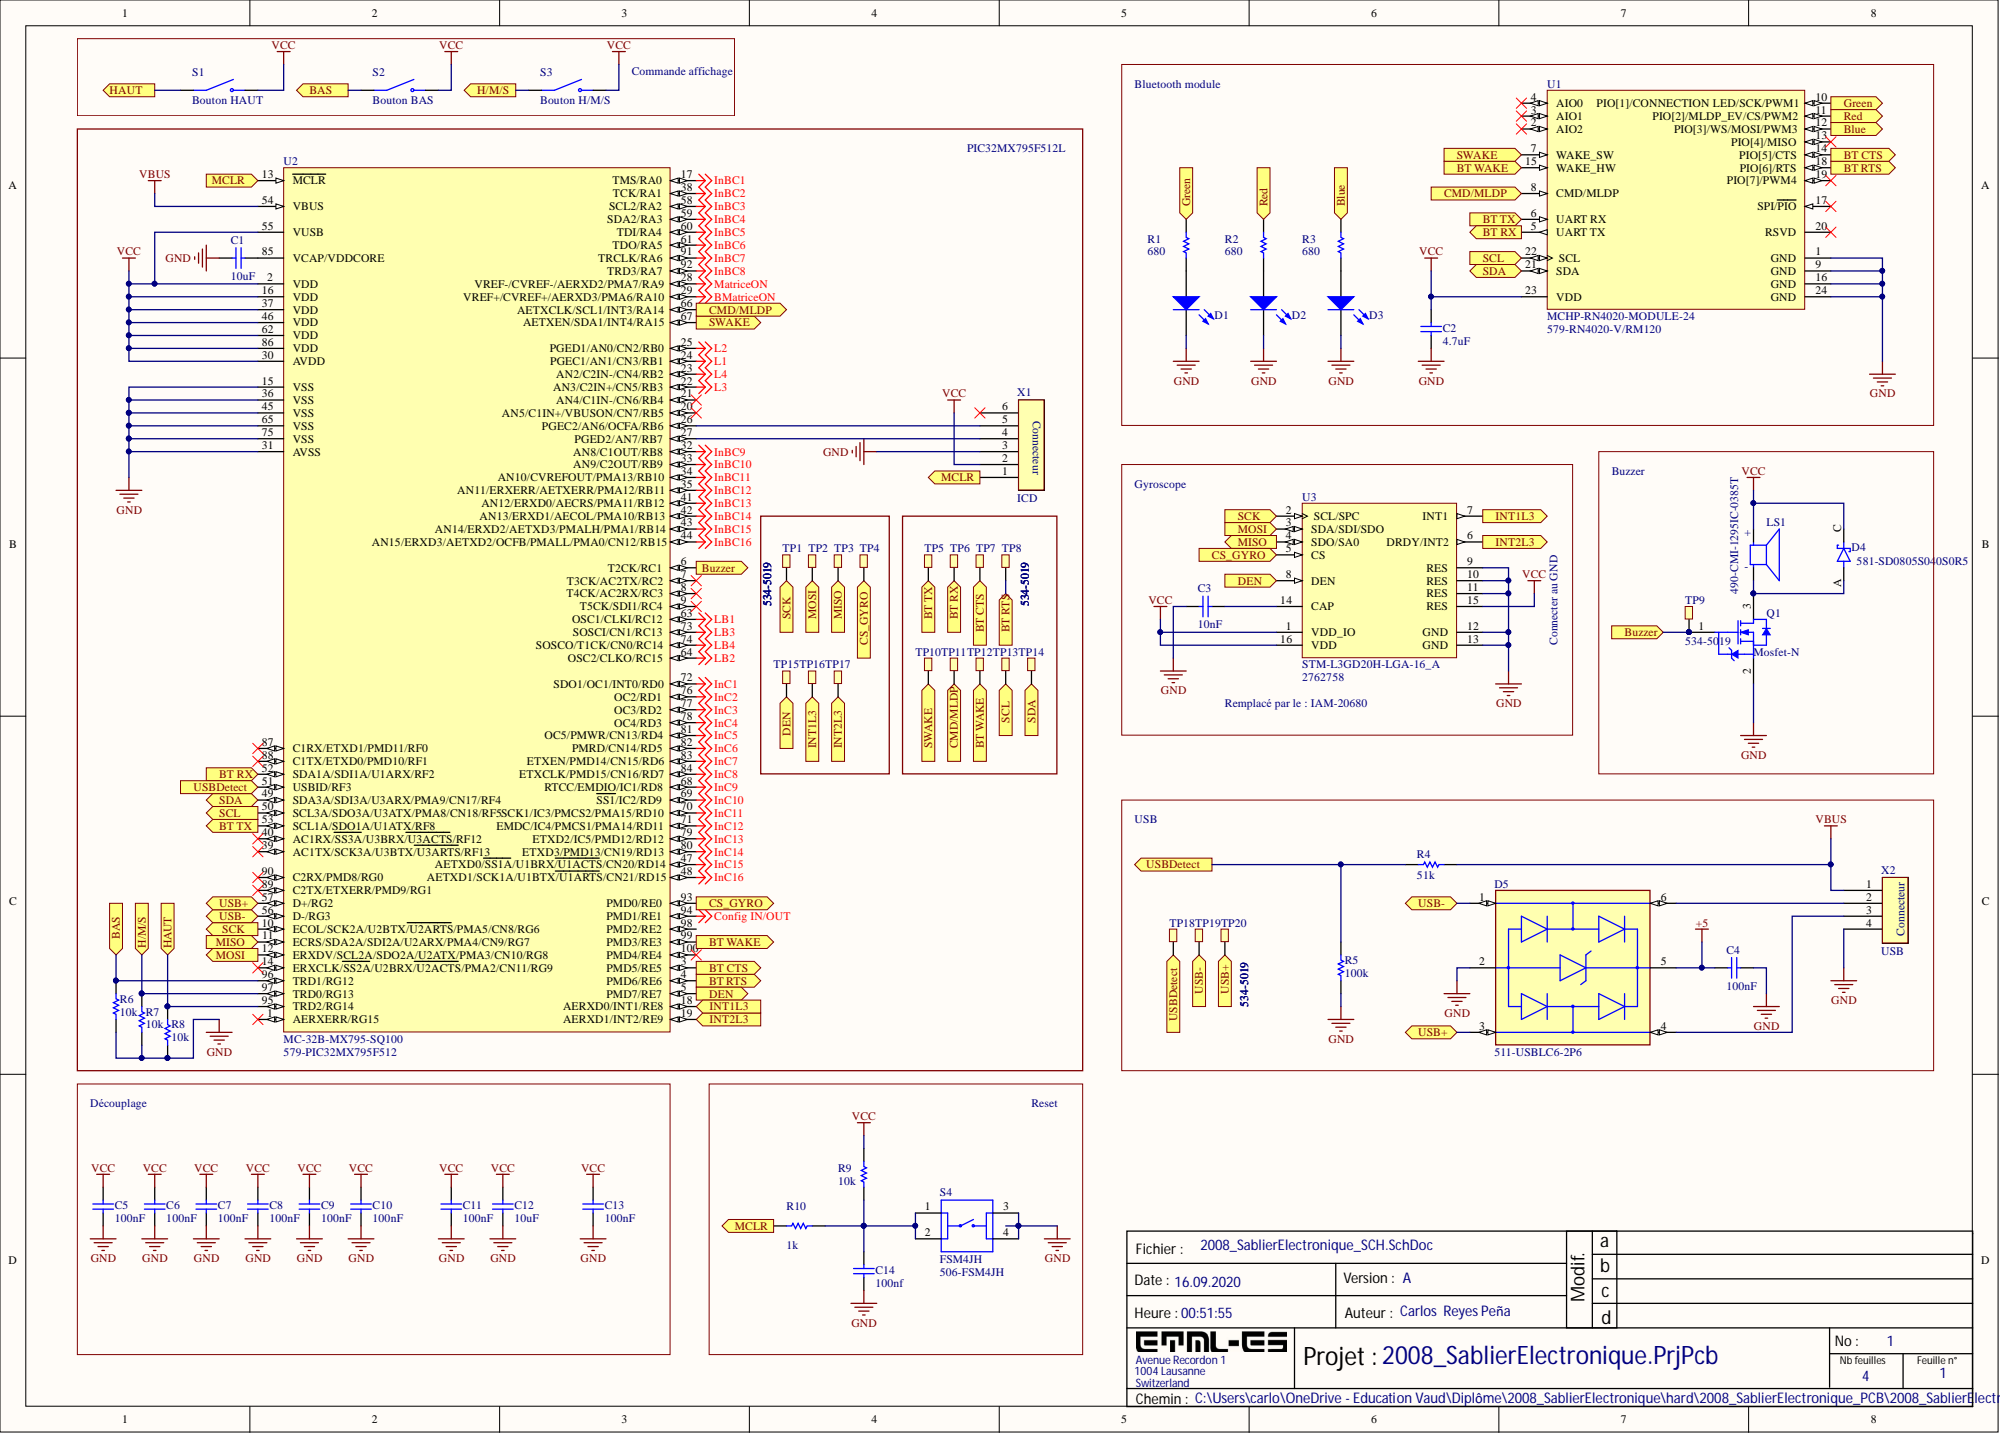
[picture p104: page 1]

VDD 16

VDD 46

VDD 86

Remplacé par le : IAM-20680

ERXCLK/SS2A/U2BRX/U2ACTS/PMA2/CN11/RG9 14

TRD0/RG13 97

Date : 16.09.2020 | Version : A

Heure : 00:51:55 | Carlos Reyes Peña Auteur :
Avenue Recordon 1 1004 Lausanne Switzerland | Projet : 2008_SablierElectronique.PrjPcb | No : 1

Nb feuilles 4 | Feuille n° 1

Chemin : C:\Users\carlo\OneDrive - Education Vaud\Diplôme\2008_SablierElectronique\hard\2008_SablierElectronique_PCB\2008_SablierElectronique_SCH.SchDoc

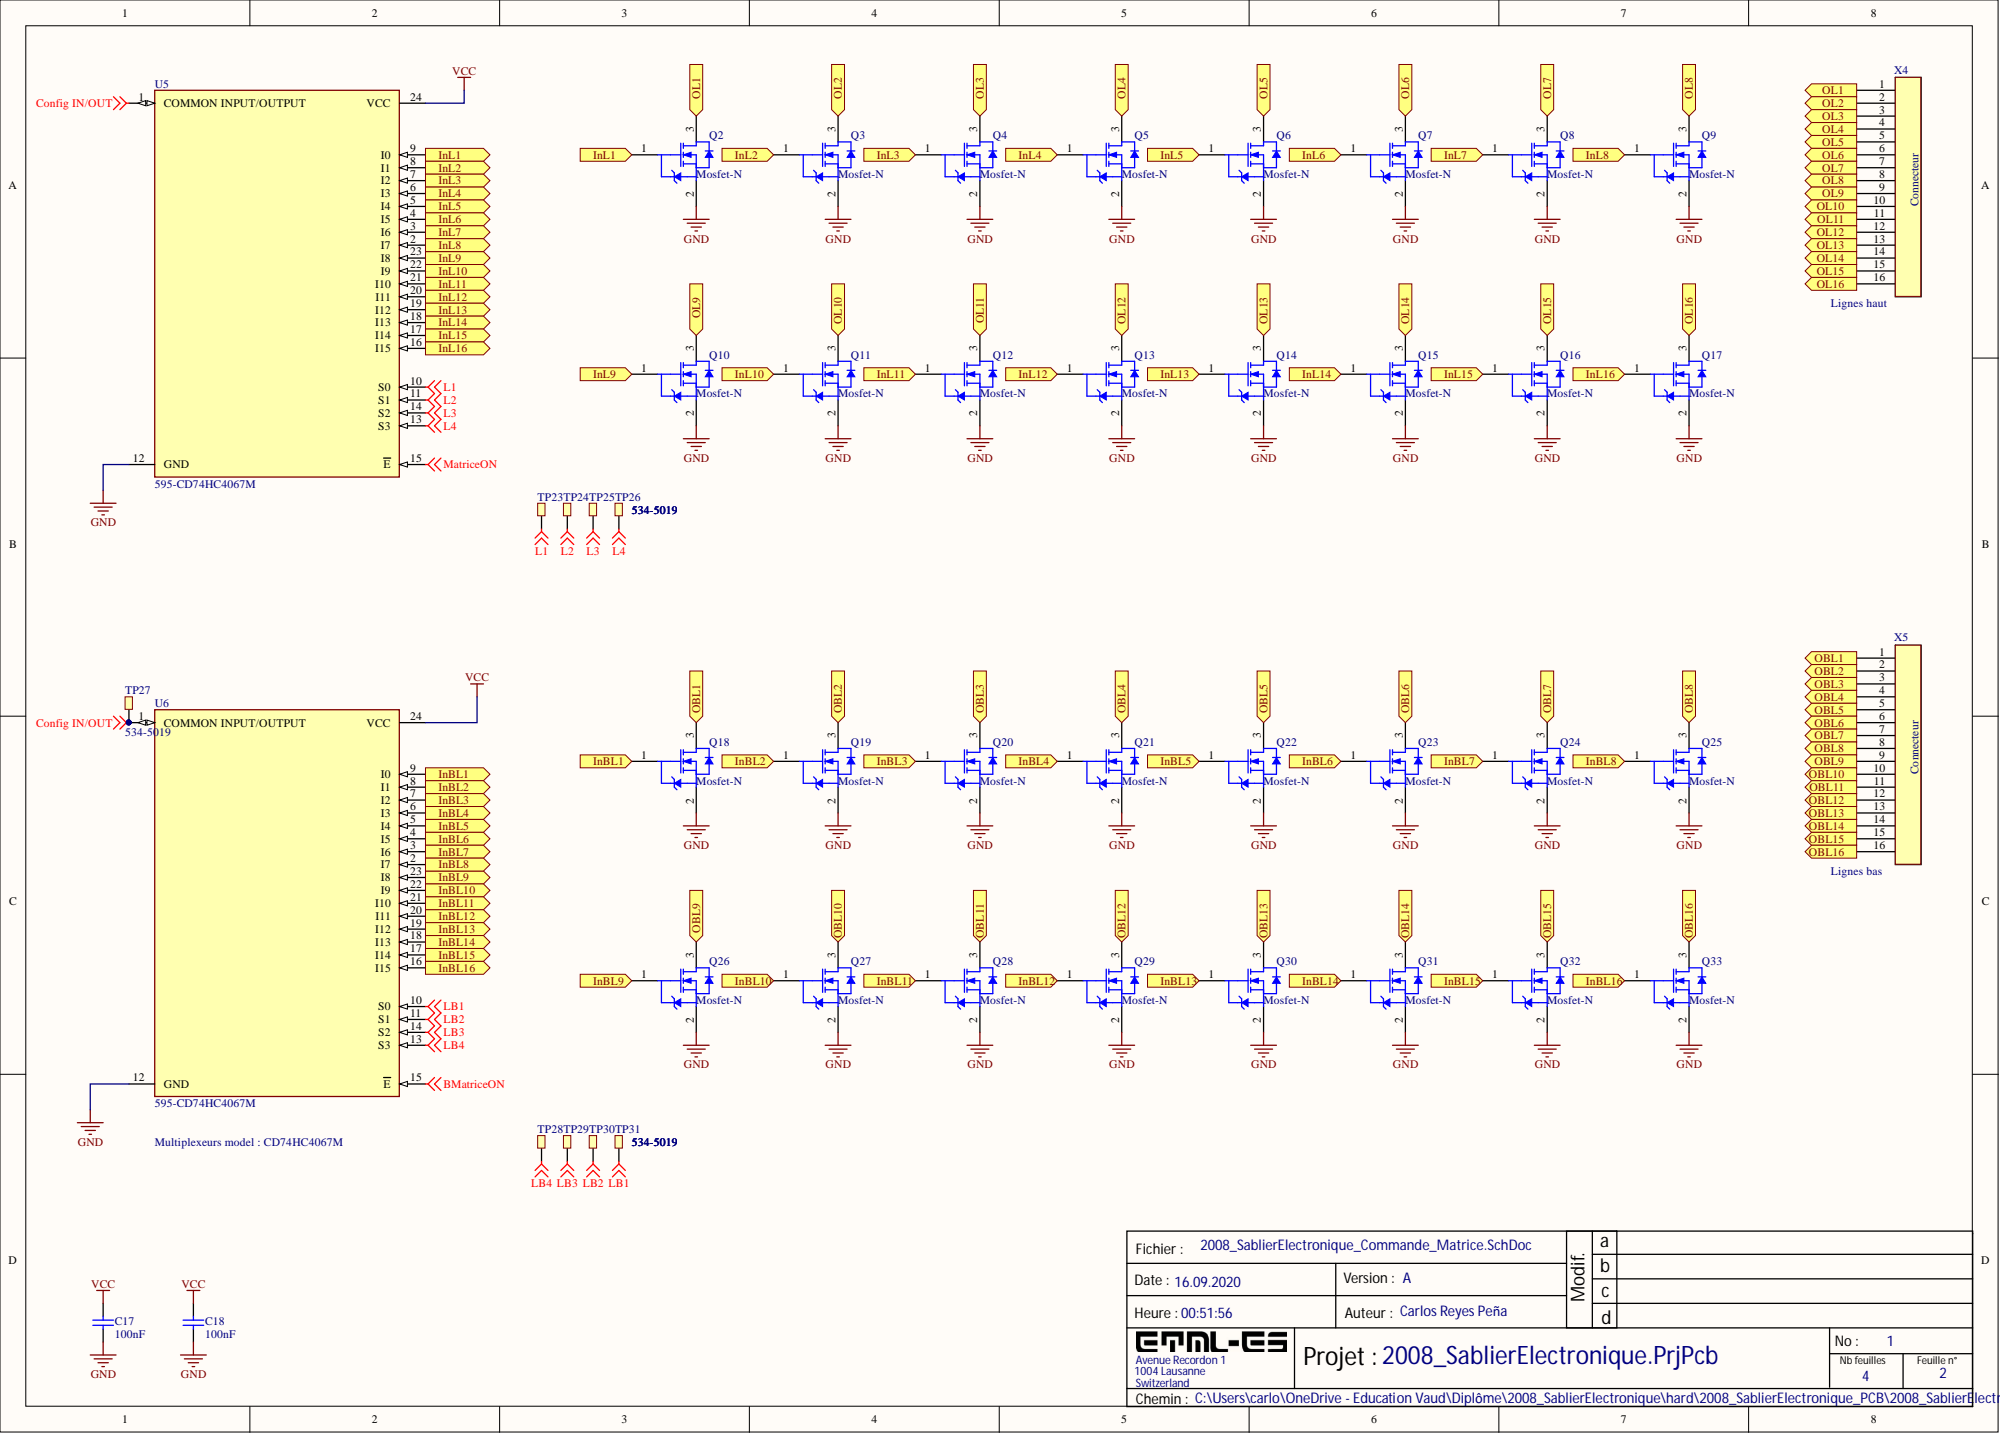
[picture p105: page 2]

2008_SablierElectronique_Commande_Matrice.SchDoc Fichier : | | a

Date : 16.09.2020 | Version : A

Carlos Reyes Peña

Avenue Recordon 1 1004 Lausanne Switzerland | | No : 1

Nb feuilles 4 | Feuille n° 2

Chemin : C:\Users\carlo\OneDrive - Education Vaud\Diplôme\2008_SablierElectronique\hard\2008_SablierElectronique_PCB\2008_SablierElectronique_Commande_Matrice.SchDoc

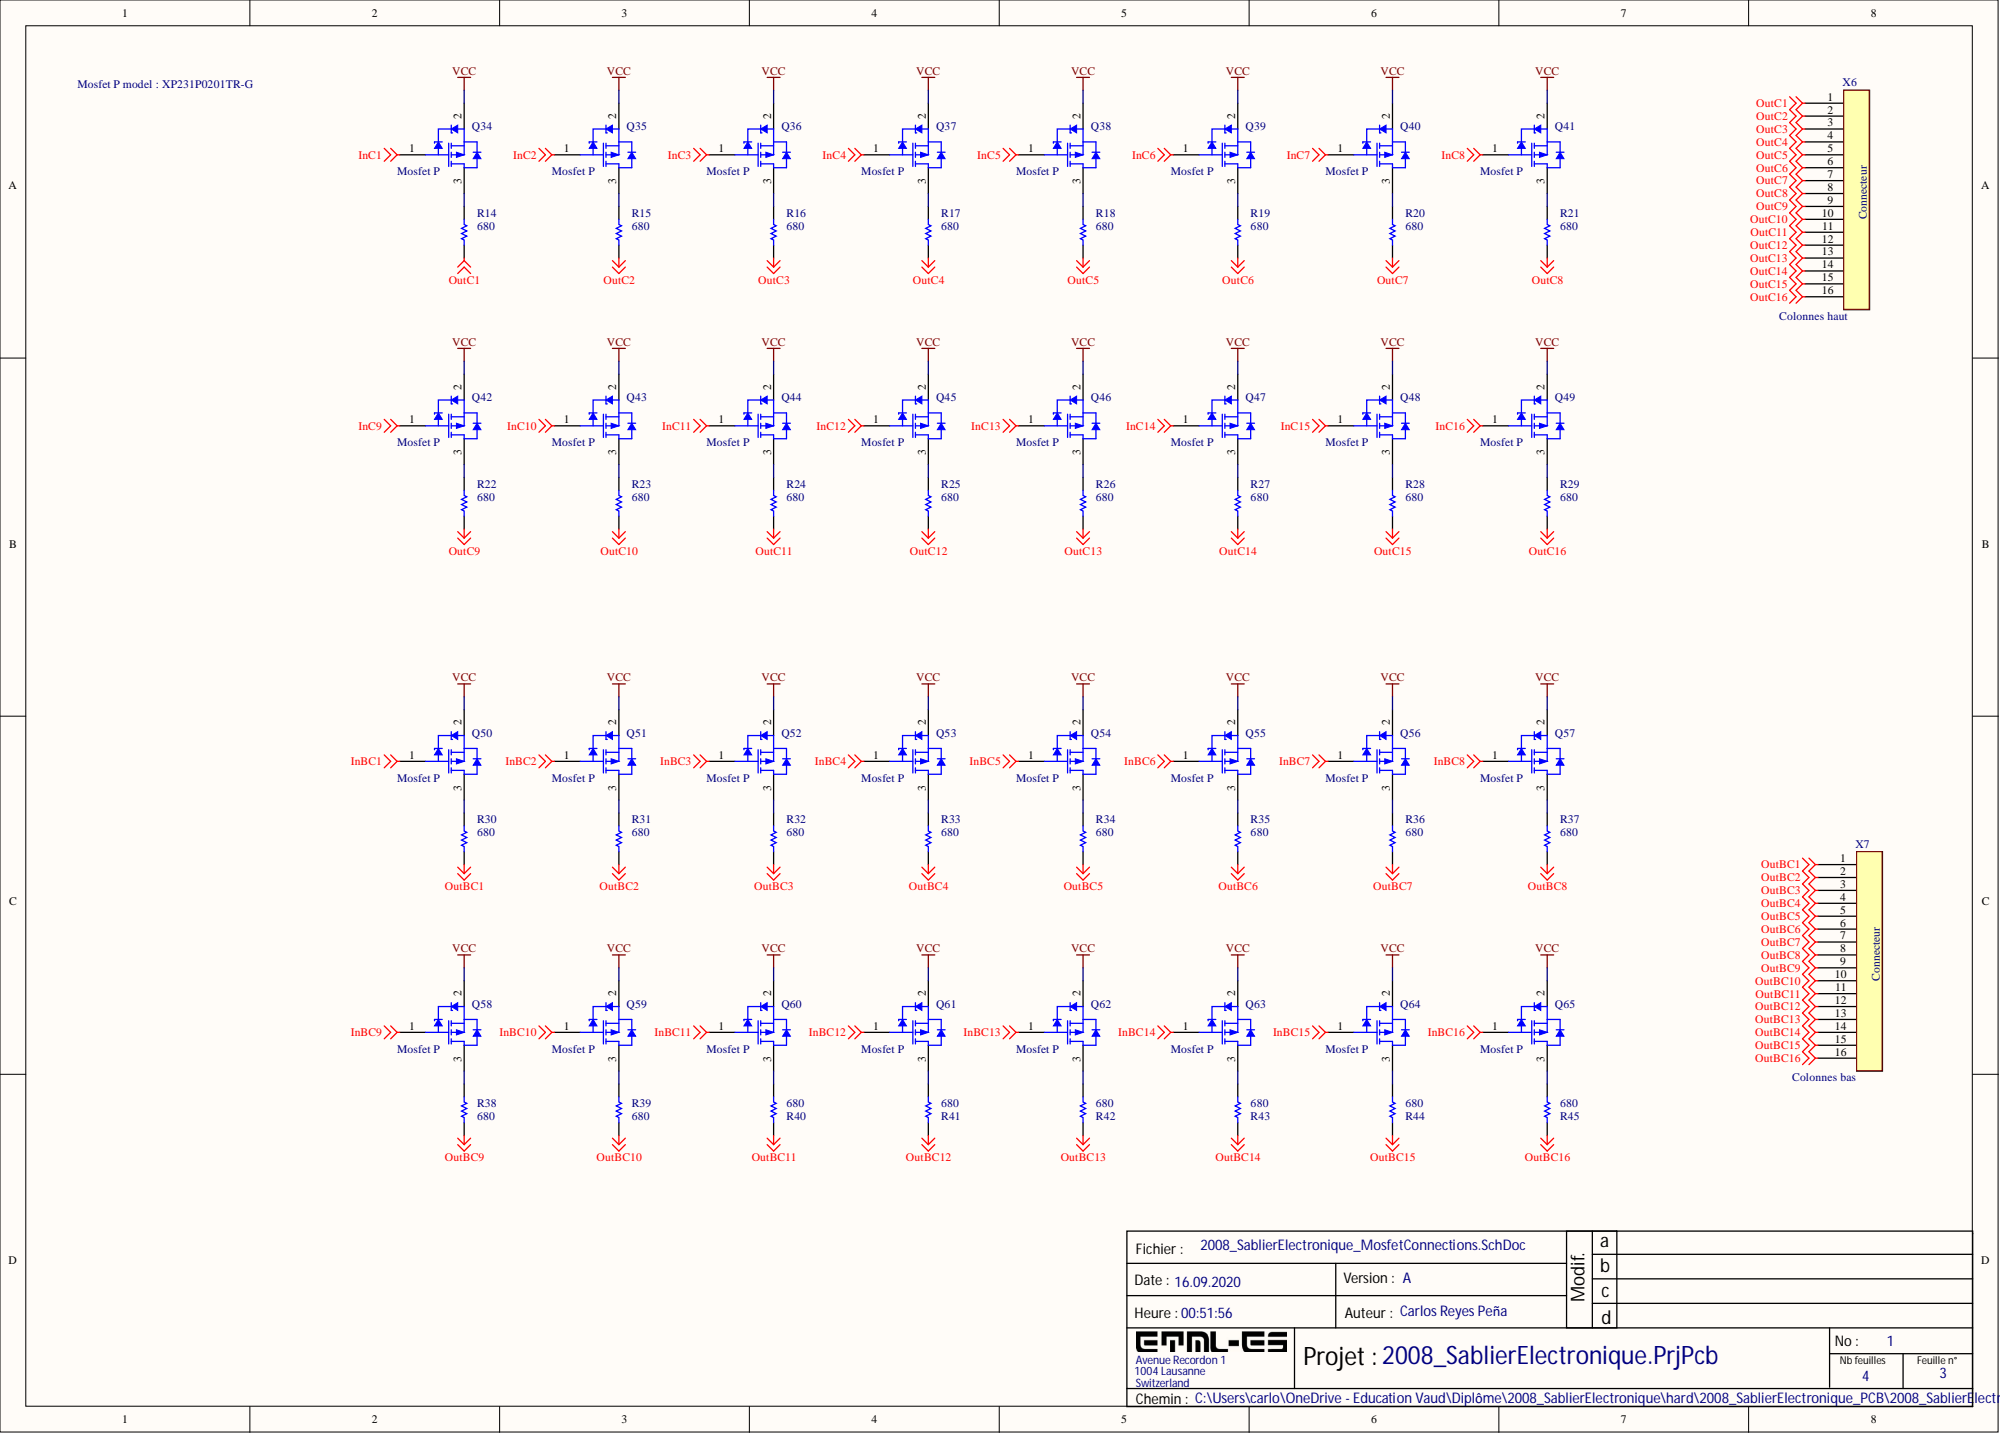
[picture p106: page 3]

2008_SablierElect ronique_MosfetConnections. SchDoc Fichier :

Date : 16.09.2020 | Version : A

Carlos Reyes Pe ñ a

Avenue Re cordon 1 004 Lausanne Switzerland | | No :

Nb feui l l es | Feui l l e n°

Chemin : C:\Users\carlo\OneDrive - Education Vaud\Dipl

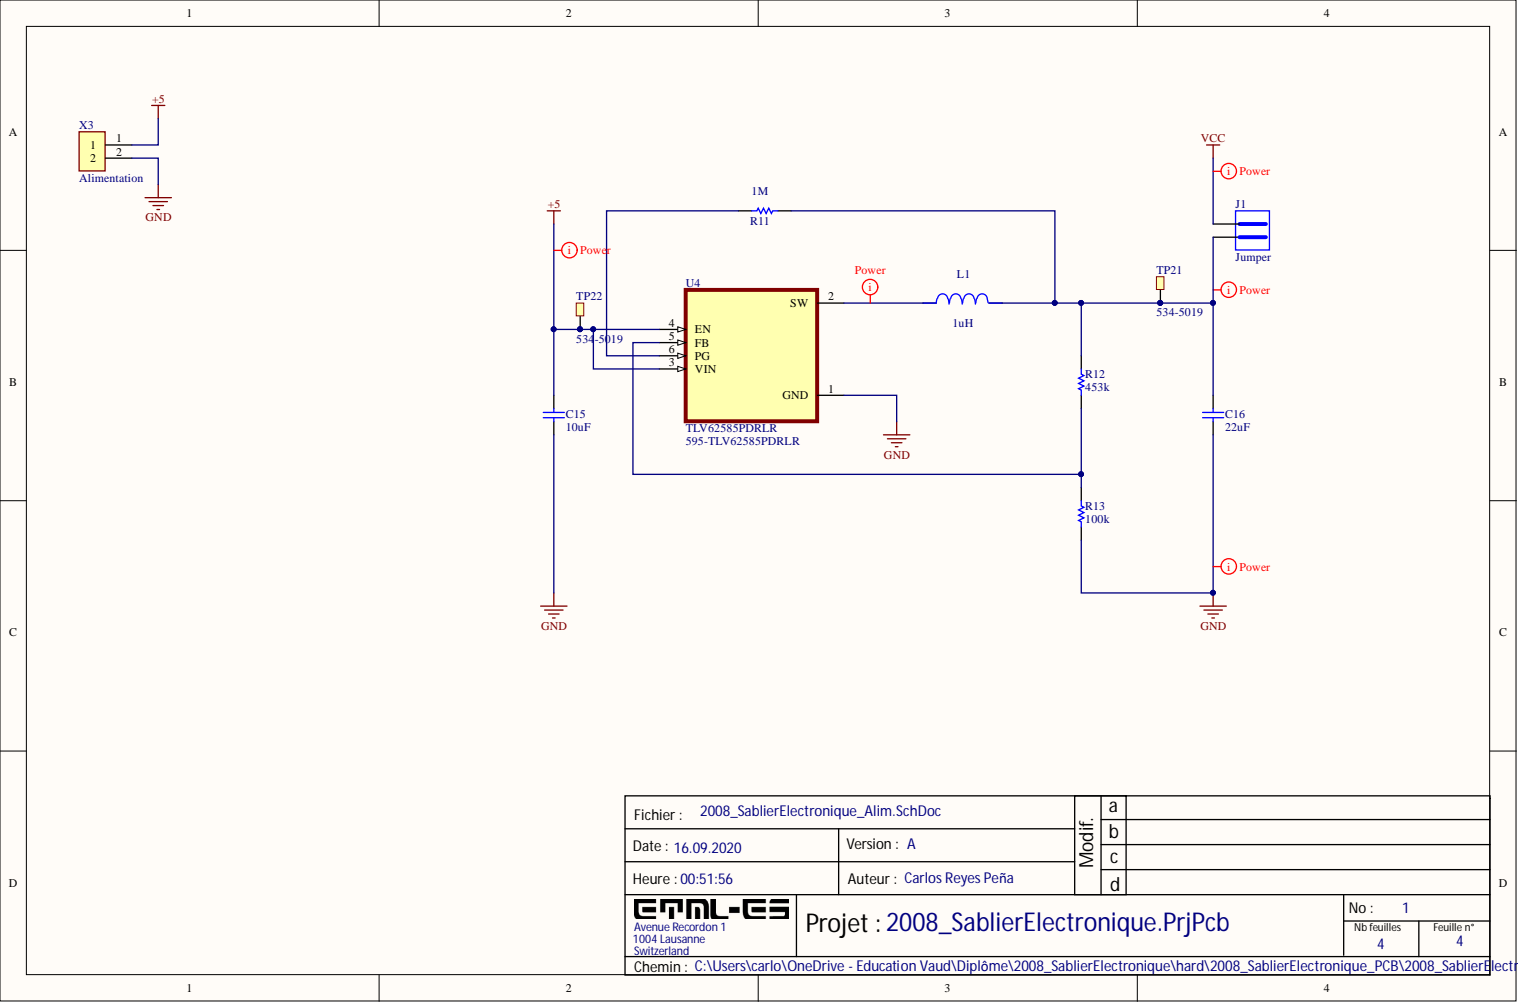
[picture p107: page 4]

E N FB
6 | | G N D | 1 D
3 | VIN

2008_SablierElect ronique_Alim. SchDoc Fichier :

Date : 16.09.2020 | Version : A

Heure : 00:51:56 | Carlos Reyes Pe ñ a Auteur :
Avenue Re cordon 1 004 Lausanne Switzerland | Projet : 2008_SablierElectronique.PrjPcb | No : 1

Nb feuille s | Feuille n°

Chemin : C:\Users\carlo\OneDrive - Education Vaud\Dipl
