SwissMaverick/PROJ-2008_SablierElectronique/2008_SablierElectronique/hard/2008_SablierElectronique_E/Matrice_LEDs/Project Outputs for Matrice_LEDs/Matrice.PDF

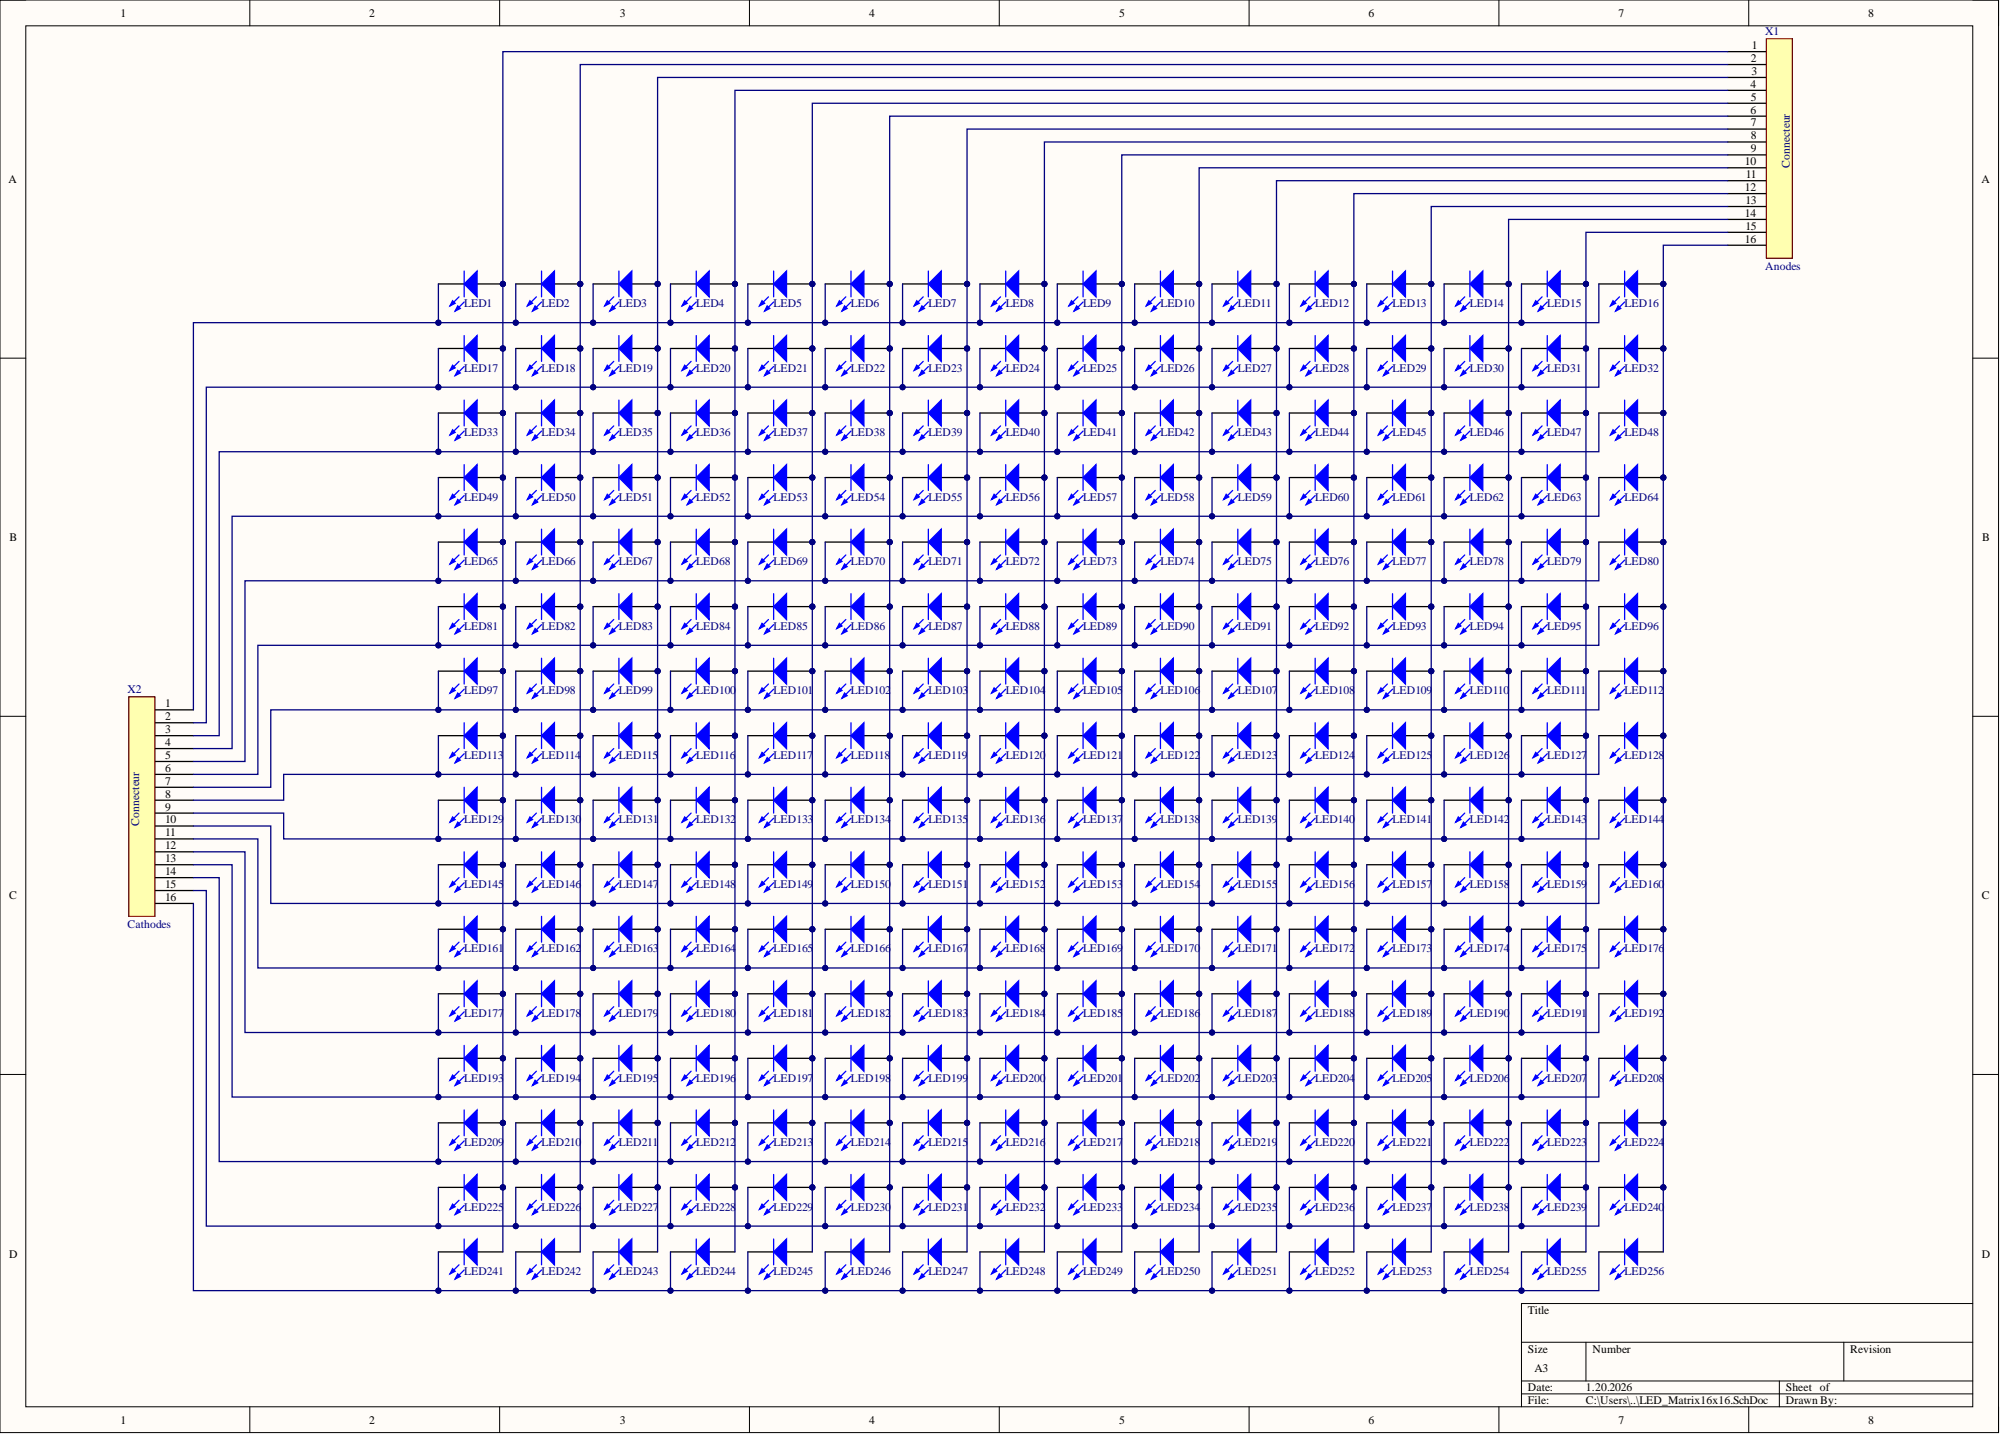
[picture p108: page 1]
