SwissMaverick/PROJ-2008_SablierElectronique/(list of files, drawings)

Other design files:
2008_SablierElectronique/archive/hard/2008_SablierElectronique_PCB/2008_SablierElectronique.PrjPcb
2008_SablierElectronique/archive/hard/2008_SablierElectronique_PCB/2008_SablierElectronique_Alim.SchDoc
2008_SablierElectronique/archive/hard/2008_SablierElectronique_PCB/2008_SablierElectronique_Commande_Matrice.SchDoc
2008_SablierElectronique/archive/hard/2008_SablierElectronique_PCB/2008_SablierElectronique_MosfetConnections.SchDoc
2008_SablierElectronique/archive/hard/2008_SablierElectronique_PCB/2008_SablierElectronique_PCB.PcbDoc
2008_SablierElectronique/archive/hard/2008_SablierElectronique_PCB/2008_SablierElectronique_PCBLIB.PcbLib
2008_SablierElectronique/archive/hard/2008_SablierElectronique_PCB/2008_SablierElectronique_SCH.SchDoc
2008_SablierElectronique/archive/hard/2008_SablierElectronique_PCB/2008_SablierElectronique_SCHLIB.SchLib
2008_SablierElectronique/archive/hard/2008_SablierElectronique_PCB/Alimentation 2V.PcbDoc
2008_SablierElectronique/archive/hard/2008_SablierElectronique_PCB/Alimentation 2V.schdoc
2008_SablierElectronique/archive/hard/2008_SablierElectronique_PCB/LED_Matrix16x16.PcbDoc
2008_SablierElectronique/archive/hard/2008_SablierElectronique_PCB/LED_Matrix16x16.SchDoc
2008_SablierElectronique/archive/hard/2008_SablierElectronique_PCB/Schéma principe MUX LEDS.SchDoc
2008_SablierElectronique/hard/2008_SablierElectronique_E/2008_SablierElectronique/2008_SablierElectronique.PrjPcb
2008_SablierElectronique/hard/2008_SablierElectronique_E/2008_SablierElectronique/2008_SablierElectronique_PCB.PcbDoc
2008_SablierElectronique/hard/2008_SablierElectronique_E/2008_SablierElectronique/Accelerometre.SchDoc
2008_SablierElectronique/hard/2008_SablierElectronique_E/2008_SablierElectronique/Alimentation.SchDoc
2008_SablierElectronique/hard/2008_SablierElectronique_E/2008_SablierElectronique/Drivers_Matrices.SchDoc
2008_SablierElectronique/hard/2008_SablierElectronique_E/2008_SablierElectronique/Microcontroleur.SchDoc
2008_SablierElectronique/hard/2008_SablierElectronique_E/2008_SablierElectronique/Module_Wi-Fi.SchDoc
2008_SablierElectronique/hard/2008_SablierElectronique_E/2008_SablierElectronique/Multiplexage_Matrices.SchDoc
2008_SablierElectronique/hard/2008_SablierElectronique_E/2008_SablierElectronique/PcbLib1.PcbLib
2008_SablierElectronique/hard/2008_SablierElectronique_E/2008_SablierElectronique/Schema_bloc.SchDoc
2008_SablierElectronique/hard/2008_SablierElectronique_E/2008_SablierElectronique/Schlib1.SchLib
2008_SablierElectronique/hard/2008_SablierElectronique_E/Composants Perso/5019/5019.SchLib
2008_SablierElectronique/hard/2008_SablierElectronique_E/Composants Perso/5019/KEYSTONE_5019.PcbLib
2008_SablierElectronique/hard/2008_SablierElectronique_E/Composants Perso/Altium/LIS3DH/LIS3DH.PcbLib
2008_SablierElectronique/hard/2008_SablierElectronique_E/Composants Perso/Altium/LIS3DH/LIS3DH.SchLib
2008_SablierElectronique/hard/2008_SablierElectronique_E/Composants Perso/Altium/PIC32MX795F512H-80VMR.PcbLib
2008_SablierElectronique/hard/2008_SablierElectronique_E/Composants Perso/Altium/PIC32MX795F512H-80VMR.SchLib
2008_SablierElectronique/hard/2008_SablierElectronique_E/Composants Perso/Altium/PIC32MX795F512H-80VPT.PcbLib
2008_SablierElectronique/hard/2008_SablierElectronique_E/Composants Perso/Altium/PIC32MX795F512H-80VPT.SchLib
2008_SablierElectronique/hard/2008_SablierElectronique_E/Composants Perso/Altium/TPS63001DRCR/TPS63001DRCR.PcbLib
2008_SablierElectronique/hard/2008_SablierElectronique_E/Composants Perso/Altium/TPS63001DRCR/TPS63001DRCR.SchLib
2008_SablierElectronique/hard/2008_SablierElectronique_E/Composants Perso/ESP32-C3-WROOM-02-N4/Altium/ESP32-C3-WROOM-02-N4.SchLib
2008_SablierElectronique/hard/2008_SablierElectronique_E/Composants Perso/ESP32-C3-WROOM-02-N4/Altium/ESP32C3WROOM02N4.PcbLib
2008_SablierElectronique/hard/2008_SablierElectronique_E/Composants Perso/PIC32MX795F512H_80V_MR/Altium/PIC32MX795F512H-80VMR.PcbLib
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
