SwissMaverick/PROJ-2008_SablierElectronique/2008_SablierElectronique/soft/eMD-SmartMotion-IAM20680-1.5.0/EMD-App/src/IAM20680/main-raw-ag.c

/*
 * ________________________________________________________________________________________________________
 * Copyright (c) 2017 InvenSense Inc. All rights reserved.
 *
 * This software, related documentation and any modifications thereto (collectively “Software”) is subject
 * to InvenSense and its licensors' intellectual property rights under U.S. and international copyright
 * and other intellectual property rights laws.
 *
 * InvenSense and its licensors retain all intellectual property and proprietary rights in and to the Software
 * and any use, reproduction, disclosure or distribution of the Software without an express license agreement
 * from InvenSense is strictly prohibited.
 *
 * EXCEPT AS OTHERWISE PROVIDED IN A LICENSE AGREEMENT BETWEEN THE PARTIES, THE SOFTWARE IS
 * PROVIDED "AS IS", WITHOUT WARRANTY OF ANY KIND, EXPRESS OR IMPLIED, INCLUDING BUT NOT LIMITED
 * TO THE WARRANTIES OF MERCHANTABILITY, FITNESS FOR A PARTICULAR PURPOSE AND NON-INFRINGEMENT.
 * EXCEPT AS OTHERWISE PROVIDED IN A LICENSE AGREEMENT BETWEEN THE PARTIES, IN NO EVENT SHALL
 * INVENSENSE BE LIABLE FOR ANY DIRECT, SPECIAL, INDIRECT, INCIDENTAL, OR CONSEQUENTIAL DAMAGES, OR ANY
 * DAMAGES WHATSOEVER RESULTING FROM LOSS OF USE, DATA OR PROFITS, WHETHER IN AN ACTION OF CONTRACT,
 * NEGLIGENCE OR OTHER TORTIOUS ACTION, ARISING OUT OF OR IN CONNECTION WITH THE USE OR PERFORMANCE
 * OF THE SOFTWARE.
 * ________________________________________________________________________________________________________
 */
/* Atmel SAMG55 */
#include <asf.h>

/* InvenSense drivers and utils */
#include "Invn/EmbUtils/InvScheduler.h"
#include "Invn/EmbUtils/RingBuffer.h"
#include "Invn/EmbUtils/RingByteBuffer.h"
#include "Invn/EmbUtils/Message.h"
#include "Invn/EmbUtils/ErrorHelper.h"
#include "Invn/Devices/Drivers/Iam20680/Iam20680Product.h"

/* InvenSense config file */
#include "example_config.h"
#include "example-raw-ag.h"

/* System/Board Drivers */
#include "main-raw-ag.h"
#include "system.h"

/* eMD firmware release version */
#include "eMDReleaseVersion.h"

/* Sensor ODR limits */
#define MIN_ODR_US     			1000	/* 1000 Hz */
#define MAX_ODR_US     			250000	/* 4 Hz */

#define MIN_ODR_US_LP_ACC_GYR	2000	/* 500 Hz */
#define MAX_ODR_US_LP_ACC_GYR	250000	/* 4 Hz */
#define MAX_ODR_US_LP_ACC		4166666	/* 0.24 Hz */

/* Sanity checks */
#if ((LOW_NOISE_MODE + LOW_POWER_MODE) != 1)
	#error "You must choose between Low Power and Low Noise mode"
#endif

/* Low power Accel Only Mode */
#if ((LOW_POWER_MODE && ENABLE_ACCEL && !ENABLE_GYRO) && ((ODR_US < MIN_ODR_US_LP_ACC_GYR) || (ODR_US > MAX_ODR_US_LP_ACC)))
	#error "In low power accel odr must be between 2000us and 4166666us (0.24Hz ~ 500Hz)"

/* Other Lower power Modes */
#elif (LOW_POWER_MODE && ENABLE_GYRO && ((ODR_US < MIN_ODR_US_LP_ACC_GYR) || (ODR_US > MAX_ODR_US_LP_ACC_GYR)))
	#error "In low power odr must be between 2000us and 250000us (4Hz ~ 500Hz)"

/* Low Noise Mode */
#elif (LOW_NOISE_MODE && ((ODR_US < MIN_ODR_US) || (ODR_US > MAX_ODR_US)))
	#error "In low noise mode odr must be between 1000us and 250000us (4Hz ~ 1KHz)"
#endif

#if (SERIF_TYPE_SPI && SERIF_TYPE_I2C) || (!SERIF_TYPE_SPI && !SERIF_TYPE_I2C)
	#error "You must choose between I2C or SPI for iam20680 device control"
#endif

#if ( IAM20680 == 1)
uint8_t display_banner[] = "     IAM20680 Raw AG example       " ;
#elif (IAM20680_HP == 1)
uint8_t display_banner[] = "     IAM20680HP Raw AG example     " ;
#elif (IAM20680_HT == 1)
uint8_t display_banner[] = "     IAM20680HT Raw AG example     " ;
#endif

/* extern and global variables */
volatile int				irq_from_device = 0;
extern volatile uint32_t	timer_ticks;
extern InvScheduler 		scheduler;
extern InvSchedulerTask		blinkerLedTask;
extern uint8_t				I2C_Address;

/* usart Tx DMA variables */
extern uint8_t g_uc_pdc_buffer[BUFFER_SIZE];
extern pdc_packet_t g_pdc_usart_packet;
extern Pdc *g_p_usart_pdc;

int main (void) {
	
	int rc = 0;
	inv_bool_t isSPI = SERIF_TYPE_SPI;
	
	/* Hardware Initialization */
	sysclk_init();
	board_init();  

	/* Configure Timer - 10us resolution */
	SysTick_Config(sysclk_get_cpu_hz() / (1000000 / SYSTICK_TIMER_PERIOD_US) );

	/* Initialize serial interface */
	configure_console();


	/* Setup message facility to see internal traces from FW */
	INV_MSG_SETUP(INV_MSG_ENABLE, msg_printer);
	
	INV_MSG(INV_MSG_LEVEL_INFO, "###################################");
	INV_MSG(INV_MSG_LEVEL_INFO, "%s",display_banner);
	INV_MSG(INV_MSG_LEVEL_INFO, "     Ver: %s", EMD_RELEASE_VERSION_STRING);
	INV_MSG(INV_MSG_LEVEL_INFO, "###################################");
	
	/* Initialize External Sensor Interrupt */
	external_interrupt_initialize(&inv_external_interrupt_handler);

	/* Initialize SPI/I2C Interface */ 
	interface_initialize();	
	
	rc = SetupInvDevice(idd_io_hal_read_reg, idd_io_hal_write_reg, isSPI);
	check_rc(rc, "error while setting up device");

	/* Configure Device */
	inv_dev_config_t dev_config;
	dev_config.enable_accel = (uint8_t)ENABLE_ACCEL;
	dev_config.enable_gyro = (uint8_t)ENABLE_GYRO;
	dev_config.set_low_noise_mode = (uint8_t)LOW_NOISE_MODE;
	dev_config.acc_fsr_g = FSR_ACC_G;
	dev_config.gyr_fsr_dps = FSR_GYR_DPS;
	dev_config.odr_us = ODR_US;

	rc = ConfigureInvDevice(&dev_config);
	check_rc(rc, "error while configuring device");

    /* Clear timer-stamp and any remaining interrupts */
    if (rc == 0) {
		__disable_irq();
		timer_clear_irq_timestamp();
		clear_irq();
	    irq_from_device = 0;
	    __enable_irq();
    }

	InvScheduler_init(&scheduler);
	InvScheduler_initTask(&scheduler, &blinkerLedTask, "blinkerLedTask", inv_blinkerLedTask_handler, 0, INVSCHEDULER_TASK_PRIO_MIN+1, 1000000/SYSTICK_TIMER_PERIOD_US);
	InvScheduler_startTask(&blinkerLedTask, 0);

	while (1) {
		
		InvScheduler_dispatchTasks(&scheduler);
		
		if (irq_from_device == 1) {
						
			rc = GetDataFromFIFO(&dev_config);

			if(rc == INV_ERROR_FIFO_OVERFLOW) {
				__disable_irq();
				rc += timer_clear_irq_timestamp();
				__enable_irq();
			} else if(rc != INV_ERROR_SUCCESS) {
				check_rc(rc, "error while processing FIFO");
			}
			
			__disable_irq();
			irq_from_device = 0;
			__enable_irq();
		}
	}

	return 0;
}

static int idd_io_hal_read_reg(void * context, uint8_t reg, uint8_t * rbuffer, uint32_t rlen) {
	(void)context;
	
#if (SERIF_TYPE_SPI == 1)
	return spi_master_read_register(NULL, reg, rbuffer, rlen);
#elif (SERIF_TYPE_I2C == 1)
	return i2c_master_read_register(I2C_Address, reg, rlen, rbuffer);
#endif
}

static int idd_io_hal_write_reg(void * context, uint8_t reg, const uint8_t * wbuffer, uint32_t wlen) {
	(void)context;
	
#if (SERIF_TYPE_SPI == 1)
	return spi_master_write_register(NULL, reg, wbuffer, wlen);
#elif (SERIF_TYPE_I2C == 1)
	return i2c_master_write_register(I2C_Address, reg, wlen, wbuffer);
#endif
}

static void interface_initialize(void) {
	
#if (SERIF_TYPE_SPI == 1)
	
	spi_master_initialize();
	
#elif (SERIF_TYPE_I2C == 1)
	/* 	 
	 * Default IAM20680 (Slave) Address = 0x68 (pin AD0 is logic low)
	 * Change Slave Address to 0x69 (pin AD0 is logic high) 
	 */
#if ((TDK_BOARD_INBUILT_SENSOR == 1) && (TDK_BOARD_REVISION == 1))
	I2C_Address = IAM_I2C_ADDR_AD0_HIGH;
#endif

	i2c_master_initialize();
#endif
}

/*!
* @brief	Sensor general interrupt handler, calls specific handlers.
*
* This function is called when an external interrupt is triggered by the sensor,
* checks interrupt registers of InvenSense Sensor to determine the source and type of interrupt
* and calls the specific interrupt handler accordingly.
*
* @param[in]	NULL
*
* @param[out]	NULL
*
* @return		NULL
*
*/
static void inv_external_interrupt_handler(void) {
	
	irq_from_device = 1;
	
	/* Push timestamp to ring-buffer */
	timer_create_ringbuffer_timestamp(timer_ticks);	
}

/*
 * BlinkerLedTaskMain - Task that blinks the LED.
 */
static void inv_blinkerLedTask_handler(void * arg) {
	
	(void)arg;

	/* System heartbeat - toggle the LED */
	ioport_toggle_pin_level(LED_0_PIN);	
}

/* Helper function to check RC value and block program execution */
static void check_rc(int rc, const char * msg_context) {
	
	if(rc < 0) {
		INV_MSG(INV_MSG_LEVEL_ERROR, "%s: error %d (%s)", msg_context, rc, inv_error_str(rc));
		while(1);
	}
}

/*
 * Printer function for message facility
 */
static void msg_printer(int level, const char * str, va_list ap) {
#ifdef INV_MSG_ENABLE
	static char out_str[BUFFER_SIZE]; /* static to limit stack usage */
	unsigned idx = 0;
#if (USART_TX_DMA_XFER_EN == 1)
	unsigned cnt = 0;
#endif
	const char * ptr = out_str;
	const char * s[INV_MSG_LEVEL_MAX] = {
		"",    // INV_MSG_LEVEL_OFF
		"[E] ", // INV_MSG_LEVEL_ERROR
		"[W] ", // INV_MSG_LEVEL_WARNING
		"[I] ", // INV_MSG_LEVEL_INFO
		"[V] ", // INV_MSG_LEVEL_VERBOSE
		"[D] ", // INV_MSG_LEVEL_DEBUG
	};
	idx += snprintf(&out_str[idx], sizeof(out_str) - idx, "%s", s[level]);
	if(idx >= (sizeof(out_str)))
		return;
	idx += vsnprintf(&out_str[idx], sizeof(out_str) - idx, str, ap);
	if(idx >= (sizeof(out_str)))
		return;
	idx += snprintf(&out_str[idx], sizeof(out_str) - idx, "\r\n");
	if(idx >= (sizeof(out_str)))
		return;

#if (USART_TX_DMA_XFER_EN == 0)
	while(*ptr != '\0') {
		usart_serial_putchar(CONF_UART_DBG, *ptr);
		++ptr;
	}
#else
	while(*ptr != '\0') {
		g_uc_pdc_buffer[cnt] = *ptr;
		++ptr;
		++cnt;
	}
	g_pdc_usart_packet.ul_size = idx;
	pdc_tx_init(g_p_usart_pdc, &g_pdc_usart_packet, NULL);
#endif

#else
	(void)level, (void)str, (void)ap;
#endif
}

/* Sleep implementation for IAM20680 */
void inv_iam20680_sleep_us(int us) {
	
	delay_us(us);
}

/* Sleep implementation for IAM20680 */
void inv_iam20680_sleep_ms(int ms) {
	
	delay_us(ms);
}
