SwissMaverick/PROJ-2008_SablierElectronique/2008_SablierElectronique/soft/2008D_Sablier_electronique/firmware/src/system_config/default/system_config.h

/*******************************************************************************
  MPLAB Harmony System Configuration Header

  File Name:
    system_config.h

  Summary:
    Build-time configuration header for the system defined by this MPLAB Harmony
    project.

  Description:
    An MPLAB Project may have multiple configurations.  This file defines the
    build-time options for a single configuration.

  Remarks:
    This configuration header must not define any prototypes or data
    definitions (or include any files that do).  It only provides macro
    definitions for build-time configuration options that are not instantiated
    until used by another MPLAB Harmony module or application.

    Created with MPLAB Harmony Version 2.06
*******************************************************************************/

// DOM-IGNORE-BEGIN
/*******************************************************************************
Copyright (c) 2013-2015 released Microchip Technology Inc.  All rights reserved.

Microchip licenses to you the right to use, modify, copy and distribute
Software only when embedded on a Microchip microcontroller or digital signal
controller that is integrated into your product or third party product
(pursuant to the sublicense terms in the accompanying license agreement).

You should refer to the license agreement accompanying this Software for
additional information regarding your rights and obligations.

SOFTWARE AND DOCUMENTATION ARE PROVIDED AS IS WITHOUT WARRANTY OF ANY KIND,
EITHER EXPRESS OR IMPLIED, INCLUDING WITHOUT LIMITATION, ANY WARRANTY OF
MERCHANTABILITY, TITLE, NON-INFRINGEMENT AND FITNESS FOR A PARTICULAR PURPOSE.
IN NO EVENT SHALL MICROCHIP OR ITS LICENSORS BE LIABLE OR OBLIGATED UNDER
CONTRACT, NEGLIGENCE, STRICT LIABILITY, CONTRIBUTION, BREACH OF WARRANTY, OR
OTHER LEGAL EQUITABLE THEORY ANY DIRECT OR INDIRECT DAMAGES OR EXPENSES
INCLUDING BUT NOT LIMITED TO ANY INCIDENTAL, SPECIAL, INDIRECT, PUNITIVE OR
CONSEQUENTIAL DAMAGES, LOST PROFITS OR LOST DATA, COST OF PROCUREMENT OF
SUBSTITUTE GOODS, TECHNOLOGY, SERVICES, OR ANY CLAIMS BY THIRD PARTIES
(INCLUDING BUT NOT LIMITED TO ANY DEFENSE THEREOF), OR OTHER SIMILAR COSTS.
*******************************************************************************/
// DOM-IGNORE-END

#ifndef _SYSTEM_CONFIG_H
#define _SYSTEM_CONFIG_H

// *****************************************************************************
// *****************************************************************************
// Section: Included Files
// *****************************************************************************
// *****************************************************************************
/*  This section Includes other configuration headers necessary to completely
    define this configuration.
*/


// DOM-IGNORE-BEGIN
#ifdef __cplusplus  // Provide C++ Compatibility

extern "C" {

#endif
// DOM-IGNORE-END

// *****************************************************************************
// *****************************************************************************
// Section: System Service Configuration
// *****************************************************************************
// *****************************************************************************
// *****************************************************************************
/* Common System Service Configuration Options
*/
#define SYS_VERSION_STR           "2.06"
#define SYS_VERSION               20600

// *****************************************************************************
/* Clock System Service Configuration Options
*/
#define SYS_CLK_FREQ                        80000000ul
#define SYS_CLK_BUS_PERIPHERAL_1            80000000ul
#define SYS_CLK_UPLL_BEFORE_DIV2_FREQ       48000000ul
#define SYS_CLK_CONFIG_PRIMARY_XTAL         0ul
#define SYS_CLK_CONFIG_SECONDARY_XTAL       32768ul
   
/*** Ports System Service Configuration ***/
#define SYS_PORT_AD1PCFG        ~0x3
#define SYS_PORT_CNPUE          0x0
#define SYS_PORT_CNEN           0x0
#define SYS_PORT_B_TRIS         0x0003
#define SYS_PORT_B_LAT          0x0000
#define SYS_PORT_B_ODC          0x0000

#define SYS_PORT_C_TRIS         0x7FFF
#define SYS_PORT_C_LAT          0x0000
#define SYS_PORT_C_ODC          0x0000

#define SYS_PORT_D_TRIS         0xFE06
#define SYS_PORT_D_LAT          0x0000
#define SYS_PORT_D_ODC          0x0000

#define SYS_PORT_E_TRIS         0xFFC0
#define SYS_PORT_E_LAT          0x0000
#define SYS_PORT_E_ODC          0x0000

#define SYS_PORT_F_TRIS         0xFFFC
#define SYS_PORT_F_LAT          0x0000
#define SYS_PORT_F_ODC          0x0000

#define SYS_PORT_G_TRIS         0xFE3F
#define SYS_PORT_G_LAT          0x0000
#define SYS_PORT_G_ODC          0x0000


/*** Interrupt System Service Configuration ***/
#define SYS_INT                     true

// *****************************************************************************
// *****************************************************************************
// Section: Driver Configuration
// *****************************************************************************
// *****************************************************************************
#define DRV_OC_DRIVER_MODE_STATIC 

/*** SPI Driver Configuration ***/
#define DRV_SPI_NUMBER_OF_MODULES		3
/*** Driver Compilation and static configuration options. ***/
/*** Select SPI compilation units.***/
#define DRV_SPI_POLLED 				1
#define DRV_SPI_ISR 				1
#define DRV_SPI_MASTER 				1
#define DRV_SPI_SLAVE 				0
#define DRV_SPI_RM 					0
#define DRV_SPI_EBM 				1
#define DRV_SPI_8BIT 				1
#define DRV_SPI_16BIT 				0
#define DRV_SPI_32BIT 				0
#define DRV_SPI_DMA 				0

/*** SPI Driver Static Allocation Options ***/
#define DRV_SPI_INSTANCES_NUMBER 		1
#define DRV_SPI_CLIENTS_NUMBER 			1
#define DRV_SPI_ELEMENTS_PER_QUEUE 		10
/*** Timer Driver Configuration ***/
#define DRV_TMR_INTERRUPT_MODE             true

/*** Timer Driver 0 Configuration ***/
#define DRV_TMR_PERIPHERAL_ID_IDX0          TMR_ID_1
#define DRV_TMR_INTERRUPT_SOURCE_IDX0       INT_SOURCE_TIMER_1
#define DRV_TMR_INTERRUPT_VECTOR_IDX0       INT_VECTOR_T1
#define DRV_TMR_ISR_VECTOR_IDX0             _TIMER_1_VECTOR
#define DRV_TMR_INTERRUPT_PRIORITY_IDX0     INT_PRIORITY_LEVEL3
#define DRV_TMR_INTERRUPT_SUB_PRIORITY_IDX0 INT_SUBPRIORITY_LEVEL0
#define DRV_TMR_CLOCK_SOURCE_IDX0           DRV_TMR_CLKSOURCE_INTERNAL
#define DRV_TMR_PRESCALE_IDX0               TMR_PRESCALE_VALUE_8
#define DRV_TMR_OPERATION_MODE_IDX0         DRV_TMR_OPERATION_MODE_16_BIT
#define DRV_TMR_ASYNC_WRITE_ENABLE_IDX0     false
#define DRV_TMR_POWER_STATE_IDX0            

#define DRV_TMR_PERIPHERAL_ID_IDX1          TMR_ID_2
#define DRV_TMR_INTERRUPT_SOURCE_IDX1       INT_SOURCE_TIMER_2
#define DRV_TMR_INTERRUPT_VECTOR_IDX1       INT_VECTOR_T2
#define DRV_TMR_ISR_VECTOR_IDX1             _TIMER_2_VECTOR
#define DRV_TMR_INTERRUPT_PRIORITY_IDX1     INT_PRIORITY_LEVEL4
#define DRV_TMR_INTERRUPT_SUB_PRIORITY_IDX1 INT_SUBPRIORITY_LEVEL0
#define DRV_TMR_CLOCK_SOURCE_IDX1           DRV_TMR_CLKSOURCE_INTERNAL
#define DRV_TMR_PRESCALE_IDX1               TMR_PRESCALE_VALUE_1
#define DRV_TMR_OPERATION_MODE_IDX1         DRV_TMR_OPERATION_MODE_16_BIT

#define DRV_TMR_ASYNC_WRITE_ENABLE_IDX1     false
#define DRV_TMR_POWER_STATE_IDX1            
/*** Timer Driver 2 Configuration ***/
#define DRV_TMR_PERIPHERAL_ID_IDX2          TMR_ID_3
#define DRV_TMR_INTERRUPT_SOURCE_IDX2       INT_SOURCE_TIMER_3
#define DRV_TMR_INTERRUPT_VECTOR_IDX2       INT_VECTOR_T3
#define DRV_TMR_ISR_VECTOR_IDX2             _TIMER_3_VECTOR
#define DRV_TMR_INTERRUPT_PRIORITY_IDX2     INT_PRIORITY_LEVEL2
#define DRV_TMR_INTERRUPT_SUB_PRIORITY_IDX2 INT_SUBPRIORITY_LEVEL0
#define DRV_TMR_CLOCK_SOURCE_IDX2           DRV_TMR_CLKSOURCE_INTERNAL
#define DRV_TMR_PRESCALE_IDX2               TMR_PRESCALE_VALUE_64
#define DRV_TMR_OPERATION_MODE_IDX2         DRV_TMR_OPERATION_MODE_16_BIT
#define DRV_TMR_ASYNC_WRITE_ENABLE_IDX2     false
#define DRV_TMR_POWER_STATE_IDX2            
/*** Timer Driver 3 Configuration ***/
#define DRV_TMR_PERIPHERAL_ID_IDX3          TMR_ID_4
#define DRV_TMR_INTERRUPT_SOURCE_IDX3       INT_SOURCE_TIMER_4
#define DRV_TMR_INTERRUPT_VECTOR_IDX3       INT_VECTOR_T4
#define DRV_TMR_ISR_VECTOR_IDX3             _TIMER_4_VECTOR
#define DRV_TMR_INTERRUPT_PRIORITY_IDX3     INT_PRIORITY_LEVEL1
#define DRV_TMR_INTERRUPT_SUB_PRIORITY_IDX3 INT_SUBPRIORITY_LEVEL0
#define DRV_TMR_CLOCK_SOURCE_IDX3           DRV_TMR_CLKSOURCE_INTERNAL
#define DRV_TMR_PRESCALE_IDX3               TMR_PRESCALE_VALUE_1
#define DRV_TMR_OPERATION_MODE_IDX3         DRV_TMR_OPERATION_MODE_16_BIT
#define DRV_TMR_ASYNC_WRITE_ENABLE_IDX3     false
#define DRV_TMR_POWER_STATE_IDX3            


 
// *****************************************************************************
// *****************************************************************************
// Section: Middleware & Other Library Configuration
// *****************************************************************************
// *****************************************************************************



// *****************************************************************************
// *****************************************************************************
// Section: Application Configuration
// *****************************************************************************
// *****************************************************************************
/*** Application Defined Pins ***/

/*** Functions for TEST_PIN pin ***/
#define TEST_PINToggle() PLIB_PORTS_PinToggle(PORTS_ID_0, PORT_CHANNEL_E, PORTS_BIT_POS_5)
#define TEST_PINOn() PLIB_PORTS_PinSet(PORTS_ID_0, PORT_CHANNEL_E, PORTS_BIT_POS_5)
#define TEST_PINOff() PLIB_PORTS_PinClear(PORTS_ID_0, PORT_CHANNEL_E, PORTS_BIT_POS_5)
#define TEST_PINStateGet() PLIB_PORTS_PinGetLatched(PORTS_ID_0, PORT_CHANNEL_E, PORTS_BIT_POS_5)
#define TEST_PINStateSet(Value) PLIB_PORTS_PinWrite(PORTS_ID_0, PORT_CHANNEL_E, PORTS_BIT_POS_5, Value)

/*** Functions for SCLK_TLC pin ***/
#define SCLK_TLCToggle() PLIB_PORTS_PinToggle(PORTS_ID_0, PORT_CHANNEL_G, PORTS_BIT_POS_6)
#define SCLK_TLCOn() PLIB_PORTS_PinSet(PORTS_ID_0, PORT_CHANNEL_G, PORTS_BIT_POS_6)
#define SCLK_TLCOff() PLIB_PORTS_PinClear(PORTS_ID_0, PORT_CHANNEL_G, PORTS_BIT_POS_6)
#define SCLK_TLCStateGet() PLIB_PORTS_PinGetLatched(PORTS_ID_0, PORT_CHANNEL_G, PORTS_BIT_POS_6)
#define SCLK_TLCStateSet(Value) PLIB_PORTS_PinWrite(PORTS_ID_0, PORT_CHANNEL_G, PORTS_BIT_POS_6, Value)

/*** Functions for AL1 pin ***/
#define AL1Toggle() PLIB_PORTS_PinToggle(PORTS_ID_0, PORT_CHANNEL_B, PORTS_BIT_POS_5)
#define AL1On() PLIB_PORTS_PinSet(PORTS_ID_0, PORT_CHANNEL_B, PORTS_BIT_POS_5)
#define AL1Off() PLIB_PORTS_PinClear(PORTS_ID_0, PORT_CHANNEL_B, PORTS_BIT_POS_5)
#define AL1StateGet() PLIB_PORTS_PinGetLatched(PORTS_ID_0, PORT_CHANNEL_B, PORTS_BIT_POS_5)
#define AL1StateSet(Value) PLIB_PORTS_PinWrite(PORTS_ID_0, PORT_CHANNEL_B, PORTS_BIT_POS_5, Value)

/*** Functions for AL2 pin ***/
#define AL2Toggle() PLIB_PORTS_PinToggle(PORTS_ID_0, PORT_CHANNEL_B, PORTS_BIT_POS_4)
#define AL2On() PLIB_PORTS_PinSet(PORTS_ID_0, PORT_CHANNEL_B, PORTS_BIT_POS_4)
#define AL2Off() PLIB_PORTS_PinClear(PORTS_ID_0, PORT_CHANNEL_B, PORTS_BIT_POS_4)
#define AL2StateGet() PLIB_PORTS_PinGetLatched(PORTS_ID_0, PORT_CHANNEL_B, PORTS_BIT_POS_4)
#define AL2StateSet(Value) PLIB_PORTS_PinWrite(PORTS_ID_0, PORT_CHANNEL_B, PORTS_BIT_POS_4, Value)

/*** Functions for AL3 pin ***/
#define AL3Toggle() PLIB_PORTS_PinToggle(PORTS_ID_0, PORT_CHANNEL_B, PORTS_BIT_POS_3)
#define AL3On() PLIB_PORTS_PinSet(PORTS_ID_0, PORT_CHANNEL_B, PORTS_BIT_POS_3)
#define AL3Off() PLIB_PORTS_PinClear(PORTS_ID_0, PORT_CHANNEL_B, PORTS_BIT_POS_3)
#define AL3StateGet() PLIB_PORTS_PinGetLatched(PORTS_ID_0, PORT_CHANNEL_B, PORTS_BIT_POS_3)
#define AL3StateSet(Value) PLIB_PORTS_PinWrite(PORTS_ID_0, PORT_CHANNEL_B, PORTS_BIT_POS_3, Value)

/*** Functions for AL4 pin ***/
#define AL4Toggle() PLIB_PORTS_PinToggle(PORTS_ID_0, PORT_CHANNEL_B, PORTS_BIT_POS_2)
#define AL4On() PLIB_PORTS_PinSet(PORTS_ID_0, PORT_CHANNEL_B, PORTS_BIT_POS_2)
#define AL4Off() PLIB_PORTS_PinClear(PORTS_ID_0, PORT_CHANNEL_B, PORTS_BIT_POS_2)
#define AL4StateGet() PLIB_PORTS_PinGetLatched(PORTS_ID_0, PORT_CHANNEL_B, PORTS_BIT_POS_2)
#define AL4StateSet(Value) PLIB_PORTS_PinWrite(PORTS_ID_0, PORT_CHANNEL_B, PORTS_BIT_POS_2, Value)

/*** Functions for Config_IO_A pin ***/
#define Config_IO_AToggle() PLIB_PORTS_PinToggle(PORTS_ID_0, PORT_CHANNEL_B, PORTS_BIT_POS_7)
#define Config_IO_AOn() PLIB_PORTS_PinSet(PORTS_ID_0, PORT_CHANNEL_B, PORTS_BIT_POS_7)
#define Config_IO_AOff() PLIB_PORTS_PinClear(PORTS_ID_0, PORT_CHANNEL_B, PORTS_BIT_POS_7)
#define Config_IO_AStateGet() PLIB_PORTS_PinGetLatched(PORTS_ID_0, PORT_CHANNEL_B, PORTS_BIT_POS_7)
#define Config_IO_AStateSet(Value) PLIB_PORTS_PinWrite(PORTS_ID_0, PORT_CHANNEL_B, PORTS_BIT_POS_7, Value)

/*** Functions for BL1 pin ***/
#define BL1Toggle() PLIB_PORTS_PinToggle(PORTS_ID_0, PORT_CHANNEL_B, PORTS_BIT_POS_8)
#define BL1On() PLIB_PORTS_PinSet(PORTS_ID_0, PORT_CHANNEL_B, PORTS_BIT_POS_8)
#define BL1Off() PLIB_PORTS_PinClear(PORTS_ID_0, PORT_CHANNEL_B, PORTS_BIT_POS_8)
#define BL1StateGet() PLIB_PORTS_PinGetLatched(PORTS_ID_0, PORT_CHANNEL_B, PORTS_BIT_POS_8)
#define BL1StateSet(Value) PLIB_PORTS_PinWrite(PORTS_ID_0, PORT_CHANNEL_B, PORTS_BIT_POS_8, Value)

/*** Functions for BL2 pin ***/
#define BL2Toggle() PLIB_PORTS_PinToggle(PORTS_ID_0, PORT_CHANNEL_B, PORTS_BIT_POS_9)
#define BL2On() PLIB_PORTS_PinSet(PORTS_ID_0, PORT_CHANNEL_B, PORTS_BIT_POS_9)
#define BL2Off() PLIB_PORTS_PinClear(PORTS_ID_0, PORT_CHANNEL_B, PORTS_BIT_POS_9)
#define BL2StateGet() PLIB_PORTS_PinGetLatched(PORTS_ID_0, PORT_CHANNEL_B, PORTS_BIT_POS_9)
#define BL2StateSet(Value) PLIB_PORTS_PinWrite(PORTS_ID_0, PORT_CHANNEL_B, PORTS_BIT_POS_9, Value)

/*** Functions for BL3 pin ***/
#define BL3Toggle() PLIB_PORTS_PinToggle(PORTS_ID_0, PORT_CHANNEL_B, PORTS_BIT_POS_10)
#define BL3On() PLIB_PORTS_PinSet(PORTS_ID_0, PORT_CHANNEL_B, PORTS_BIT_POS_10)
#define BL3Off() PLIB_PORTS_PinClear(PORTS_ID_0, PORT_CHANNEL_B, PORTS_BIT_POS_10)
#define BL3StateGet() PLIB_PORTS_PinGetLatched(PORTS_ID_0, PORT_CHANNEL_B, PORTS_BIT_POS_10)
#define BL3StateSet(Value) PLIB_PORTS_PinWrite(PORTS_ID_0, PORT_CHANNEL_B, PORTS_BIT_POS_10, Value)

/*** Functions for BL4 pin ***/
#define BL4Toggle() PLIB_PORTS_PinToggle(PORTS_ID_0, PORT_CHANNEL_B, PORTS_BIT_POS_11)
#define BL4On() PLIB_PORTS_PinSet(PORTS_ID_0, PORT_CHANNEL_B, PORTS_BIT_POS_11)
#define BL4Off() PLIB_PORTS_PinClear(PORTS_ID_0, PORT_CHANNEL_B, PORTS_BIT_POS_11)
#define BL4StateGet() PLIB_PORTS_PinGetLatched(PORTS_ID_0, PORT_CHANNEL_B, PORTS_BIT_POS_11)
#define BL4StateSet(Value) PLIB_PORTS_PinWrite(PORTS_ID_0, PORT_CHANNEL_B, PORTS_BIT_POS_11, Value)

/*** Functions for AMatriceON pin ***/
#define AMatriceONToggle() PLIB_PORTS_PinToggle(PORTS_ID_0, PORT_CHANNEL_B, PORTS_BIT_POS_12)
#define AMatriceONOn() PLIB_PORTS_PinSet(PORTS_ID_0, PORT_CHANNEL_B, PORTS_BIT_POS_12)
#define AMatriceONOff() PLIB_PORTS_PinClear(PORTS_ID_0, PORT_CHANNEL_B, PORTS_BIT_POS_12)
#define AMatriceONStateGet() PLIB_PORTS_PinGetLatched(PORTS_ID_0, PORT_CHANNEL_B, PORTS_BIT_POS_12)
#define AMatriceONStateSet(Value) PLIB_PORTS_PinWrite(PORTS_ID_0, PORT_CHANNEL_B, PORTS_BIT_POS_12, Value)

/*** Functions for BMatriceON pin ***/
#define BMatriceONToggle() PLIB_PORTS_PinToggle(PORTS_ID_0, PORT_CHANNEL_B, PORTS_BIT_POS_13)
#define BMatriceONOn() PLIB_PORTS_PinSet(PORTS_ID_0, PORT_CHANNEL_B, PORTS_BIT_POS_13)
#define BMatriceONOff() PLIB_PORTS_PinClear(PORTS_ID_0, PORT_CHANNEL_B, PORTS_BIT_POS_13)
#define BMatriceONStateGet() PLIB_PORTS_PinGetLatched(PORTS_ID_0, PORT_CHANNEL_B, PORTS_BIT_POS_13)
#define BMatriceONStateSet(Value) PLIB_PORTS_PinWrite(PORTS_ID_0, PORT_CHANNEL_B, PORTS_BIT_POS_13, Value)

/*** Functions for Config_IO_B pin ***/
#define Config_IO_BToggle() PLIB_PORTS_PinToggle(PORTS_ID_0, PORT_CHANNEL_B, PORTS_BIT_POS_15)
#define Config_IO_BOn() PLIB_PORTS_PinSet(PORTS_ID_0, PORT_CHANNEL_B, PORTS_BIT_POS_15)
#define Config_IO_BOff() PLIB_PORTS_PinClear(PORTS_ID_0, PORT_CHANNEL_B, PORTS_BIT_POS_15)
#define Config_IO_BStateGet() PLIB_PORTS_PinGetLatched(PORTS_ID_0, PORT_CHANNEL_B, PORTS_BIT_POS_15)
#define Config_IO_BStateSet(Value) PLIB_PORTS_PinWrite(PORTS_ID_0, PORT_CHANNEL_B, PORTS_BIT_POS_15, Value)

/*** Functions for VPRG_TLC pin ***/
#define VPRG_TLCToggle() PLIB_PORTS_PinToggle(PORTS_ID_0, PORT_CHANNEL_C, PORTS_BIT_POS_15)
#define VPRG_TLCOn() PLIB_PORTS_PinSet(PORTS_ID_0, PORT_CHANNEL_C, PORTS_BIT_POS_15)
#define VPRG_TLCOff() PLIB_PORTS_PinClear(PORTS_ID_0, PORT_CHANNEL_C, PORTS_BIT_POS_15)
#define VPRG_TLCStateGet() PLIB_PORTS_PinGetLatched(PORTS_ID_0, PORT_CHANNEL_C, PORTS_BIT_POS_15)
#define VPRG_TLCStateSet(Value) PLIB_PORTS_PinWrite(PORTS_ID_0, PORT_CHANNEL_C, PORTS_BIT_POS_15, Value)

/*** Functions for CS_Accel pin ***/
#define CS_AccelToggle() PLIB_PORTS_PinToggle(PORTS_ID_0, PORT_CHANNEL_D, PORTS_BIT_POS_8)
#define CS_AccelOn() PLIB_PORTS_PinSet(PORTS_ID_0, PORT_CHANNEL_D, PORTS_BIT_POS_8)
#define CS_AccelOff() PLIB_PORTS_PinClear(PORTS_ID_0, PORT_CHANNEL_D, PORTS_BIT_POS_8)
#define CS_AccelStateGet() PLIB_PORTS_PinGetLatched(PORTS_ID_0, PORT_CHANNEL_D, PORTS_BIT_POS_8)
#define CS_AccelStateSet(Value) PLIB_PORTS_PinWrite(PORTS_ID_0, PORT_CHANNEL_D, PORTS_BIT_POS_8, Value)

/*** Functions for XLAT_TLC pin ***/
#define XLAT_TLCToggle() PLIB_PORTS_PinToggle(PORTS_ID_0, PORT_CHANNEL_D, PORTS_BIT_POS_4)
#define XLAT_TLCOn() PLIB_PORTS_PinSet(PORTS_ID_0, PORT_CHANNEL_D, PORTS_BIT_POS_4)
#define XLAT_TLCOff() PLIB_PORTS_PinClear(PORTS_ID_0, PORT_CHANNEL_D, PORTS_BIT_POS_4)
#define XLAT_TLCStateGet() PLIB_PORTS_PinGetLatched(PORTS_ID_0, PORT_CHANNEL_D, PORTS_BIT_POS_4)
#define XLAT_TLCStateSet(Value) PLIB_PORTS_PinWrite(PORTS_ID_0, PORT_CHANNEL_D, PORTS_BIT_POS_4, Value)

/*** Functions for BLANK_TLC pin ***/
#define BLANK_TLCToggle() PLIB_PORTS_PinToggle(PORTS_ID_0, PORT_CHANNEL_D, PORTS_BIT_POS_5)
#define BLANK_TLCOn() PLIB_PORTS_PinSet(PORTS_ID_0, PORT_CHANNEL_D, PORTS_BIT_POS_5)
#define BLANK_TLCOff() PLIB_PORTS_PinClear(PORTS_ID_0, PORT_CHANNEL_D, PORTS_BIT_POS_5)
#define BLANK_TLCStateGet() PLIB_PORTS_PinGetLatched(PORTS_ID_0, PORT_CHANNEL_D, PORTS_BIT_POS_5)
#define BLANK_TLCStateSet(Value) PLIB_PORTS_PinWrite(PORTS_ID_0, PORT_CHANNEL_D, PORTS_BIT_POS_5, Value)

/*** Functions for SEL_Charger pin ***/
#define SEL_ChargerToggle() PLIB_PORTS_PinToggle(PORTS_ID_0, PORT_CHANNEL_D, PORTS_BIT_POS_6)
#define SEL_ChargerOn() PLIB_PORTS_PinSet(PORTS_ID_0, PORT_CHANNEL_D, PORTS_BIT_POS_6)
#define SEL_ChargerOff() PLIB_PORTS_PinClear(PORTS_ID_0, PORT_CHANNEL_D, PORTS_BIT_POS_6)
#define SEL_ChargerStateGet() PLIB_PORTS_PinGetLatched(PORTS_ID_0, PORT_CHANNEL_D, PORTS_BIT_POS_6)
#define SEL_ChargerStateSet(Value) PLIB_PORTS_PinWrite(PORTS_ID_0, PORT_CHANNEL_D, PORTS_BIT_POS_6, Value)

/*** Functions for PROG2_Charger pin ***/
#define PROG2_ChargerToggle() PLIB_PORTS_PinToggle(PORTS_ID_0, PORT_CHANNEL_D, PORTS_BIT_POS_7)
#define PROG2_ChargerOn() PLIB_PORTS_PinSet(PORTS_ID_0, PORT_CHANNEL_D, PORTS_BIT_POS_7)
#define PROG2_ChargerOff() PLIB_PORTS_PinClear(PORTS_ID_0, PORT_CHANNEL_D, PORTS_BIT_POS_7)
#define PROG2_ChargerStateGet() PLIB_PORTS_PinGetLatched(PORTS_ID_0, PORT_CHANNEL_D, PORTS_BIT_POS_7)
#define PROG2_ChargerStateSet(Value) PLIB_PORTS_PinWrite(PORTS_ID_0, PORT_CHANNEL_D, PORTS_BIT_POS_7, Value)

/*** Functions for CE_Charger pin ***/
#define CE_ChargerToggle() PLIB_PORTS_PinToggle(PORTS_ID_0, PORT_CHANNEL_F, PORTS_BIT_POS_0)
#define CE_ChargerOn() PLIB_PORTS_PinSet(PORTS_ID_0, PORT_CHANNEL_F, PORTS_BIT_POS_0)
#define CE_ChargerOff() PLIB_PORTS_PinClear(PORTS_ID_0, PORT_CHANNEL_F, PORTS_BIT_POS_0)
#define CE_ChargerStateGet() PLIB_PORTS_PinGetLatched(PORTS_ID_0, PORT_CHANNEL_F, PORTS_BIT_POS_0)
#define CE_ChargerStateSet(Value) PLIB_PORTS_PinWrite(PORTS_ID_0, PORT_CHANNEL_F, PORTS_BIT_POS_0, Value)

/*** Functions for TE_Charger pin ***/
#define TE_ChargerToggle() PLIB_PORTS_PinToggle(PORTS_ID_0, PORT_CHANNEL_F, PORTS_BIT_POS_1)
#define TE_ChargerOn() PLIB_PORTS_PinSet(PORTS_ID_0, PORT_CHANNEL_F, PORTS_BIT_POS_1)
#define TE_ChargerOff() PLIB_PORTS_PinClear(PORTS_ID_0, PORT_CHANNEL_F, PORTS_BIT_POS_1)
#define TE_ChargerStateGet() PLIB_PORTS_PinGetLatched(PORTS_ID_0, PORT_CHANNEL_F, PORTS_BIT_POS_1)
#define TE_ChargerStateSet(Value) PLIB_PORTS_PinWrite(PORTS_ID_0, PORT_CHANNEL_F, PORTS_BIT_POS_1, Value)

/*** Functions for EN_WIFI pin ***/
#define EN_WIFIToggle() PLIB_PORTS_PinToggle(PORTS_ID_0, PORT_CHANNEL_E, PORTS_BIT_POS_0)
#define EN_WIFIOn() PLIB_PORTS_PinSet(PORTS_ID_0, PORT_CHANNEL_E, PORTS_BIT_POS_0)
#define EN_WIFIOff() PLIB_PORTS_PinClear(PORTS_ID_0, PORT_CHANNEL_E, PORTS_BIT_POS_0)
#define EN_WIFIStateGet() PLIB_PORTS_PinGetLatched(PORTS_ID_0, PORT_CHANNEL_E, PORTS_BIT_POS_0)
#define EN_WIFIStateSet(Value) PLIB_PORTS_PinWrite(PORTS_ID_0, PORT_CHANNEL_E, PORTS_BIT_POS_0, Value)

/*** Functions for Buzzer pin ***/
#define BuzzerToggle() PLIB_PORTS_PinToggle(PORTS_ID_0, PORT_CHANNEL_E, PORTS_BIT_POS_1)
#define BuzzerOn() PLIB_PORTS_PinSet(PORTS_ID_0, PORT_CHANNEL_E, PORTS_BIT_POS_1)
#define BuzzerOff() PLIB_PORTS_PinClear(PORTS_ID_0, PORT_CHANNEL_E, PORTS_BIT_POS_1)
#define BuzzerStateGet() PLIB_PORTS_PinGetLatched(PORTS_ID_0, PORT_CHANNEL_E, PORTS_BIT_POS_1)
#define BuzzerStateSet(Value) PLIB_PORTS_PinWrite(PORTS_ID_0, PORT_CHANNEL_E, PORTS_BIT_POS_1, Value)

/*** Functions for SW_DOWN pin ***/
#define SW_DOWNStateGet() PLIB_PORTS_PinGet(PORTS_ID_0, PORT_CHANNEL_E, PORTS_BIT_POS_2)

/*** Functions for SW_SEL pin ***/
#define SW_SELStateGet() PLIB_PORTS_PinGet(PORTS_ID_0, PORT_CHANNEL_E, PORTS_BIT_POS_3)

/*** Functions for SW_UP pin ***/
#define SW_UPStateGet() PLIB_PORTS_PinGet(PORTS_ID_0, PORT_CHANNEL_E, PORTS_BIT_POS_4)


/*** Application Instance 0 Configuration ***/

//DOM-IGNORE-BEGIN
#ifdef __cplusplus
}
#endif
//DOM-IGNORE-END

#endif // _SYSTEM_CONFIG_H
/*******************************************************************************
 End of File
*/
