SwissMaverick/PROJ-2008_SablierElectronique/2008_SablierElectronique/soft/2008D_Sablier_electronique_backup/firmware/src/system_config/default/system_config.h

/*******************************************************************************
  MPLAB Harmony System Configuration Header

  File Name:
    system_config.h

  Summary:
    Build-time configuration header for the system defined by this MPLAB Harmony
    project.

  Description:
    An MPLAB Project may have multiple configurations.  This file defines the
    build-time options for a single configuration.

  Remarks:
    This configuration header must not define any prototypes or data
    definitions (or include any files that do).  It only provides macro
    definitions for build-time configuration options that are not instantiated
    until used by another MPLAB Harmony module or application.

    Created with MPLAB Harmony Version 2.06
*******************************************************************************/

// DOM-IGNORE-BEGIN
/*******************************************************************************
Copyright (c) 2013-2015 released Microchip Technology Inc.  All rights reserved.

Microchip licenses to you the right to use, modify, copy and distribute
Software only when embedded on a Microchip microcontroller or digital signal
controller that is integrated into your product or third party product
(pursuant to the sublicense terms in the accompanying license agreement).

You should refer to the license agreement accompanying this Software for
additional information regarding your rights and obligations.

SOFTWARE AND DOCUMENTATION ARE PROVIDED AS IS WITHOUT WARRANTY OF ANY KIND,
EITHER EXPRESS OR IMPLIED, INCLUDING WITHOUT LIMITATION, ANY WARRANTY OF
MERCHANTABILITY, TITLE, NON-INFRINGEMENT AND FITNESS FOR A PARTICULAR PURPOSE.
IN NO EVENT SHALL MICROCHIP OR ITS LICENSORS BE LIABLE OR OBLIGATED UNDER
CONTRACT, NEGLIGENCE, STRICT LIABILITY, CONTRIBUTION, BREACH OF WARRANTY, OR
OTHER LEGAL EQUITABLE THEORY ANY DIRECT OR INDIRECT DAMAGES OR EXPENSES
INCLUDING BUT NOT LIMITED TO ANY INCIDENTAL, SPECIAL, INDIRECT, PUNITIVE OR
CONSEQUENTIAL DAMAGES, LOST PROFITS OR LOST DATA, COST OF PROCUREMENT OF
SUBSTITUTE GOODS, TECHNOLOGY, SERVICES, OR ANY CLAIMS BY THIRD PARTIES
(INCLUDING BUT NOT LIMITED TO ANY DEFENSE THEREOF), OR OTHER SIMILAR COSTS.
*******************************************************************************/
// DOM-IGNORE-END

#ifndef _SYSTEM_CONFIG_H
#define _SYSTEM_CONFIG_H

// *****************************************************************************
// *****************************************************************************
// Section: Included Files
// *****************************************************************************
// *****************************************************************************
/*  This section Includes other configuration headers necessary to completely
    define this configuration.
*/


// DOM-IGNORE-BEGIN
#ifdef __cplusplus  // Provide C++ Compatibility

extern "C" {

#endif
// DOM-IGNORE-END

// *****************************************************************************
// *****************************************************************************
// Section: System Service Configuration
// *****************************************************************************
// *****************************************************************************
// *****************************************************************************
/* Common System Service Configuration Options
*/
#define SYS_VERSION_STR           "2.06"
#define SYS_VERSION               20600

// *****************************************************************************
/* Clock System Service Configuration Options
*/
#define SYS_CLK_FREQ                        80000000ul
#define SYS_CLK_BUS_PERIPHERAL_1            80000000ul
#define SYS_CLK_UPLL_BEFORE_DIV2_FREQ       48000000ul
#define SYS_CLK_CONFIG_PRIMARY_XTAL         0ul
#define SYS_CLK_CONFIG_SECONDARY_XTAL       32768ul
   
/*** Ports System Service Configuration ***/
#define SYS_PORT_AD1PCFG        ~0x1003
#define SYS_PORT_CNPUE          0x0
#define SYS_PORT_CNEN           0x0
#define SYS_PORT_A_TRIS         0x3F3F
#define SYS_PORT_A_LAT          0xC0C0
#define SYS_PORT_A_ODC          0x0000

#define SYS_PORT_B_TRIS         0x113F
#define SYS_PORT_B_LAT          0x6000
#define SYS_PORT_B_ODC          0x0000

#define SYS_PORT_C_TRIS         0xD7FF
#define SYS_PORT_C_LAT          0x2800
#define SYS_PORT_C_ODC          0x0000

#define SYS_PORT_D_TRIS         0xC405
#define SYS_PORT_D_LAT          0x3BFA
#define SYS_PORT_D_ODC          0x0000

#define SYS_PORT_E_TRIS         0xFF71
#define SYS_PORT_E_LAT          0x0004
#define SYS_PORT_E_ODC          0x0000

#define SYS_PORT_F_TRIS         0xFFD6
#define SYS_PORT_F_LAT          0x0029
#define SYS_PORT_F_ODC          0x0000

#define SYS_PORT_G_TRIS         0xFEBF
#define SYS_PORT_G_LAT          0x0000
#define SYS_PORT_G_ODC          0x0000


/*** Interrupt System Service Configuration ***/
#define SYS_INT                     true

// *****************************************************************************
// *****************************************************************************
// Section: Driver Configuration
// *****************************************************************************
// *****************************************************************************
/*** Timer Driver Configuration ***/
#define DRV_TMR_INTERRUPT_MODE             true

/*** Timer Driver 0 Configuration ***/
#define DRV_TMR_PERIPHERAL_ID_IDX0          TMR_ID_1
#define DRV_TMR_INTERRUPT_SOURCE_IDX0       INT_SOURCE_TIMER_1
#define DRV_TMR_INTERRUPT_VECTOR_IDX0       INT_VECTOR_T1
#define DRV_TMR_ISR_VECTOR_IDX0             _TIMER_1_VECTOR
#define DRV_TMR_INTERRUPT_PRIORITY_IDX0     INT_PRIORITY_LEVEL3
#define DRV_TMR_INTERRUPT_SUB_PRIORITY_IDX0 INT_SUBPRIORITY_LEVEL0
#define DRV_TMR_CLOCK_SOURCE_IDX0           DRV_TMR_CLKSOURCE_INTERNAL
#define DRV_TMR_PRESCALE_IDX0               TMR_PRESCALE_VALUE_8
#define DRV_TMR_OPERATION_MODE_IDX0         DRV_TMR_OPERATION_MODE_16_BIT
#define DRV_TMR_ASYNC_WRITE_ENABLE_IDX0     false
#define DRV_TMR_POWER_STATE_IDX0            

#define DRV_TMR_PERIPHERAL_ID_IDX1          TMR_ID_2
#define DRV_TMR_INTERRUPT_SOURCE_IDX1       INT_SOURCE_TIMER_2
#define DRV_TMR_INTERRUPT_VECTOR_IDX1       INT_VECTOR_T2
#define DRV_TMR_ISR_VECTOR_IDX1             _TIMER_2_VECTOR
#define DRV_TMR_INTERRUPT_PRIORITY_IDX1     INT_PRIORITY_LEVEL1
#define DRV_TMR_INTERRUPT_SUB_PRIORITY_IDX1 INT_SUBPRIORITY_LEVEL0
#define DRV_TMR_CLOCK_SOURCE_IDX1           DRV_TMR_CLKSOURCE_INTERNAL
#define DRV_TMR_PRESCALE_IDX1               TMR_PRESCALE_VALUE_2
#define DRV_TMR_OPERATION_MODE_IDX1         DRV_TMR_OPERATION_MODE_16_BIT

#define DRV_TMR_ASYNC_WRITE_ENABLE_IDX1     false
#define DRV_TMR_POWER_STATE_IDX1            
/*** Timer Driver 2 Configuration ***/
#define DRV_TMR_PERIPHERAL_ID_IDX2          TMR_ID_4
#define DRV_TMR_INTERRUPT_SOURCE_IDX2       INT_SOURCE_TIMER_5
#define DRV_TMR_INTERRUPT_VECTOR_IDX2       INT_VECTOR_T5
#define DRV_TMR_ISR_VECTOR_IDX2             _TIMER_5_VECTOR
#define DRV_TMR_INTERRUPT_PRIORITY_IDX2     INT_PRIORITY_LEVEL2
#define DRV_TMR_INTERRUPT_SUB_PRIORITY_IDX2 INT_SUBPRIORITY_LEVEL0
#define DRV_TMR_CLOCK_SOURCE_IDX2           DRV_TMR_CLKSOURCE_INTERNAL
#define DRV_TMR_PRESCALE_IDX2               TMR_PRESCALE_VALUE_16
#define DRV_TMR_OPERATION_MODE_IDX2         DRV_TMR_OPERATION_MODE_32_BIT
#define DRV_TMR_ASYNC_WRITE_ENABLE_IDX2     false
#define DRV_TMR_POWER_STATE_IDX2            

 
// *****************************************************************************
// *****************************************************************************
// Section: Middleware & Other Library Configuration
// *****************************************************************************
// *****************************************************************************



// *****************************************************************************
// *****************************************************************************
// Section: Application Configuration
// *****************************************************************************
// *****************************************************************************
/*** Application Defined Pins ***/

/*** Functions for RS232_CTS pin ***/
#define RS232_CTSToggle() PLIB_PORTS_PinToggle(PORTS_ID_0, PORT_CHANNEL_E, PORTS_BIT_POS_7)
#define RS232_CTSOn() PLIB_PORTS_PinSet(PORTS_ID_0, PORT_CHANNEL_E, PORTS_BIT_POS_7)
#define RS232_CTSOff() PLIB_PORTS_PinClear(PORTS_ID_0, PORT_CHANNEL_E, PORTS_BIT_POS_7)
#define RS232_CTSStateGet() PLIB_PORTS_PinGetLatched(PORTS_ID_0, PORT_CHANNEL_E, PORTS_BIT_POS_7)
#define RS232_CTSStateSet(Value) PLIB_PORTS_PinWrite(PORTS_ID_0, PORT_CHANNEL_E, PORTS_BIT_POS_7, Value)

/*** Functions for RS232_RTS pin ***/
#define RS232_RTSToggle() PLIB_PORTS_PinToggle(PORTS_ID_0, PORT_CHANNEL_G, PORTS_BIT_POS_6)
#define RS232_RTSOn() PLIB_PORTS_PinSet(PORTS_ID_0, PORT_CHANNEL_G, PORTS_BIT_POS_6)
#define RS232_RTSOff() PLIB_PORTS_PinClear(PORTS_ID_0, PORT_CHANNEL_G, PORTS_BIT_POS_6)
#define RS232_RTSStateGet() PLIB_PORTS_PinGetLatched(PORTS_ID_0, PORT_CHANNEL_G, PORTS_BIT_POS_6)
#define RS232_RTSStateSet(Value) PLIB_PORTS_PinWrite(PORTS_ID_0, PORT_CHANNEL_G, PORTS_BIT_POS_6, Value)

/*** Functions for Buzzer pin ***/
#define BuzzerToggle() PLIB_PORTS_PinToggle(PORTS_ID_0, PORT_CHANNEL_G, PORTS_BIT_POS_8)
#define BuzzerOn() PLIB_PORTS_PinSet(PORTS_ID_0, PORT_CHANNEL_G, PORTS_BIT_POS_8)
#define BuzzerOff() PLIB_PORTS_PinClear(PORTS_ID_0, PORT_CHANNEL_G, PORTS_BIT_POS_8)
#define BuzzerStateGet() PLIB_PORTS_PinGetLatched(PORTS_ID_0, PORT_CHANNEL_G, PORTS_BIT_POS_8)
#define BuzzerStateSet(Value) PLIB_PORTS_PinWrite(PORTS_ID_0, PORT_CHANNEL_G, PORTS_BIT_POS_8, Value)

/*** Functions for InBC1 pin ***/
#define InBC1Toggle() PLIB_PORTS_PinToggle(PORTS_ID_0, PORT_CHANNEL_B, PORTS_BIT_POS_6)
#define InBC1On() PLIB_PORTS_PinSet(PORTS_ID_0, PORT_CHANNEL_B, PORTS_BIT_POS_6)
#define InBC1Off() PLIB_PORTS_PinClear(PORTS_ID_0, PORT_CHANNEL_B, PORTS_BIT_POS_6)
#define InBC1StateGet() PLIB_PORTS_PinGetLatched(PORTS_ID_0, PORT_CHANNEL_B, PORTS_BIT_POS_6)
#define InBC1StateSet(Value) PLIB_PORTS_PinWrite(PORTS_ID_0, PORT_CHANNEL_B, PORTS_BIT_POS_6, Value)

/*** Functions for Config_IO_A pin ***/
#define Config_IO_AToggle() PLIB_PORTS_PinToggle(PORTS_ID_0, PORT_CHANNEL_B, PORTS_BIT_POS_7)
#define Config_IO_AOn() PLIB_PORTS_PinSet(PORTS_ID_0, PORT_CHANNEL_B, PORTS_BIT_POS_7)
#define Config_IO_AOff() PLIB_PORTS_PinClear(PORTS_ID_0, PORT_CHANNEL_B, PORTS_BIT_POS_7)
#define Config_IO_AStateGet() PLIB_PORTS_PinGetLatched(PORTS_ID_0, PORT_CHANNEL_B, PORTS_BIT_POS_7)
#define Config_IO_AStateSet(Value) PLIB_PORTS_PinWrite(PORTS_ID_0, PORT_CHANNEL_B, PORTS_BIT_POS_7, Value)

/*** Functions for L3 pin ***/
#define L3Toggle() PLIB_PORTS_PinToggle(PORTS_ID_0, PORT_CHANNEL_B, PORTS_BIT_POS_9)
#define L3On() PLIB_PORTS_PinSet(PORTS_ID_0, PORT_CHANNEL_B, PORTS_BIT_POS_9)
#define L3Off() PLIB_PORTS_PinClear(PORTS_ID_0, PORT_CHANNEL_B, PORTS_BIT_POS_9)
#define L3StateGet() PLIB_PORTS_PinGetLatched(PORTS_ID_0, PORT_CHANNEL_B, PORTS_BIT_POS_9)
#define L3StateSet(Value) PLIB_PORTS_PinWrite(PORTS_ID_0, PORT_CHANNEL_B, PORTS_BIT_POS_9, Value)

/*** Functions for L4 pin ***/
#define L4Toggle() PLIB_PORTS_PinToggle(PORTS_ID_0, PORT_CHANNEL_B, PORTS_BIT_POS_10)
#define L4On() PLIB_PORTS_PinSet(PORTS_ID_0, PORT_CHANNEL_B, PORTS_BIT_POS_10)
#define L4Off() PLIB_PORTS_PinClear(PORTS_ID_0, PORT_CHANNEL_B, PORTS_BIT_POS_10)
#define L4StateGet() PLIB_PORTS_PinGetLatched(PORTS_ID_0, PORT_CHANNEL_B, PORTS_BIT_POS_10)
#define L4StateSet(Value) PLIB_PORTS_PinWrite(PORTS_ID_0, PORT_CHANNEL_B, PORTS_BIT_POS_10, Value)

/*** Functions for L1 pin ***/
#define L1Toggle() PLIB_PORTS_PinToggle(PORTS_ID_0, PORT_CHANNEL_B, PORTS_BIT_POS_11)
#define L1On() PLIB_PORTS_PinSet(PORTS_ID_0, PORT_CHANNEL_B, PORTS_BIT_POS_11)
#define L1Off() PLIB_PORTS_PinClear(PORTS_ID_0, PORT_CHANNEL_B, PORTS_BIT_POS_11)
#define L1StateGet() PLIB_PORTS_PinGetLatched(PORTS_ID_0, PORT_CHANNEL_B, PORTS_BIT_POS_11)
#define L1StateSet(Value) PLIB_PORTS_PinWrite(PORTS_ID_0, PORT_CHANNEL_B, PORTS_BIT_POS_11, Value)

/*** Functions for L2 pin ***/
#define L2Toggle() PLIB_PORTS_PinToggle(PORTS_ID_0, PORT_CHANNEL_None, PORTS_BIT_POS_-1)
#define L2On() PLIB_PORTS_PinSet(PORTS_ID_0, PORT_CHANNEL_None, PORTS_BIT_POS_-1)
#define L2Off() PLIB_PORTS_PinClear(PORTS_ID_0, PORT_CHANNEL_None, PORTS_BIT_POS_-1)
#define L2StateGet() PLIB_PORTS_PinGetLatched(PORTS_ID_0, PORT_CHANNEL_None, PORTS_BIT_POS_-1)
#define L2StateSet(Value) PLIB_PORTS_PinWrite(PORTS_ID_0, PORT_CHANNEL_None, PORTS_BIT_POS_-1, Value)

/*** Functions for MatriceON pin ***/
#define MatriceONToggle() PLIB_PORTS_PinToggle(PORTS_ID_0, PORT_CHANNEL_B, PORTS_BIT_POS_13)
#define MatriceONOn() PLIB_PORTS_PinSet(PORTS_ID_0, PORT_CHANNEL_B, PORTS_BIT_POS_13)
#define MatriceONOff() PLIB_PORTS_PinClear(PORTS_ID_0, PORT_CHANNEL_B, PORTS_BIT_POS_13)
#define MatriceONStateGet() PLIB_PORTS_PinGetLatched(PORTS_ID_0, PORT_CHANNEL_B, PORTS_BIT_POS_13)
#define MatriceONStateSet(Value) PLIB_PORTS_PinWrite(PORTS_ID_0, PORT_CHANNEL_B, PORTS_BIT_POS_13, Value)

/*** Functions for BMatriceON pin ***/
#define BMatriceONToggle() PLIB_PORTS_PinToggle(PORTS_ID_0, PORT_CHANNEL_B, PORTS_BIT_POS_14)
#define BMatriceONOn() PLIB_PORTS_PinSet(PORTS_ID_0, PORT_CHANNEL_B, PORTS_BIT_POS_14)
#define BMatriceONOff() PLIB_PORTS_PinClear(PORTS_ID_0, PORT_CHANNEL_B, PORTS_BIT_POS_14)
#define BMatriceONStateGet() PLIB_PORTS_PinGetLatched(PORTS_ID_0, PORT_CHANNEL_B, PORTS_BIT_POS_14)
#define BMatriceONStateSet(Value) PLIB_PORTS_PinWrite(PORTS_ID_0, PORT_CHANNEL_B, PORTS_BIT_POS_14, Value)

/*** Functions for Config_IO_B pin ***/
#define Config_IO_BToggle() PLIB_PORTS_PinToggle(PORTS_ID_0, PORT_CHANNEL_B, PORTS_BIT_POS_15)
#define Config_IO_BOn() PLIB_PORTS_PinSet(PORTS_ID_0, PORT_CHANNEL_B, PORTS_BIT_POS_15)
#define Config_IO_BOff() PLIB_PORTS_PinClear(PORTS_ID_0, PORT_CHANNEL_B, PORTS_BIT_POS_15)
#define Config_IO_BStateGet() PLIB_PORTS_PinGetLatched(PORTS_ID_0, PORT_CHANNEL_B, PORTS_BIT_POS_15)
#define Config_IO_BStateSet(Value) PLIB_PORTS_PinWrite(PORTS_ID_0, PORT_CHANNEL_B, PORTS_BIT_POS_15, Value)

/*** Functions for InBC9 pin ***/
#define InBC9Toggle() PLIB_PORTS_PinToggle(PORTS_ID_0, PORT_CHANNEL_F, PORTS_BIT_POS_5)
#define InBC9On() PLIB_PORTS_PinSet(PORTS_ID_0, PORT_CHANNEL_F, PORTS_BIT_POS_5)
#define InBC9Off() PLIB_PORTS_PinClear(PORTS_ID_0, PORT_CHANNEL_F, PORTS_BIT_POS_5)
#define InBC9StateGet() PLIB_PORTS_PinGetLatched(PORTS_ID_0, PORT_CHANNEL_F, PORTS_BIT_POS_5)
#define InBC9StateSet(Value) PLIB_PORTS_PinWrite(PORTS_ID_0, PORT_CHANNEL_F, PORTS_BIT_POS_5, Value)

/*** Functions for InBC10 pin ***/
#define InBC10Toggle() PLIB_PORTS_PinToggle(PORTS_ID_0, PORT_CHANNEL_F, PORTS_BIT_POS_3)
#define InBC10On() PLIB_PORTS_PinSet(PORTS_ID_0, PORT_CHANNEL_F, PORTS_BIT_POS_3)
#define InBC10Off() PLIB_PORTS_PinClear(PORTS_ID_0, PORT_CHANNEL_F, PORTS_BIT_POS_3)
#define InBC10StateGet() PLIB_PORTS_PinGetLatched(PORTS_ID_0, PORT_CHANNEL_F, PORTS_BIT_POS_3)
#define InBC10StateSet(Value) PLIB_PORTS_PinWrite(PORTS_ID_0, PORT_CHANNEL_F, PORTS_BIT_POS_3, Value)

/*** Functions for InBC11 pin ***/
#define InBC11Toggle() PLIB_PORTS_PinToggle(PORTS_ID_0, PORT_CHANNEL_None, PORTS_BIT_POS_-1)
#define InBC11On() PLIB_PORTS_PinSet(PORTS_ID_0, PORT_CHANNEL_None, PORTS_BIT_POS_-1)
#define InBC11Off() PLIB_PORTS_PinClear(PORTS_ID_0, PORT_CHANNEL_None, PORTS_BIT_POS_-1)
#define InBC11StateGet() PLIB_PORTS_PinGetLatched(PORTS_ID_0, PORT_CHANNEL_None, PORTS_BIT_POS_-1)
#define InBC11StateSet(Value) PLIB_PORTS_PinWrite(PORTS_ID_0, PORT_CHANNEL_None, PORTS_BIT_POS_-1, Value)

/*** Functions for InBC12 pin ***/
#define InBC12Toggle() PLIB_PORTS_PinToggle(PORTS_ID_0, PORT_CHANNEL_None, PORTS_BIT_POS_-1)
#define InBC12On() PLIB_PORTS_PinSet(PORTS_ID_0, PORT_CHANNEL_None, PORTS_BIT_POS_-1)
#define InBC12Off() PLIB_PORTS_PinClear(PORTS_ID_0, PORT_CHANNEL_None, PORTS_BIT_POS_-1)
#define InBC12StateGet() PLIB_PORTS_PinGetLatched(PORTS_ID_0, PORT_CHANNEL_None, PORTS_BIT_POS_-1)
#define InBC12StateSet(Value) PLIB_PORTS_PinWrite(PORTS_ID_0, PORT_CHANNEL_None, PORTS_BIT_POS_-1, Value)

/*** Functions for InBC2 pin ***/
#define InBC2Toggle() PLIB_PORTS_PinToggle(PORTS_ID_0, PORT_CHANNEL_None, PORTS_BIT_POS_-1)
#define InBC2On() PLIB_PORTS_PinSet(PORTS_ID_0, PORT_CHANNEL_None, PORTS_BIT_POS_-1)
#define InBC2Off() PLIB_PORTS_PinClear(PORTS_ID_0, PORT_CHANNEL_None, PORTS_BIT_POS_-1)
#define InBC2StateGet() PLIB_PORTS_PinGetLatched(PORTS_ID_0, PORT_CHANNEL_None, PORTS_BIT_POS_-1)
#define InBC2StateSet(Value) PLIB_PORTS_PinWrite(PORTS_ID_0, PORT_CHANNEL_None, PORTS_BIT_POS_-1, Value)

/*** Functions for InBC13 pin ***/
#define InBC13Toggle() PLIB_PORTS_PinToggle(PORTS_ID_0, PORT_CHANNEL_None, PORTS_BIT_POS_-1)
#define InBC13On() PLIB_PORTS_PinSet(PORTS_ID_0, PORT_CHANNEL_None, PORTS_BIT_POS_-1)
#define InBC13Off() PLIB_PORTS_PinClear(PORTS_ID_0, PORT_CHANNEL_None, PORTS_BIT_POS_-1)
#define InBC13StateGet() PLIB_PORTS_PinGetLatched(PORTS_ID_0, PORT_CHANNEL_None, PORTS_BIT_POS_-1)
#define InBC13StateSet(Value) PLIB_PORTS_PinWrite(PORTS_ID_0, PORT_CHANNEL_None, PORTS_BIT_POS_-1, Value)

/*** Functions for InBC14 pin ***/
#define InBC14Toggle() PLIB_PORTS_PinToggle(PORTS_ID_0, PORT_CHANNEL_D, PORTS_BIT_POS_8)
#define InBC14On() PLIB_PORTS_PinSet(PORTS_ID_0, PORT_CHANNEL_D, PORTS_BIT_POS_8)
#define InBC14Off() PLIB_PORTS_PinClear(PORTS_ID_0, PORT_CHANNEL_D, PORTS_BIT_POS_8)
#define InBC14StateGet() PLIB_PORTS_PinGetLatched(PORTS_ID_0, PORT_CHANNEL_D, PORTS_BIT_POS_8)
#define InBC14StateSet(Value) PLIB_PORTS_PinWrite(PORTS_ID_0, PORT_CHANNEL_D, PORTS_BIT_POS_8, Value)

/*** Functions for InBC15 pin ***/
#define InBC15Toggle() PLIB_PORTS_PinToggle(PORTS_ID_0, PORT_CHANNEL_D, PORTS_BIT_POS_9)
#define InBC15On() PLIB_PORTS_PinSet(PORTS_ID_0, PORT_CHANNEL_D, PORTS_BIT_POS_9)
#define InBC15Off() PLIB_PORTS_PinClear(PORTS_ID_0, PORT_CHANNEL_D, PORTS_BIT_POS_9)
#define InBC15StateGet() PLIB_PORTS_PinGetLatched(PORTS_ID_0, PORT_CHANNEL_D, PORTS_BIT_POS_9)
#define InBC15StateSet(Value) PLIB_PORTS_PinWrite(PORTS_ID_0, PORT_CHANNEL_D, PORTS_BIT_POS_9, Value)

/*** Functions for InBC16 pin ***/
#define InBC16Toggle() PLIB_PORTS_PinToggle(PORTS_ID_0, PORT_CHANNEL_D, PORTS_BIT_POS_10)
#define InBC16On() PLIB_PORTS_PinSet(PORTS_ID_0, PORT_CHANNEL_D, PORTS_BIT_POS_10)
#define InBC16Off() PLIB_PORTS_PinClear(PORTS_ID_0, PORT_CHANNEL_D, PORTS_BIT_POS_10)
#define InBC16StateGet() PLIB_PORTS_PinGetLatched(PORTS_ID_0, PORT_CHANNEL_D, PORTS_BIT_POS_10)
#define InBC16StateSet(Value) PLIB_PORTS_PinWrite(PORTS_ID_0, PORT_CHANNEL_D, PORTS_BIT_POS_10, Value)

/*** Functions for InC15 pin ***/
#define InC15Toggle() PLIB_PORTS_PinToggle(PORTS_ID_0, PORT_CHANNEL_C, PORTS_BIT_POS_13)
#define InC15On() PLIB_PORTS_PinSet(PORTS_ID_0, PORT_CHANNEL_C, PORTS_BIT_POS_13)
#define InC15Off() PLIB_PORTS_PinClear(PORTS_ID_0, PORT_CHANNEL_C, PORTS_BIT_POS_13)
#define InC15StateGet() PLIB_PORTS_PinGetLatched(PORTS_ID_0, PORT_CHANNEL_C, PORTS_BIT_POS_13)
#define InC15StateSet(Value) PLIB_PORTS_PinWrite(PORTS_ID_0, PORT_CHANNEL_C, PORTS_BIT_POS_13, Value)

/*** Functions for InC16 pin ***/
#define InC16Toggle() PLIB_PORTS_PinToggle(PORTS_ID_0, PORT_CHANNEL_C, PORTS_BIT_POS_14)
#define InC16On() PLIB_PORTS_PinSet(PORTS_ID_0, PORT_CHANNEL_C, PORTS_BIT_POS_14)
#define InC16Off() PLIB_PORTS_PinClear(PORTS_ID_0, PORT_CHANNEL_C, PORTS_BIT_POS_14)
#define InC16StateGet() PLIB_PORTS_PinGetLatched(PORTS_ID_0, PORT_CHANNEL_C, PORTS_BIT_POS_14)
#define InC16StateSet(Value) PLIB_PORTS_PinWrite(PORTS_ID_0, PORT_CHANNEL_C, PORTS_BIT_POS_14, Value)

/*** Functions for InBC3 pin ***/
#define InBC3Toggle() PLIB_PORTS_PinToggle(PORTS_ID_0, PORT_CHANNEL_F, PORTS_BIT_POS_0)
#define InBC3On() PLIB_PORTS_PinSet(PORTS_ID_0, PORT_CHANNEL_F, PORTS_BIT_POS_0)
#define InBC3Off() PLIB_PORTS_PinClear(PORTS_ID_0, PORT_CHANNEL_F, PORTS_BIT_POS_0)
#define InBC3StateGet() PLIB_PORTS_PinGetLatched(PORTS_ID_0, PORT_CHANNEL_F, PORTS_BIT_POS_0)
#define InBC3StateSet(Value) PLIB_PORTS_PinWrite(PORTS_ID_0, PORT_CHANNEL_F, PORTS_BIT_POS_0, Value)

/*** Functions for InBC4 pin ***/
#define InBC4Toggle() PLIB_PORTS_PinToggle(PORTS_ID_0, PORT_CHANNEL_F, PORTS_BIT_POS_1)
#define InBC4On() PLIB_PORTS_PinSet(PORTS_ID_0, PORT_CHANNEL_F, PORTS_BIT_POS_1)
#define InBC4Off() PLIB_PORTS_PinClear(PORTS_ID_0, PORT_CHANNEL_F, PORTS_BIT_POS_1)
#define InBC4StateGet() PLIB_PORTS_PinGetLatched(PORTS_ID_0, PORT_CHANNEL_F, PORTS_BIT_POS_1)
#define InBC4StateSet(Value) PLIB_PORTS_PinWrite(PORTS_ID_0, PORT_CHANNEL_F, PORTS_BIT_POS_1, Value)

/*** Functions for InBC5 pin ***/
#define InBC5Toggle() PLIB_PORTS_PinToggle(PORTS_ID_0, PORT_CHANNEL_E, PORTS_BIT_POS_0)
#define InBC5On() PLIB_PORTS_PinSet(PORTS_ID_0, PORT_CHANNEL_E, PORTS_BIT_POS_0)
#define InBC5Off() PLIB_PORTS_PinClear(PORTS_ID_0, PORT_CHANNEL_E, PORTS_BIT_POS_0)
#define InBC5StateGet() PLIB_PORTS_PinGetLatched(PORTS_ID_0, PORT_CHANNEL_E, PORTS_BIT_POS_0)
#define InBC5StateSet(Value) PLIB_PORTS_PinWrite(PORTS_ID_0, PORT_CHANNEL_E, PORTS_BIT_POS_0, Value)

/*** Functions for Buzzer pin ***/
#define BuzzerToggle() PLIB_PORTS_PinToggle(PORTS_ID_0, PORT_CHANNEL_E, PORTS_BIT_POS_1)
#define BuzzerOn() PLIB_PORTS_PinSet(PORTS_ID_0, PORT_CHANNEL_E, PORTS_BIT_POS_1)
#define BuzzerOff() PLIB_PORTS_PinClear(PORTS_ID_0, PORT_CHANNEL_E, PORTS_BIT_POS_1)
#define BuzzerStateGet() PLIB_PORTS_PinGetLatched(PORTS_ID_0, PORT_CHANNEL_E, PORTS_BIT_POS_1)
#define BuzzerStateSet(Value) PLIB_PORTS_PinWrite(PORTS_ID_0, PORT_CHANNEL_E, PORTS_BIT_POS_1, Value)

/*** Functions for CMD_MLDP pin ***/
#define CMD_MLDPToggle() PLIB_PORTS_PinToggle(PORTS_ID_0, PORT_CHANNEL_A, PORTS_BIT_POS_14)
#define CMD_MLDPOn() PLIB_PORTS_PinSet(PORTS_ID_0, PORT_CHANNEL_A, PORTS_BIT_POS_14)
#define CMD_MLDPOff() PLIB_PORTS_PinClear(PORTS_ID_0, PORT_CHANNEL_A, PORTS_BIT_POS_14)
#define CMD_MLDPStateGet() PLIB_PORTS_PinGetLatched(PORTS_ID_0, PORT_CHANNEL_A, PORTS_BIT_POS_14)
#define CMD_MLDPStateSet(Value) PLIB_PORTS_PinWrite(PORTS_ID_0, PORT_CHANNEL_A, PORTS_BIT_POS_14, Value)

/*** Functions for SWAKE pin ***/
#define SWAKEToggle() PLIB_PORTS_PinToggle(PORTS_ID_0, PORT_CHANNEL_A, PORTS_BIT_POS_15)
#define SWAKEOn() PLIB_PORTS_PinSet(PORTS_ID_0, PORT_CHANNEL_A, PORTS_BIT_POS_15)
#define SWAKEOff() PLIB_PORTS_PinClear(PORTS_ID_0, PORT_CHANNEL_A, PORTS_BIT_POS_15)
#define SWAKEStateGet() PLIB_PORTS_PinGetLatched(PORTS_ID_0, PORT_CHANNEL_A, PORTS_BIT_POS_15)
#define SWAKEStateSet(Value) PLIB_PORTS_PinWrite(PORTS_ID_0, PORT_CHANNEL_A, PORTS_BIT_POS_15, Value)

/*** Functions for InC9 pin ***/
#define InC9Toggle() PLIB_PORTS_PinToggle(PORTS_ID_0, PORT_CHANNEL_D, PORTS_BIT_POS_8)
#define InC9On() PLIB_PORTS_PinSet(PORTS_ID_0, PORT_CHANNEL_D, PORTS_BIT_POS_8)
#define InC9Off() PLIB_PORTS_PinClear(PORTS_ID_0, PORT_CHANNEL_D, PORTS_BIT_POS_8)
#define InC9StateGet() PLIB_PORTS_PinGetLatched(PORTS_ID_0, PORT_CHANNEL_D, PORTS_BIT_POS_8)
#define InC9StateSet(Value) PLIB_PORTS_PinWrite(PORTS_ID_0, PORT_CHANNEL_D, PORTS_BIT_POS_8, Value)

/*** Functions for InC10 pin ***/
#define InC10Toggle() PLIB_PORTS_PinToggle(PORTS_ID_0, PORT_CHANNEL_D, PORTS_BIT_POS_9)
#define InC10On() PLIB_PORTS_PinSet(PORTS_ID_0, PORT_CHANNEL_D, PORTS_BIT_POS_9)
#define InC10Off() PLIB_PORTS_PinClear(PORTS_ID_0, PORT_CHANNEL_D, PORTS_BIT_POS_9)
#define InC10StateGet() PLIB_PORTS_PinGetLatched(PORTS_ID_0, PORT_CHANNEL_D, PORTS_BIT_POS_9)
#define InC10StateSet(Value) PLIB_PORTS_PinWrite(PORTS_ID_0, PORT_CHANNEL_D, PORTS_BIT_POS_9, Value)

/*** Functions for InC11 pin ***/
#define InC11Toggle() PLIB_PORTS_PinToggle(PORTS_ID_0, PORT_CHANNEL_D, PORTS_BIT_POS_10)
#define InC11On() PLIB_PORTS_PinSet(PORTS_ID_0, PORT_CHANNEL_D, PORTS_BIT_POS_10)
#define InC11Off() PLIB_PORTS_PinClear(PORTS_ID_0, PORT_CHANNEL_D, PORTS_BIT_POS_10)
#define InC11StateGet() PLIB_PORTS_PinGetLatched(PORTS_ID_0, PORT_CHANNEL_D, PORTS_BIT_POS_10)
#define InC11StateSet(Value) PLIB_PORTS_PinWrite(PORTS_ID_0, PORT_CHANNEL_D, PORTS_BIT_POS_10, Value)

/*** Functions for InC12 pin ***/
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
#define InC6Off() PLIB_PORTS_PinClear(PORTS_ID_0, PORT_CHANNEL_D, PORTS_BIT_POS_5)
#define InC6StateGet() PLIB_PORTS_PinGetLatched(PORTS_ID_0, PORT_CHANNEL_D, PORTS_BIT_POS_5)
#define InC6StateSet(Value) PLIB_PORTS_PinWrite(PORTS_ID_0, PORT_CHANNEL_D, PORTS_BIT_POS_5, Value)

/*** Functions for InC7 pin ***/
#define InC7Toggle() PLIB_PORTS_PinToggle(PORTS_ID_0, PORT_CHANNEL_D, PORTS_BIT_POS_6)
#define InC7On() PLIB_PORTS_PinSet(PORTS_ID_0, PORT_CHANNEL_D, PORTS_BIT_POS_6)
#define InC7Off() PLIB_PORTS_PinClear(PORTS_ID_0, PORT_CHANNEL_D, PORTS_BIT_POS_6)
#define InC7StateGet() PLIB_PORTS_PinGetLatched(PORTS_ID_0, PORT_CHANNEL_D, PORTS_BIT_POS_6)
#define InC7StateSet(Value) PLIB_PORTS_PinWrite(PORTS_ID_0, PORT_CHANNEL_D, PORTS_BIT_POS_6, Value)

/*** Functions for InC8 pin ***/
#define InC8Toggle() PLIB_PORTS_PinToggle(PORTS_ID_0, PORT_CHANNEL_D, PORTS_BIT_POS_7)
#define InC8On() PLIB_PORTS_PinSet(PORTS_ID_0, PORT_CHANNEL_D, PORTS_BIT_POS_7)
#define InC8Off() PLIB_PORTS_PinClear(PORTS_ID_0, PORT_CHANNEL_D, PORTS_BIT_POS_7)
#define InC8StateGet() PLIB_PORTS_PinGetLatched(PORTS_ID_0, PORT_CHANNEL_D, PORTS_BIT_POS_7)
#define InC8StateSet(Value) PLIB_PORTS_PinWrite(PORTS_ID_0, PORT_CHANNEL_D, PORTS_BIT_POS_7, Value)

/*** Functions for InBC7 pin ***/
#define InBC7Toggle() PLIB_PORTS_PinToggle(PORTS_ID_0, PORT_CHANNEL_A, PORTS_BIT_POS_6)
#define InBC7On() PLIB_PORTS_PinSet(PORTS_ID_0, PORT_CHANNEL_A, PORTS_BIT_POS_6)
#define InBC7Off() PLIB_PORTS_PinClear(PORTS_ID_0, PORT_CHANNEL_A, PORTS_BIT_POS_6)
#define InBC7StateGet() PLIB_PORTS_PinGetLatched(PORTS_ID_0, PORT_CHANNEL_A, PORTS_BIT_POS_6)
#define InBC7StateSet(Value) PLIB_PORTS_PinWrite(PORTS_ID_0, PORT_CHANNEL_A, PORTS_BIT_POS_6, Value)

/*** Functions for InBC8 pin ***/
#define InBC8Toggle() PLIB_PORTS_PinToggle(PORTS_ID_0, PORT_CHANNEL_A, PORTS_BIT_POS_7)
#define InBC8On() PLIB_PORTS_PinSet(PORTS_ID_0, PORT_CHANNEL_A, PORTS_BIT_POS_7)
#define InBC8Off() PLIB_PORTS_PinClear(PORTS_ID_0, PORT_CHANNEL_A, PORTS_BIT_POS_7)
#define InBC8StateGet() PLIB_PORTS_PinGetLatched(PORTS_ID_0, PORT_CHANNEL_A, PORTS_BIT_POS_7)
#define InBC8StateSet(Value) PLIB_PORTS_PinWrite(PORTS_ID_0, PORT_CHANNEL_A, PORTS_BIT_POS_7, Value)

/*** Functions for CS_GYRO pin ***/
#define CS_GYROToggle() PLIB_PORTS_PinToggle(PORTS_ID_0, PORT_CHANNEL_E, PORTS_BIT_POS_0)
#define CS_GYROOn() PLIB_PORTS_PinSet(PORTS_ID_0, PORT_CHANNEL_E, PORTS_BIT_POS_0)
#define CS_GYROOff() PLIB_PORTS_PinClear(PORTS_ID_0, PORT_CHANNEL_E, PORTS_BIT_POS_0)
#define CS_GYROStateGet() PLIB_PORTS_PinGetLatched(PORTS_ID_0, PORT_CHANNEL_E, PORTS_BIT_POS_0)
#define CS_GYROStateSet(Value) PLIB_PORTS_PinWrite(PORTS_ID_0, PORT_CHANNEL_E, PORTS_BIT_POS_0, Value)

/*** Functions for ConfigIO pin ***/
#define ConfigIOToggle() PLIB_PORTS_PinToggle(PORTS_ID_0, PORT_CHANNEL_E, PORTS_BIT_POS_1)
#define ConfigIOOn() PLIB_PORTS_PinSet(PORTS_ID_0, PORT_CHANNEL_E, PORTS_BIT_POS_1)
#define ConfigIOOff() PLIB_PORTS_PinClear(PORTS_ID_0, PORT_CHANNEL_E, PORTS_BIT_POS_1)
#define ConfigIOStateGet() PLIB_PORTS_PinGetLatched(PORTS_ID_0, PORT_CHANNEL_E, PORTS_BIT_POS_1)
#define ConfigIOStateSet(Value) PLIB_PORTS_PinWrite(PORTS_ID_0, PORT_CHANNEL_E, PORTS_BIT_POS_1, Value)

/*** Functions for BT_WAKE pin ***/
#define BT_WAKEToggle() PLIB_PORTS_PinToggle(PORTS_ID_0, PORT_CHANNEL_E, PORTS_BIT_POS_3)
#define BT_WAKEOn() PLIB_PORTS_PinSet(PORTS_ID_0, PORT_CHANNEL_E, PORTS_BIT_POS_3)
#define BT_WAKEOff() PLIB_PORTS_PinClear(PORTS_ID_0, PORT_CHANNEL_E, PORTS_BIT_POS_3)
#define BT_WAKEStateGet() PLIB_PORTS_PinGetLatched(PORTS_ID_0, PORT_CHANNEL_E, PORTS_BIT_POS_3)
#define BT_WAKEStateSet(Value) PLIB_PORTS_PinWrite(PORTS_ID_0, PORT_CHANNEL_E, PORTS_BIT_POS_3, Value)

/*** Functions for USBDetect pin ***/
#define USBDetectStateGet() PLIB_PORTS_PinGet(PORTS_ID_0, PORT_CHANNEL_D, PORTS_BIT_POS_3)

/*** Functions for BT_RX pin ***/
#define BT_RXStateGet() PLIB_PORTS_PinGet(PORTS_ID_0, PORT_CHANNEL_D, PORTS_BIT_POS_4)

/*** Functions for BT_TX pin ***/
#define BT_TXStateGet() PLIB_PORTS_PinGet(PORTS_ID_0, PORT_CHANNEL_D, PORTS_BIT_POS_5)

/*** Functions for SW_DOWN pin ***/
#define SW_DOWNStateGet() PLIB_PORTS_PinGet(PORTS_ID_0, PORT_CHANNEL_E, PORTS_BIT_POS_2)

/*** Functions for SW_SEL pin ***/
#define SW_SELStateGet() PLIB_PORTS_PinGet(PORTS_ID_0, PORT_CHANNEL_E, PORTS_BIT_POS_3)

/*** Functions for SW_UP pin ***/
#define SW_UPStateGet() PLIB_PORTS_PinGet(PORTS_ID_0, PORT_CHANNEL_E, PORTS_BIT_POS_4)

/*** Functions for Haut pin ***/
#define HautStateGet() PLIB_PORTS_PinGet(PORTS_ID_0, PORT_CHANNEL_G, PORTS_BIT_POS_14)

/*** Functions for Bas pin ***/
#define BasStateGet() PLIB_PORTS_PinGet(PORTS_ID_0, PORT_CHANNEL_G, PORTS_BIT_POS_12)

/*** Functions for HMConfig pin ***/
#define HMConfigStateGet() PLIB_PORTS_PinGet(PORTS_ID_0, PORT_CHANNEL_G, PORTS_BIT_POS_13)


/*** Application Instance 0 Configuration ***/

//DOM-IGNORE-BEGIN
#ifdef __cplusplus
}
#endif
//DOM-IGNORE-END

#endif // _SYSTEM_CONFIG_H
/*******************************************************************************
 End of File
*/
