SwissMaverick/PROJ-2008_SablierElectronique/2008_SablierElectronique/soft/2008D_Sablier_electronique_backup/firmware/src/Mc32gest_RS232.h

#ifndef Mc32Gest_RS232_H
#define Mc32Gest_RS232_H
/*--------------------------------------------------------*/
// Mc32Gest_RS232.h
/*--------------------------------------------------------*/
//	Description :	emission et reception spécialisée
//			        pour TP2 2016-2017
//
//	Auteur 		: 	C. HUBER
//
//	Version		:	V1.3
//	Compilateur	:	XC32 V1.42 + Harmony 1.08
//
/*--------------------------------------------------------*/

#include <stdint.h>
#include "GesFifoTh32.h"

/*--------------------------------------------------------*/
// Définition des fonctions prototypes
/*--------------------------------------------------------*/

// prototypes des fonctions
void InitFifoComm(void);
int GetMessage(char *pData);
void SendMessage(char *pData);

// Descripteur des fifos
extern S_fifo descrFifoRX;
extern S_fifo descrFifoTX;

#endif
